Mehdi-Ldj/usb3-dock/docs/renders/board-3d-top.png

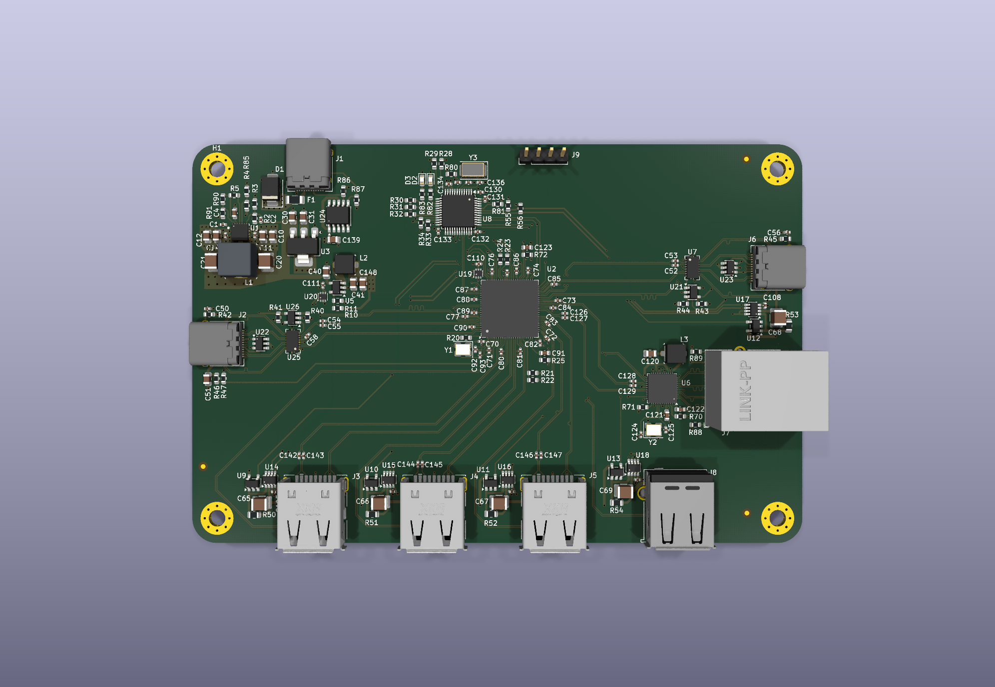
docs/renders/board-3d-top.png
