Mehdi-Ldj/usb3-dock/hardware/rev-a/usb3-dock-jlcpcb-bom.csv

Comment | Designator | Footprint | JLCPCB Part # | MPN
100n | C1,C50,C52,C53,C54,C55,C56,C58,C70,C71,C72,C73,C74,C75,C76,C77,C80,C81,C82,C83,C84,C85,C86,C87,C88,C89,C90,C105,C106,C107,C108,C109,C110,C111,C126,C127,C128,C129,C130,C131,C132,C133,C134,C138,C142,C143,C144,C145,C146,C147 | Capacitor_SMD:C_0402_1005Metric | C1525 | CL05B104KO5NNNC
100p | C2 | Capacitor_SMD:C_0402_1005Metric | C1546 | 0402CG101J500NT
4u7 | C4 | Capacitor_SMD:C_0603_1608Metric | C326580 | CC0603KRX5R8BB475
10u | C10,C11,C12,C30,C31,C40,C41,C51,C120,C141,C148 | Capacitor_SMD:C_0805_2012Metric | C380332 | TCC0805X5R106K160FT
100n | C13,C140 | Capacitor_SMD:C_0402_1005Metric | C307331 | CL05B104KB54PNC
100u | C20,C21,C65,C66,C67,C68,C69 | Capacitor_SMD:C_1210_3225Metric | C6120014 | CGA1210X5R107M160RT
1u | C91,C121,C122,C123 | Capacitor_SMD:C_0603_1608Metric | C696901 | TCC0603X5R105K160CT
18p | C92,C93,C124,C125,C136,C137 | Capacitor_SMD:C_0402_1005Metric | C1549 | 0402CG180J500NT
1u | C139 | Capacitor_SMD:C_0805_2012Metric | C89190 | 0805B105K250NT
SMBJ15A | D1 | Diode_SMD:D_SMB | C113988 | SMBJ15A
LED | D2,D3 | LED_SMD:LED_0603_1608Metric | C2286 | KT-0603R
3A | F1 | Fuse:Fuse_1206_3216Metric | C41342 | 0468003.NRHF
USB_C | J1,J2,J6 | Connector_USB:USB_C_Receptacle_Amphenol_12401610E4-2A | C5119948 | 12401610E4#2A
USB3_A | J3,J4,J5 | dock:USB_A_Receptacle_XKB_U231-091N-4BLRA00-S | C2880618 | U231-091N-4BLRA00-S
RJ45 MagJack | J7 | dock:RJ45_Hanrun_HR911130A | C54408 | HR911130A
USB_A | J8 | Connector_USB:USB_A_Molex_67643_Horizontal | C564920 | 67643-2910
SWD | J9 | Connector_PinHeader_2.54mm:PinHeader_1x04_P2.54mm_Vertical | C2691448 | PZ254V-11-04P
4u7 | L1 | dock:L_7.1x6.6mm_CMLO0650H | C439009 | CMLO0650H4R7MTT
2u2 | L2 | dock:L_4x4mm_PNR4020 | C54620130 | PNR4020-2R2M
3u3 | L3 | dock:L_4x4mm_FNR4030 | C167870 | FNR4030S3R3MT
73k2 | R2 | Resistor_SMD:R_0603_1608Metric | C14890 | 0603WAF7322T5E
56k | R4,R43,R44 | Resistor_SMD:R_0603_1608Metric | C23206 | 0603WAF5602T5E
100k | R10,R11,R28,R29,R30,R31,R32,R46,R47 | Resistor_SMD:R_0603_1608Metric | C25803 | 0603WAF1003T5E
12k | R20,R71 | Resistor_SMD:R_0603_1608Metric | C22790 | 0603WAF1202T5E
200k | R21,R23,R24,R90 | Resistor_SMD:R_0603_1608Metric | C25811 | 0603WAF2003T5E
10k | R3,R5,R25,R33,R34,R72,R80,R81,R85,R91 | Resistor_SMD:R_0603_1608Metric | C25804 | 0603WAF1002T5E
5k1 | R40,R41,R86,R87 | Resistor_SMD:R_0603_1608Metric | C23186 | 0603WAF5101T5E
330 | R42,R45,R88,R89 | Resistor_SMD:R_0603_1608Metric | C23138 | 0603WAF3300T5E
0R1 | R50,R51,R52,R53,R54 | Resistor_SMD:R_0805_2012Metric | C160917 | RL10FTNR100
4k7 | R55,R56 | Resistor_SMD:R_0603_1608Metric | C23162 | 0603WAF4701T5E
2k | R70 | Resistor_SMD:R_0603_1608Metric | C22975 | 0603WAF2001T5E
1k | R82,R83 | Resistor_SMD:R_0603_1608Metric | C21190 | 0603WAF1001T5E
TPS56C215 | U1 | dock:Texas_RNN0018A_TPS56C215 | C473372 | TPS56C215RNNR
USB5807C | U2 | dock:VQFN-100-1EP_12x12mm_P0.4mm_EP8x8mm | C628616 | USB5807CT/KD
TLV76133 | U3 | Package_TO_SOT_SMD:SOT-223-3_TabPin2 | C7527500 | TLV76133DCYR
TLV62569 | U5 | Package_TO_SOT_SMD:SOT-23-5 | C141836 | TLV62569DBVR
LAN7800 | U6 | dock:QFN-48-1EP_6x6mm_P0.4mm_EP4.3x4.3mm | C625080 | LAN7800T-I/VSX
STM32F072C8 | U8 | Package_QFP:LQFP-48_7x7mm_P0.5mm | C80488 | STM32F072C8T6
TPS2065 | U9,U10,U11,U12,U13 | Package_TO_SOT_SMD:SOT-23-5 | C133792 | TPS2065DBVR
INA219 | U14,U15,U16,U17,U18 | Package_TO_SOT_SMD:SOT-23-8 | C87469 | INA219AIDCNR
TMP112 | U19,U20 | Package_TO_SOT_SMD:SOT-563 | C3019123 | TMP112BIDRLR
TLV7031 | U21,U26 | Package_TO_SOT_SMD:SOT-23-5 | C2869832 | TLV7031DBVR
SRV05-4 | U22,U23 | Package_TO_SOT_SMD:SOT-23-6 | C13612 | SRV05-4.TCT
CH224A | U24 | Package_SO:SSOP-10-1EP_3.9x4.9mm_P1mm_EP2.1x3.3mm | C42459160 | CH224A
HD3SS3212 | U7,U25 | dock:DHVQFN-20-1EP_2.5x4.5mm_P0.5mm_EP1x3mm_TI | C544517 | HD3SS3212IRKSR
25 MHz | Y1,Y2 | Crystal:Crystal_SMD_3225-4Pin_3.2x2.5mm | C70582 | X322525MMB4SI
8 MHz | Y3 | Crystal:Crystal_SMD_5032-2Pin_5.0x3.2mm | C115962 | X50328MSB2GI
