Mehdi-Ldj/usb3-dock/hardware/rev-a/3dmodels/lpjg0806fbnl.stp

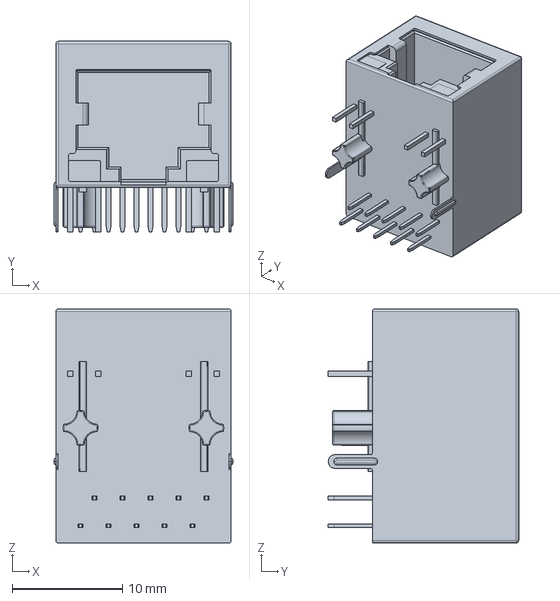
[picture p8: CAD file, 2026-11-11]
hardware/rev-a/3dmodels/lpjg0806fbnl.stp
16.2 x 17.3 x 21.2 mm
LPJGXXXXFBNL-490
1X1-TAB-DOWN-213MM-PCB10-P490-L
