Mehdi-Ldj/usb3-dock/hardware/rev-a/3dmodels/U7_HD3SS3212_RKS0020A.stp

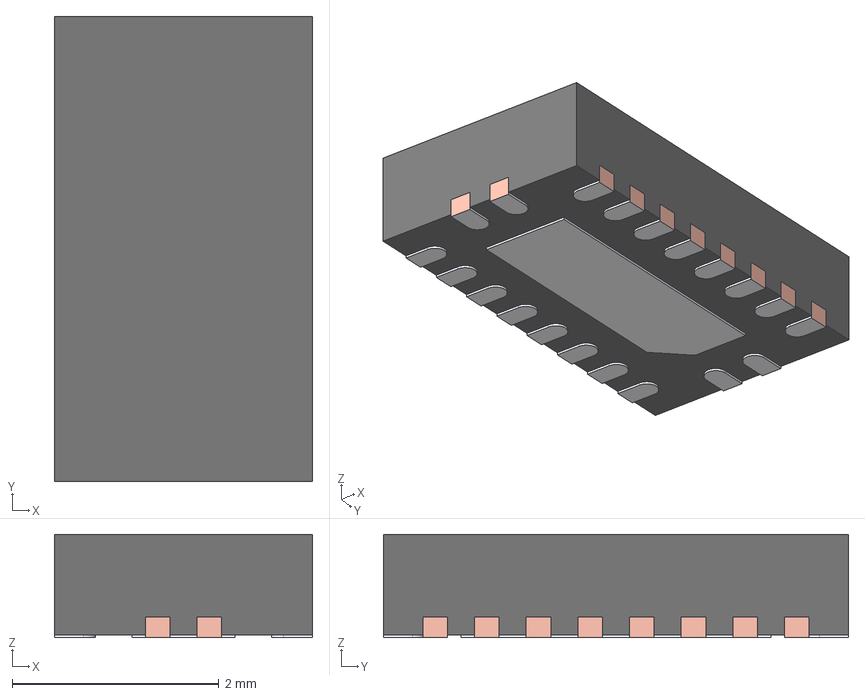
[picture p9: CAD file, 2026-11-11]
hardware/rev-a/3dmodels/U7_HD3SS3212_RKS0020A.stp
2.50 x 4.50 x 1.00 mm
BODY-QFN
FRAME-RKS0020A
PIN1-ID
