Mehdi-Ldj/usb3-dock/hardware/rev-a/3dmodels/J3_XKB_U231-091N.stp

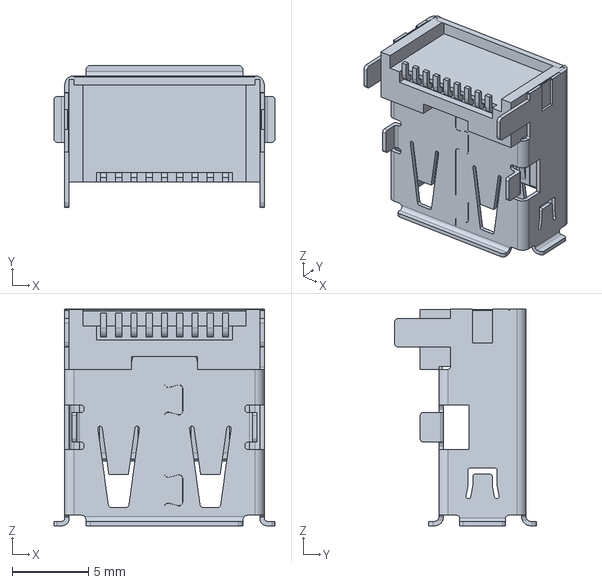
[picture p10: CAD file, 2026-11-11]
hardware/rev-a/3dmodels/J3_XKB_U231-091N.stp
14.5 x 9.34 x 14.2 mm
