Mehdi-Ldj/usb3-dock/hardware/rev-a/3dmodels/U1_TPS56C215_RNN0018A.stp

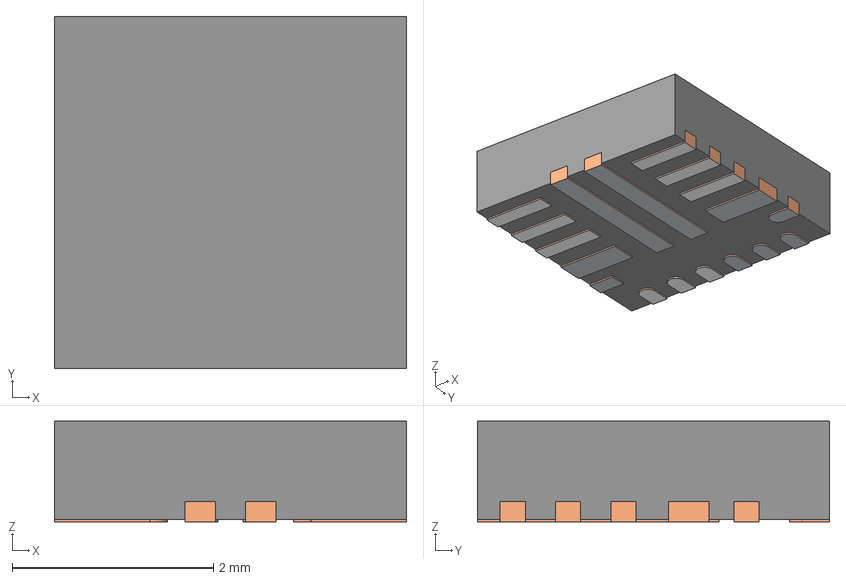
[picture p11: CAD file, 2026-11-11]
hardware/rev-a/3dmodels/U1_TPS56C215_RNN0018A.stp
3.50 x 3.50 x 1.00 mm
FRAME-RNN0018A
BODY-QFN
PIN1-ID
