Mehdi-Ldj/usb3-dock/hardware/rev-a/3dmodels/U2_USB5807C_VQFN100.step

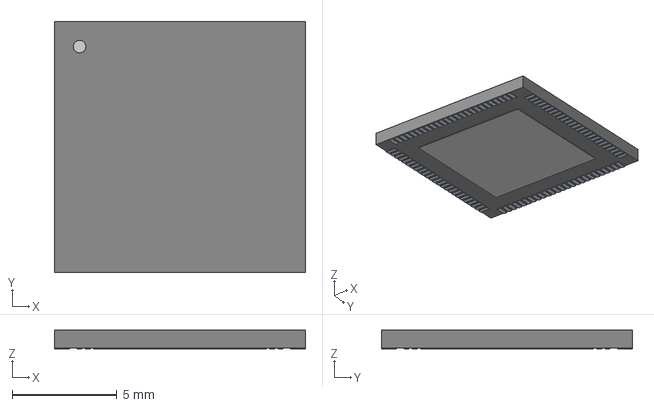
[picture p12: CAD file, 2026-11-11]
hardware/rev-a/3dmodels/U2_USB5807C_VQFN100.step
12.0 x 12.0 x 0.892 mm
