Mehdi-Ldj/usb3-dock/hardware/rev-a/3dmodels/U6_LAN7800_SQFN48.step

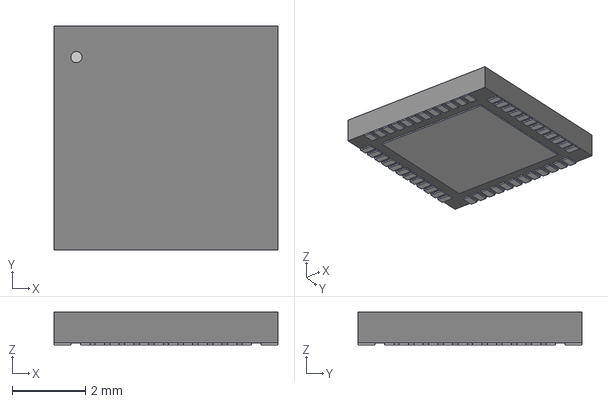
[picture p13: CAD file, 2026-11-11]
hardware/rev-a/3dmodels/U6_LAN7800_SQFN48.step
6.10 x 6.10 x 0.892 mm
