Mehdi-Ldj/usb3-dock/docs/renders/schematic-rev-a.pdf

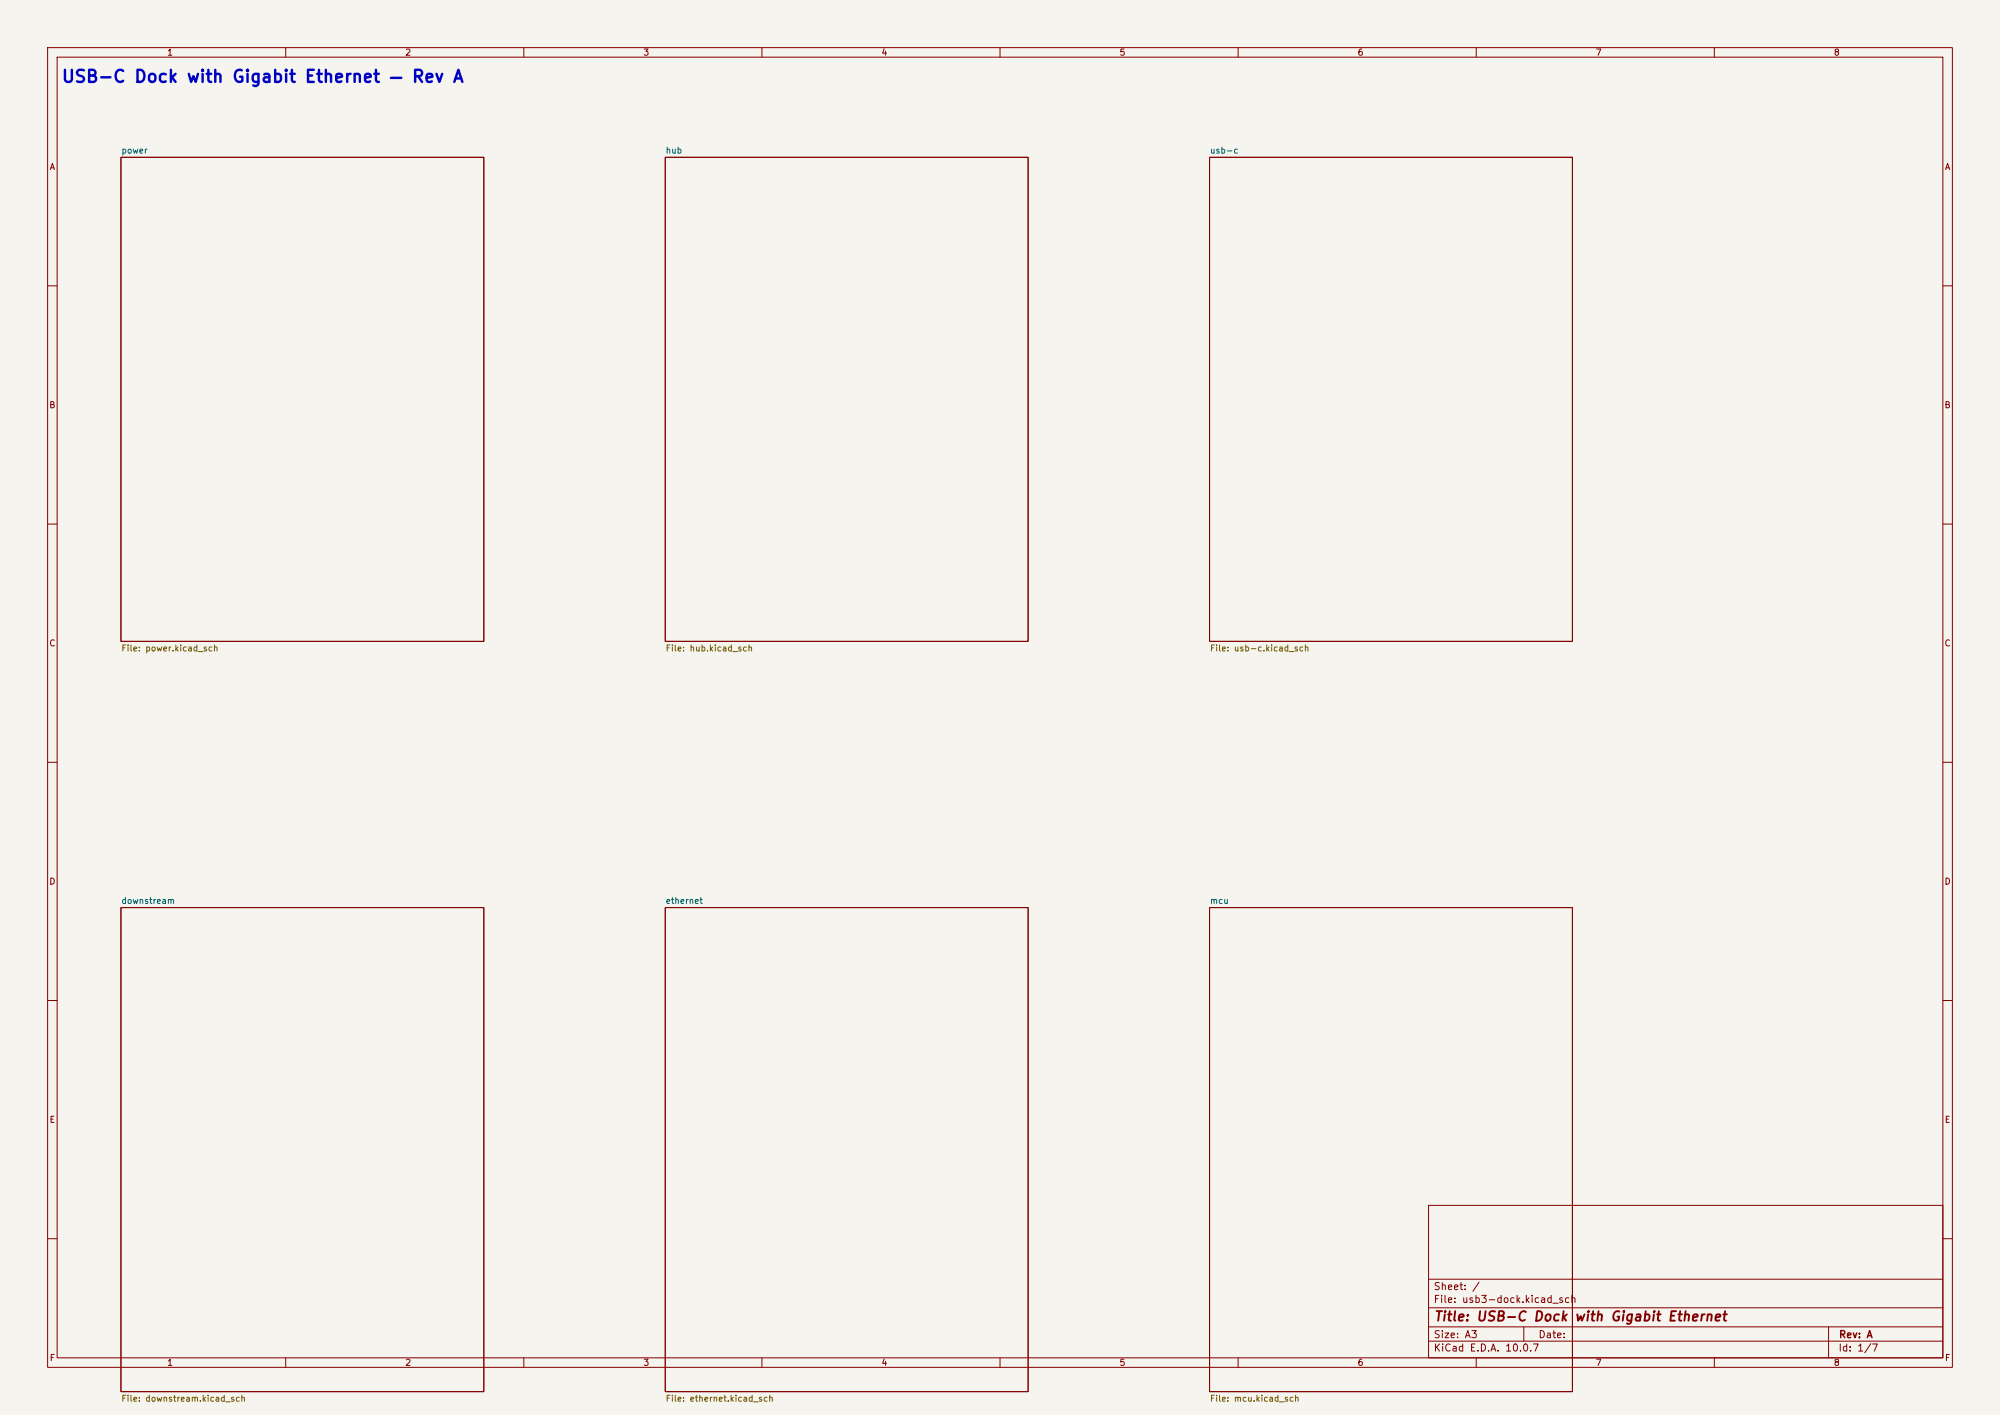
[picture p14: page 1]

USB-C Dock with Gigabit Ethernet — Rev A

Sheet: / File: usb3-dock.kicad_sch

Title: USB-C Dock with Gigabit Ethernet
Size: A3 | Rev: A | F Date:
KiCad E.D.A. 10.0.7 | Id: 1/7

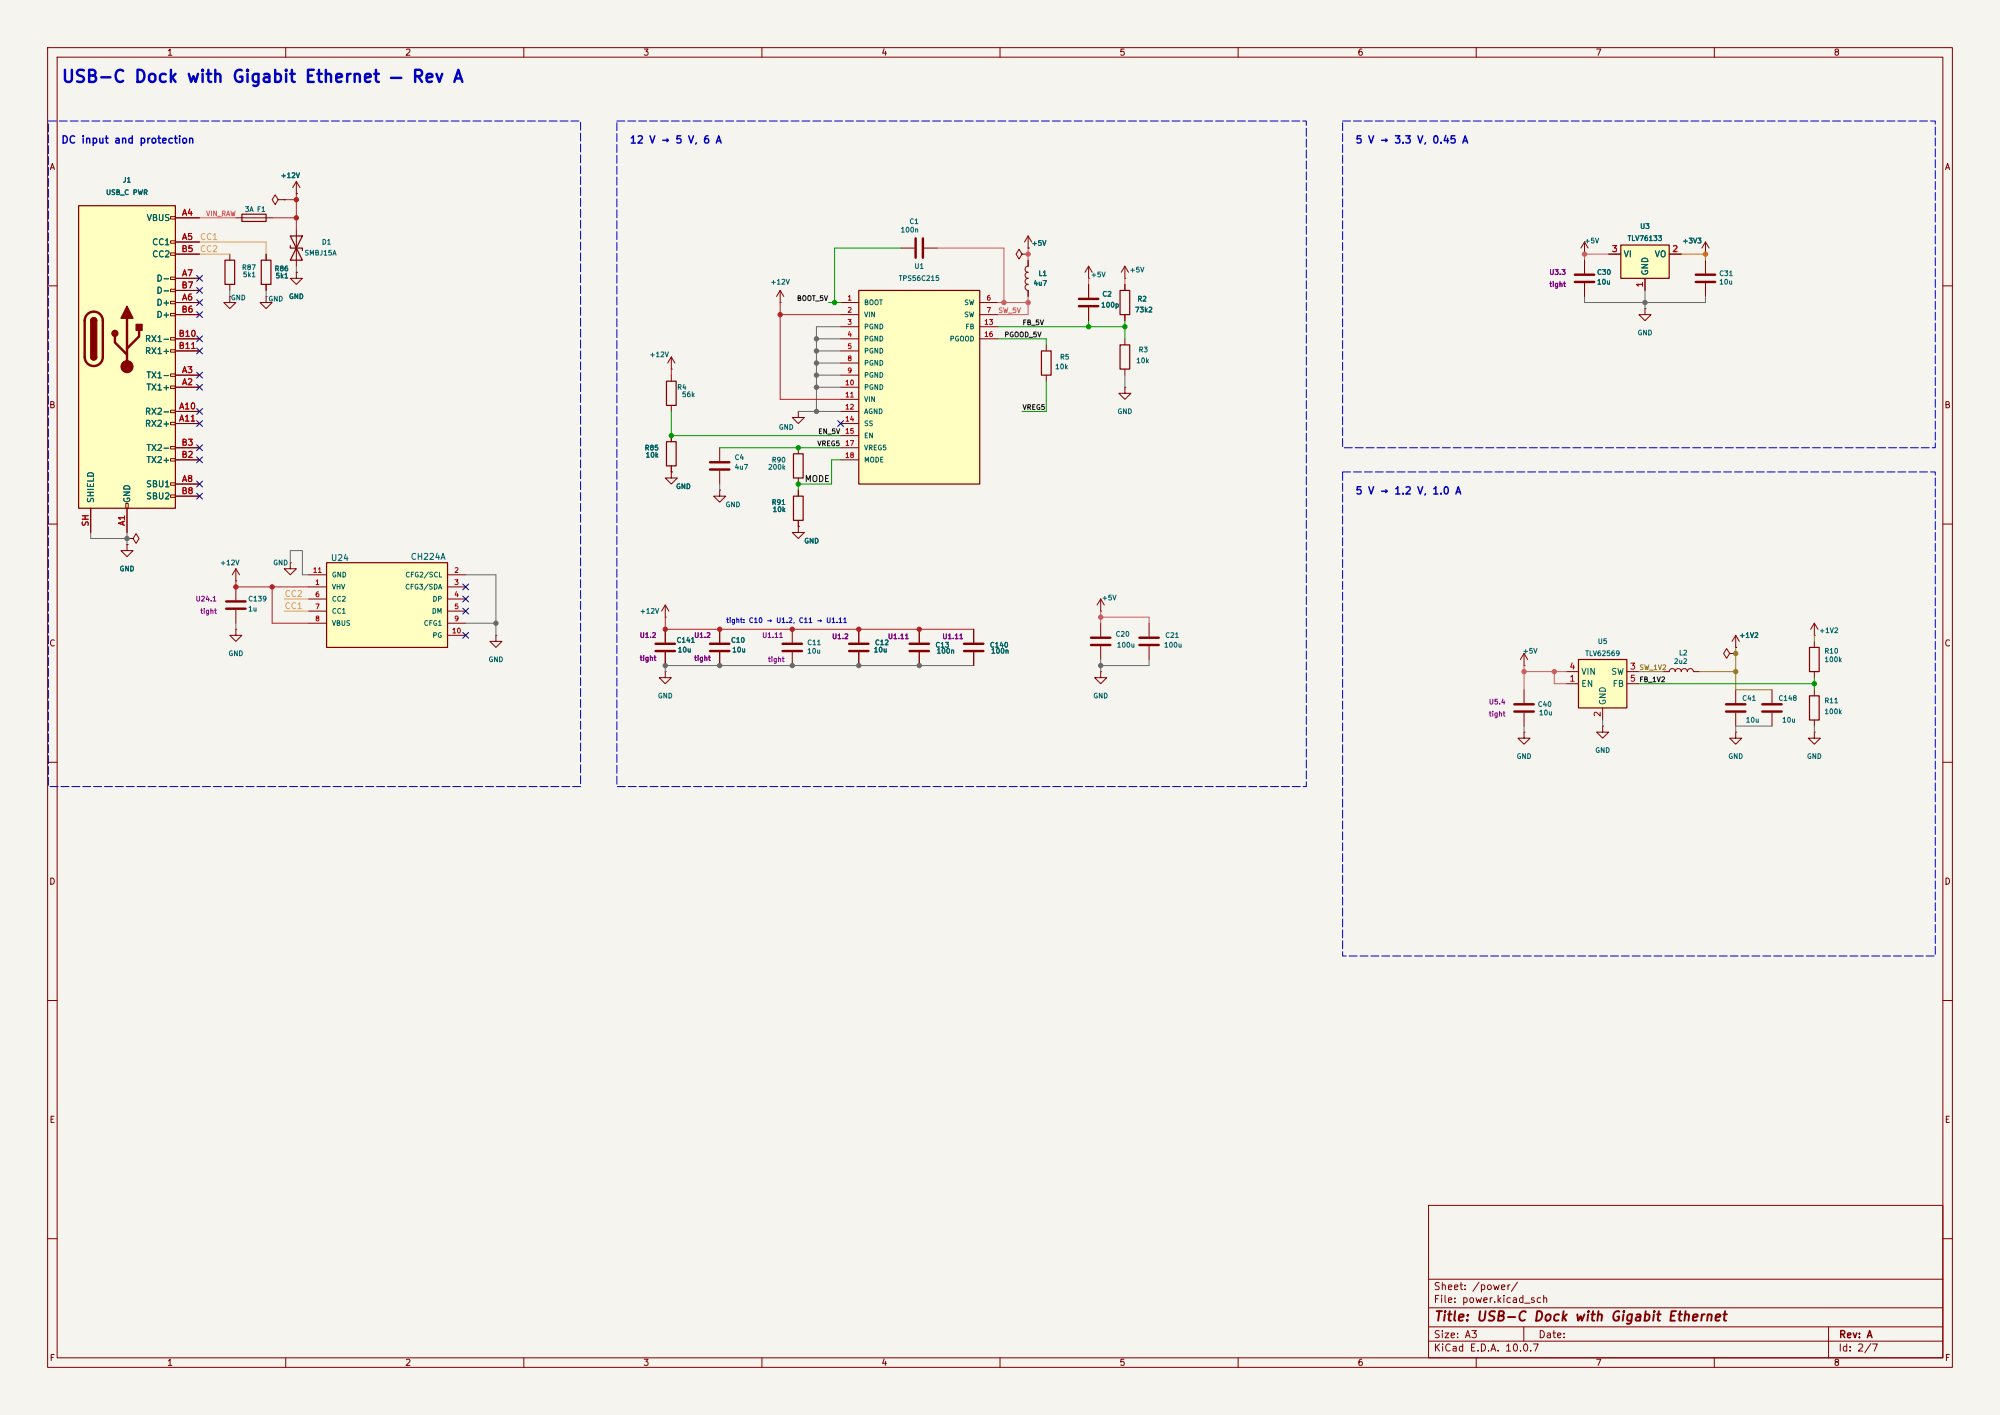
[picture p15: page 2]

tight: C10 → U1.2, C11 → U1.11 USB-C Dock with Gigabit Ethernet — Rev A

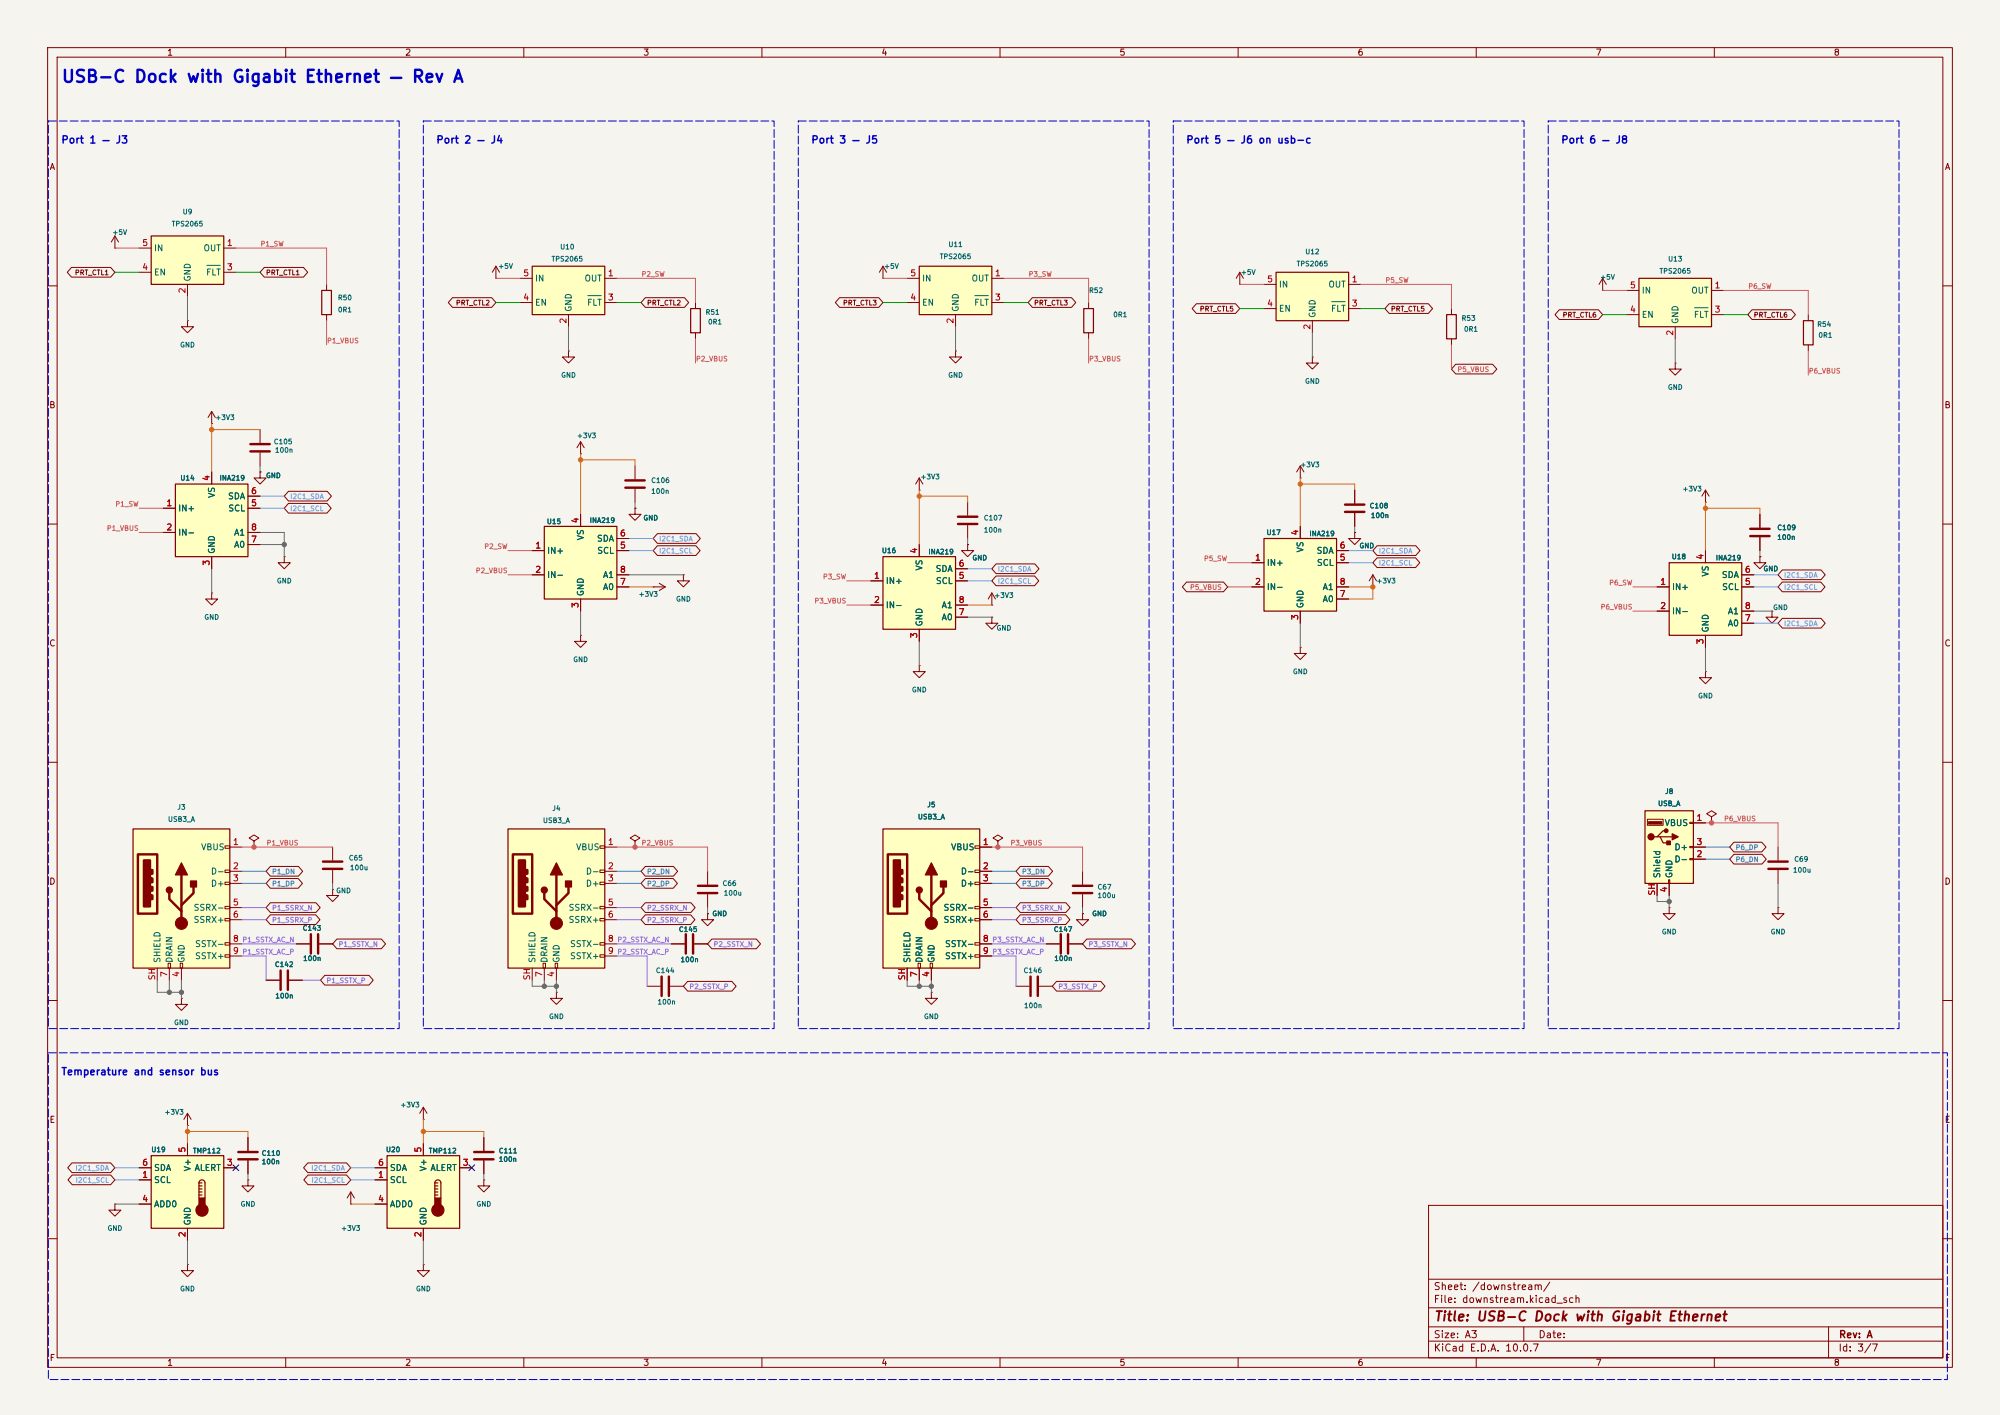
[picture p16: page 3]

P2_VBUS Temperature and sensor bus

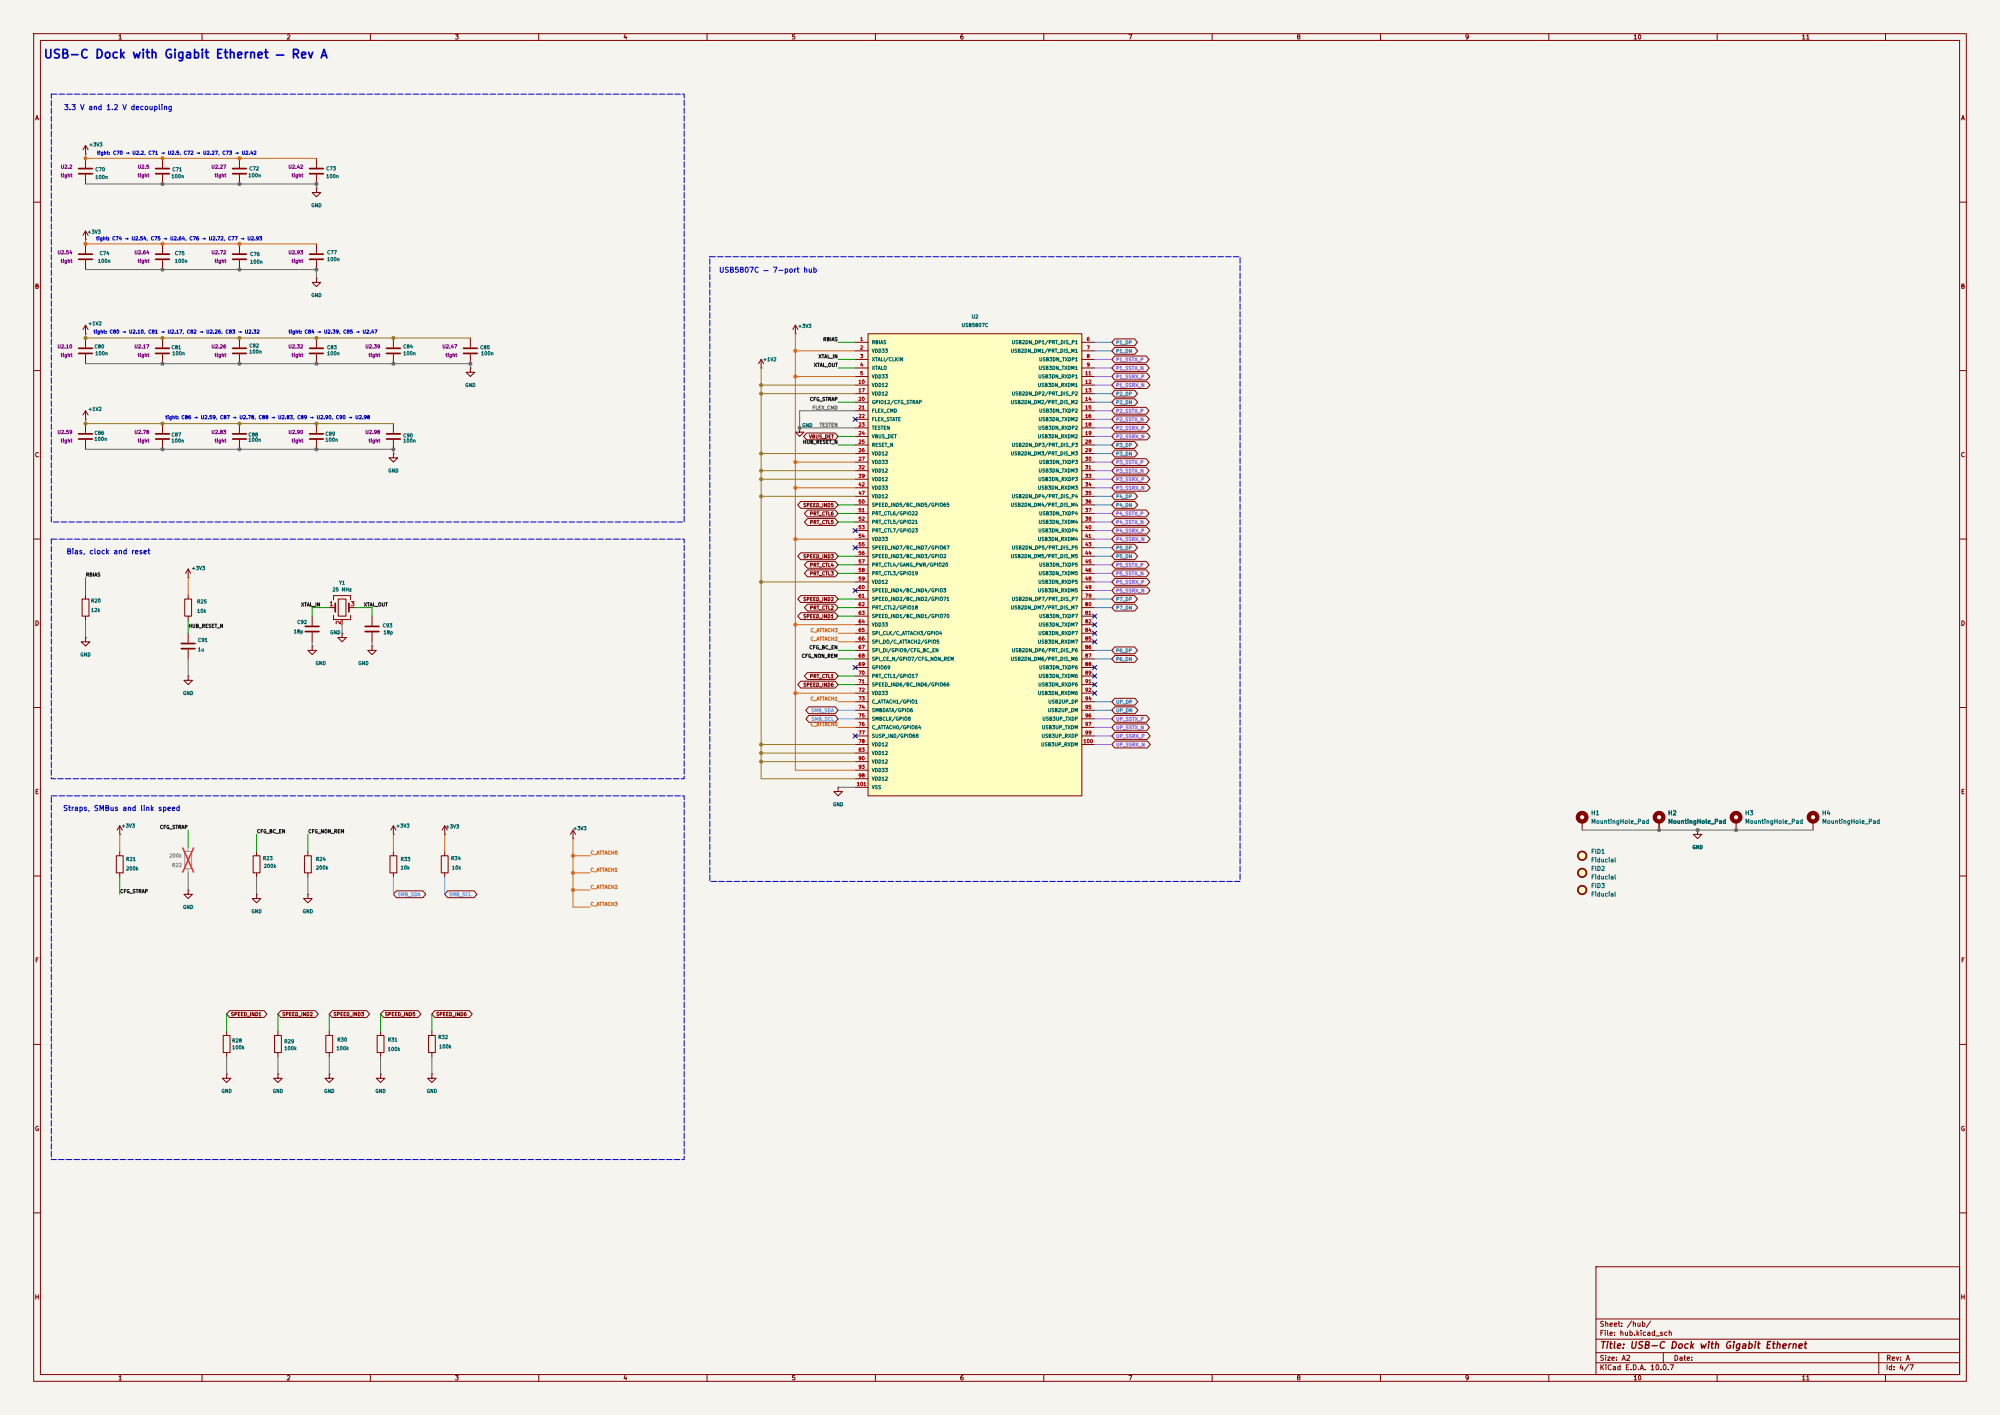
[picture p17: page 4]

tight: C74 → U2.54, C75 → U2.64, C76 → U2.72, C77 → U2.93 USB-C Dock with Gigabit Ethernet — Rev A

Bias, clock and reset

Straps, SMBus and link speed

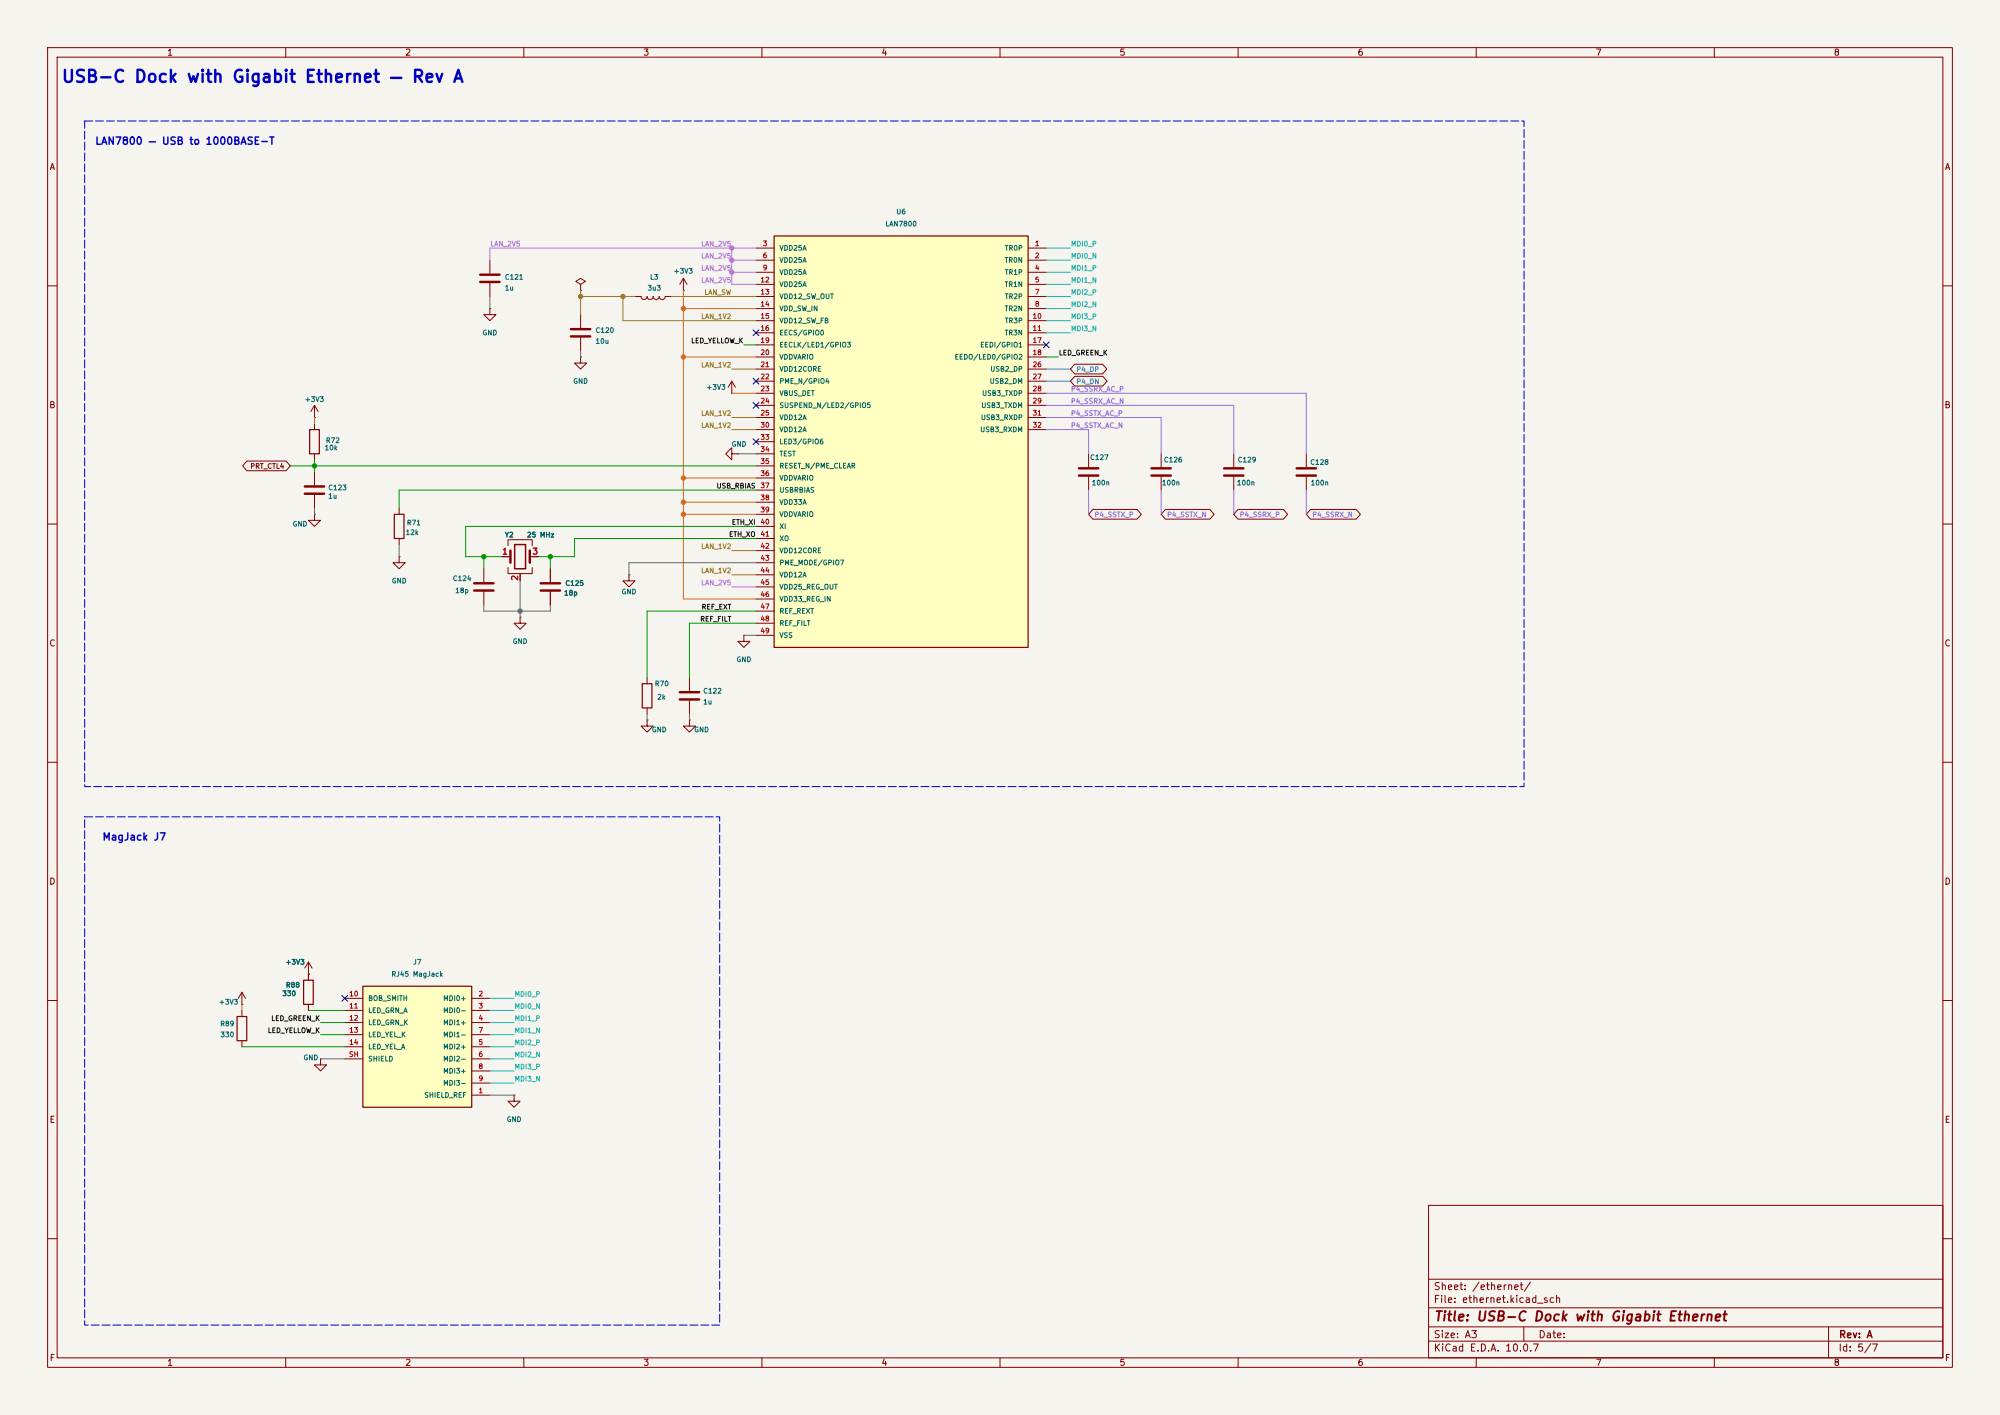
[picture p18: page 5]

ETH_XO | XO 41

LAN_1V2 | VDD12CORE 42 PME_MODE/GPIO7 43

LAN_1V2 | VDD12A 44

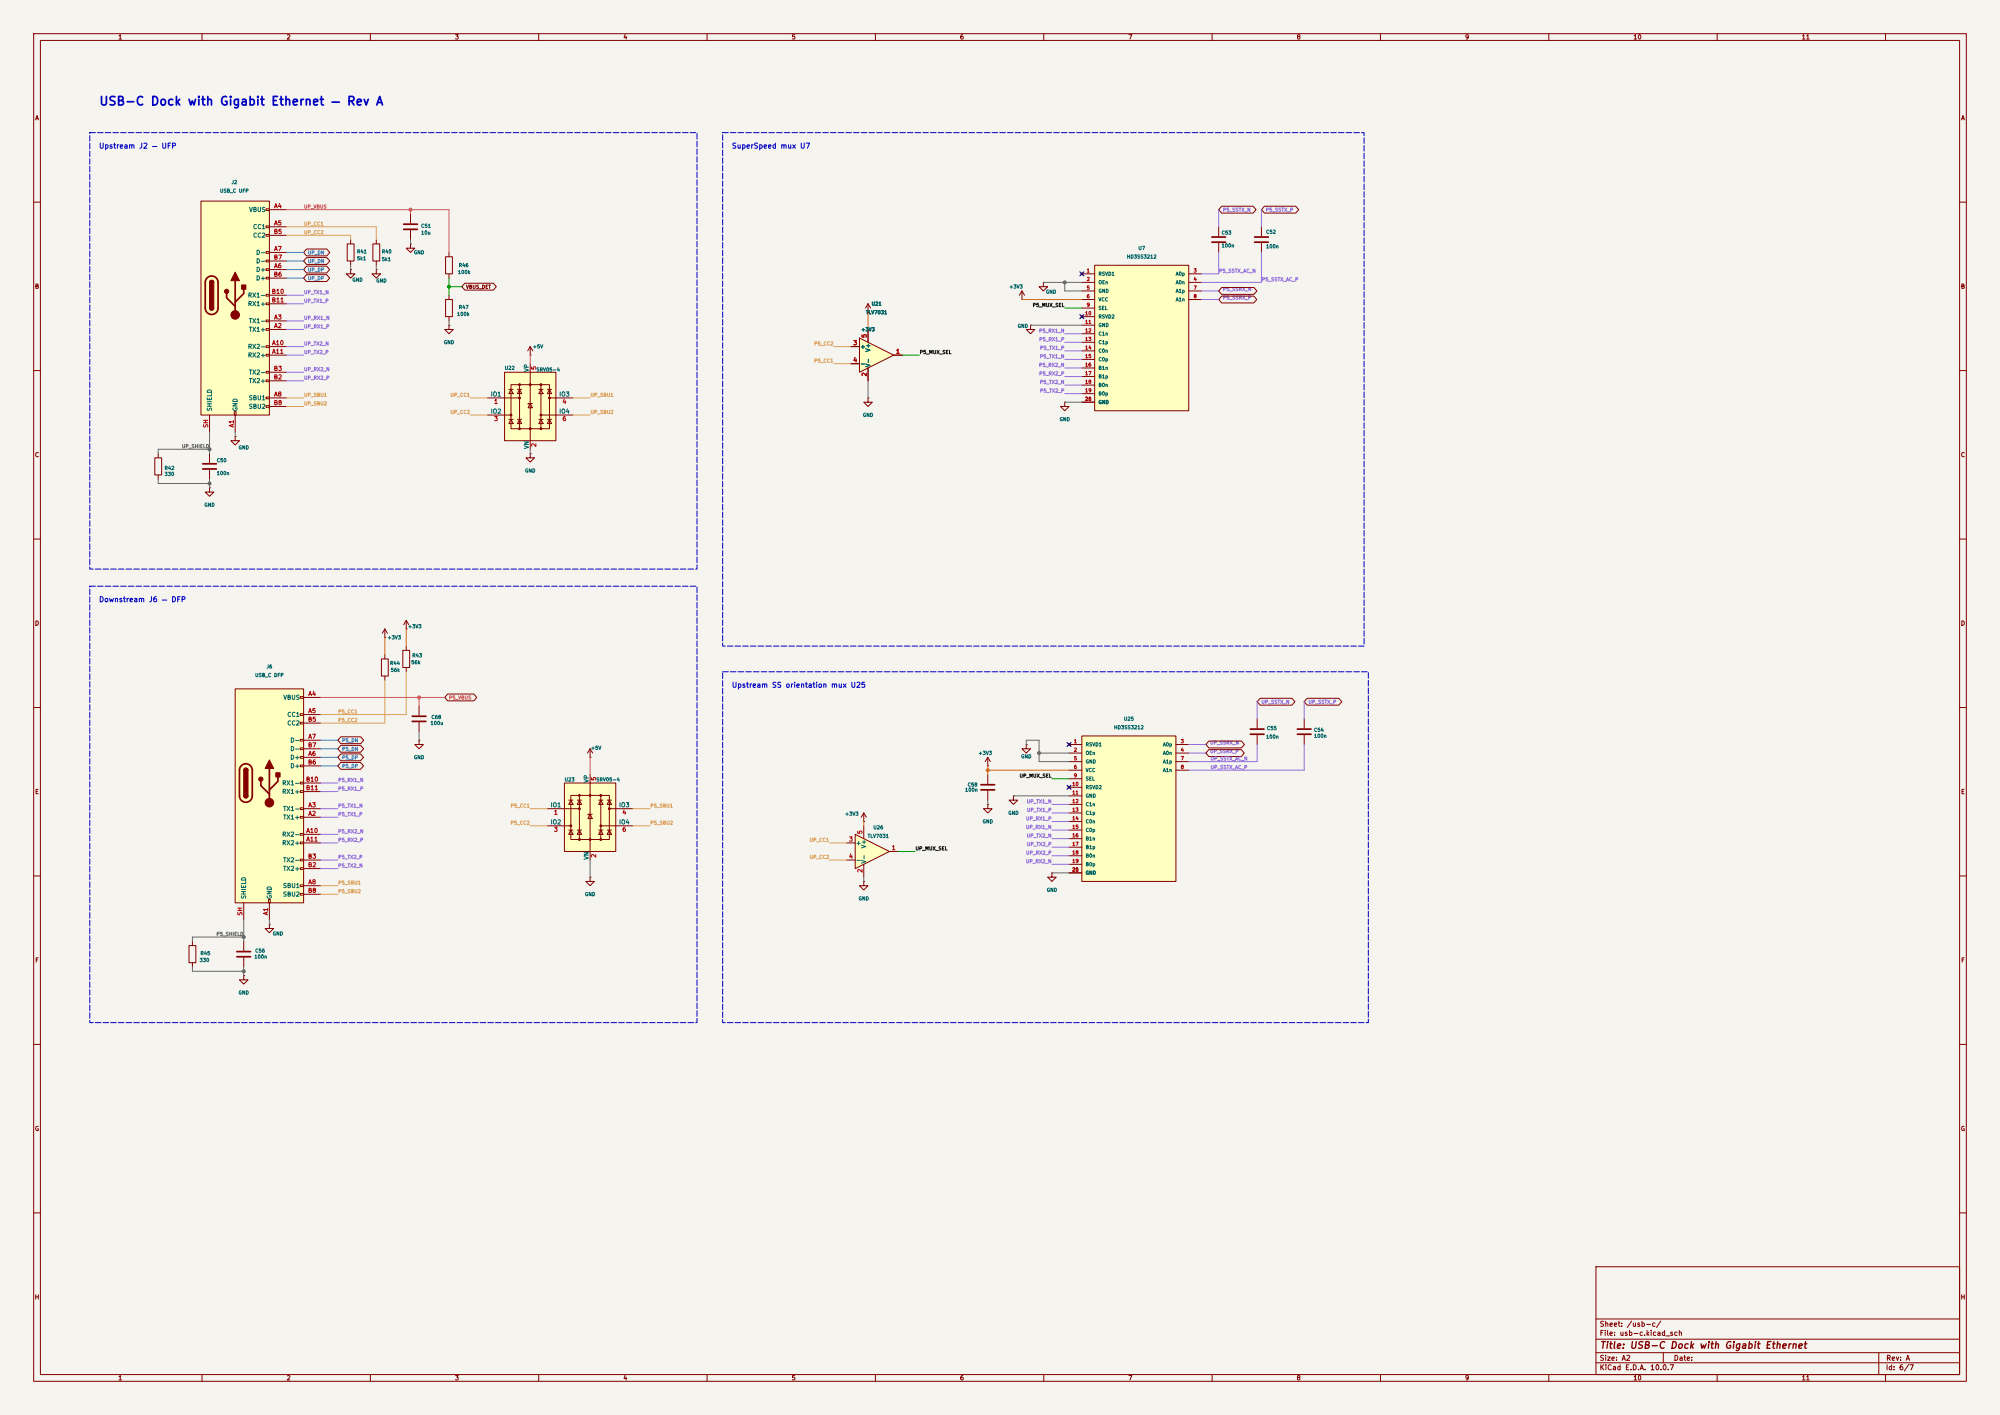
[picture p19: page 6]

Upstream SS orientation mux U25

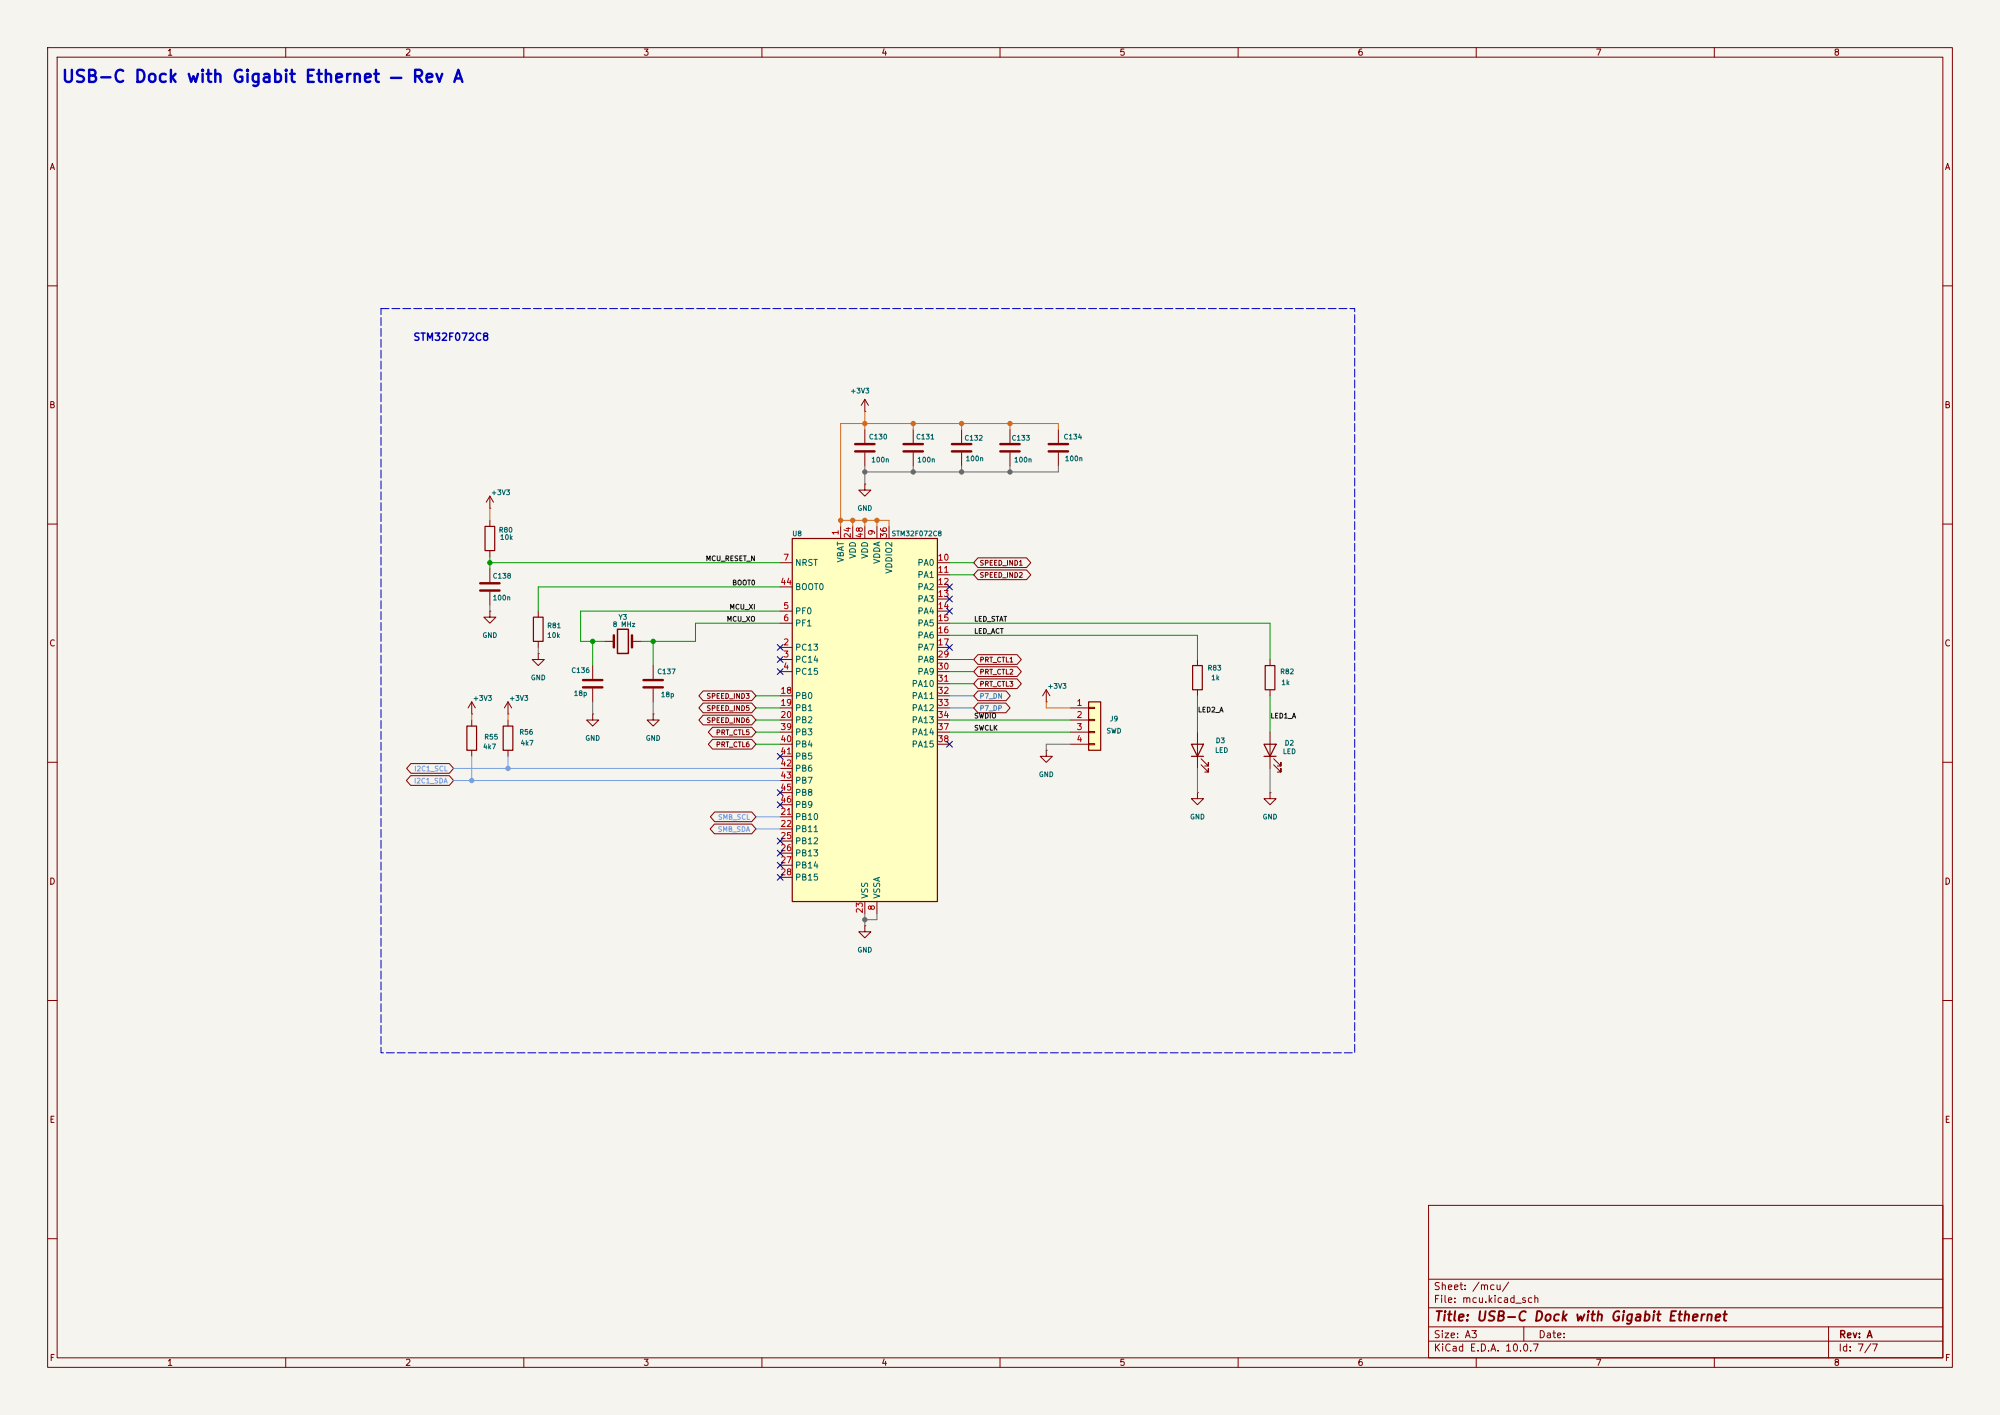
[picture p20: page 7]

LED_ACT USB-C Dock with Gigabit Ethernet — Rev A
