Mehdi-Ldj/usb3-dock/hardware/rev-a/usb3-dock.kicad_pcb

## KiCad design hardware/rev-a/usb3-dock.kicad_pcb (2026-11-11)

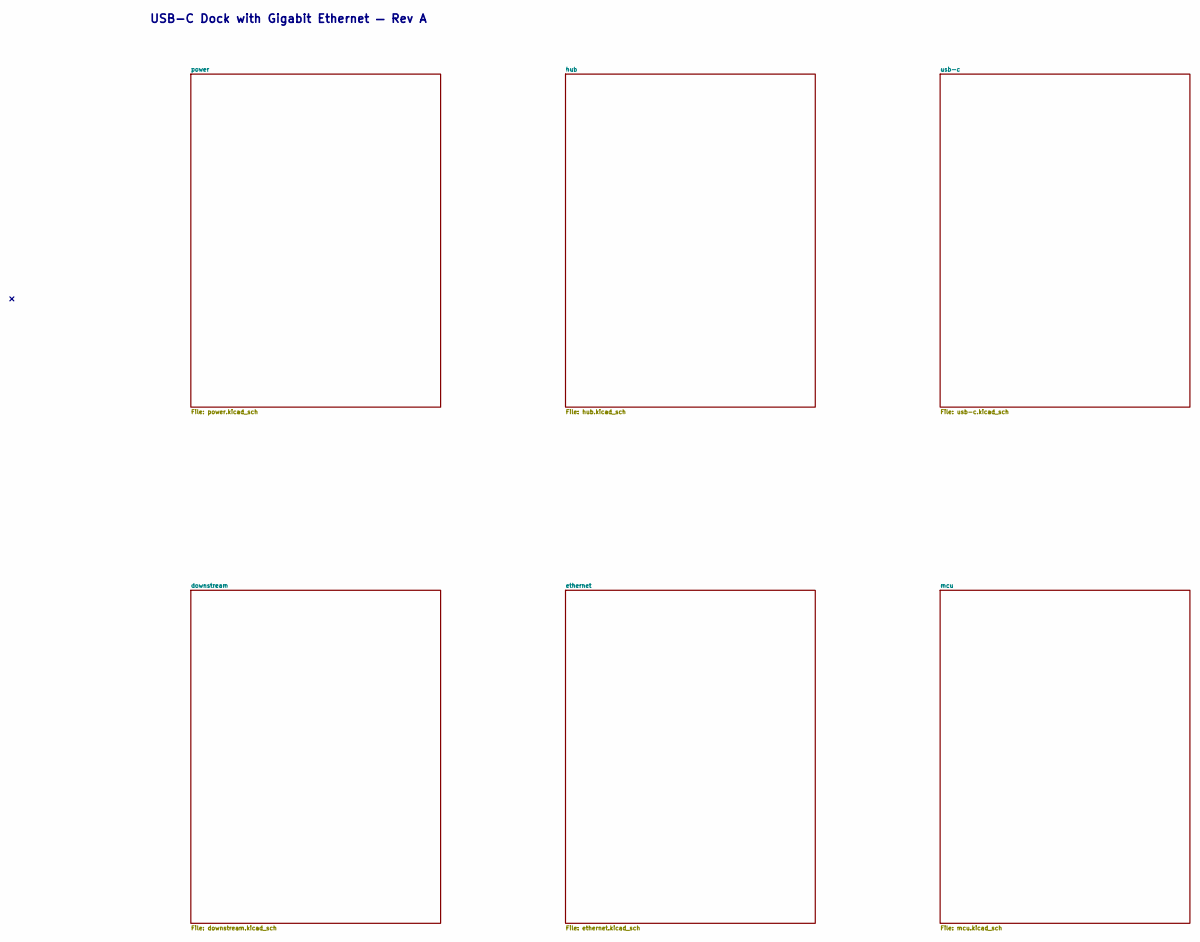
[picture p21: schematic usb3-dock.kicad_sch, USB-C Dock with Gigabit Ethernet]

Notes on the sheet:
USB-C Dock with Gigabit Ethernet — Rev A

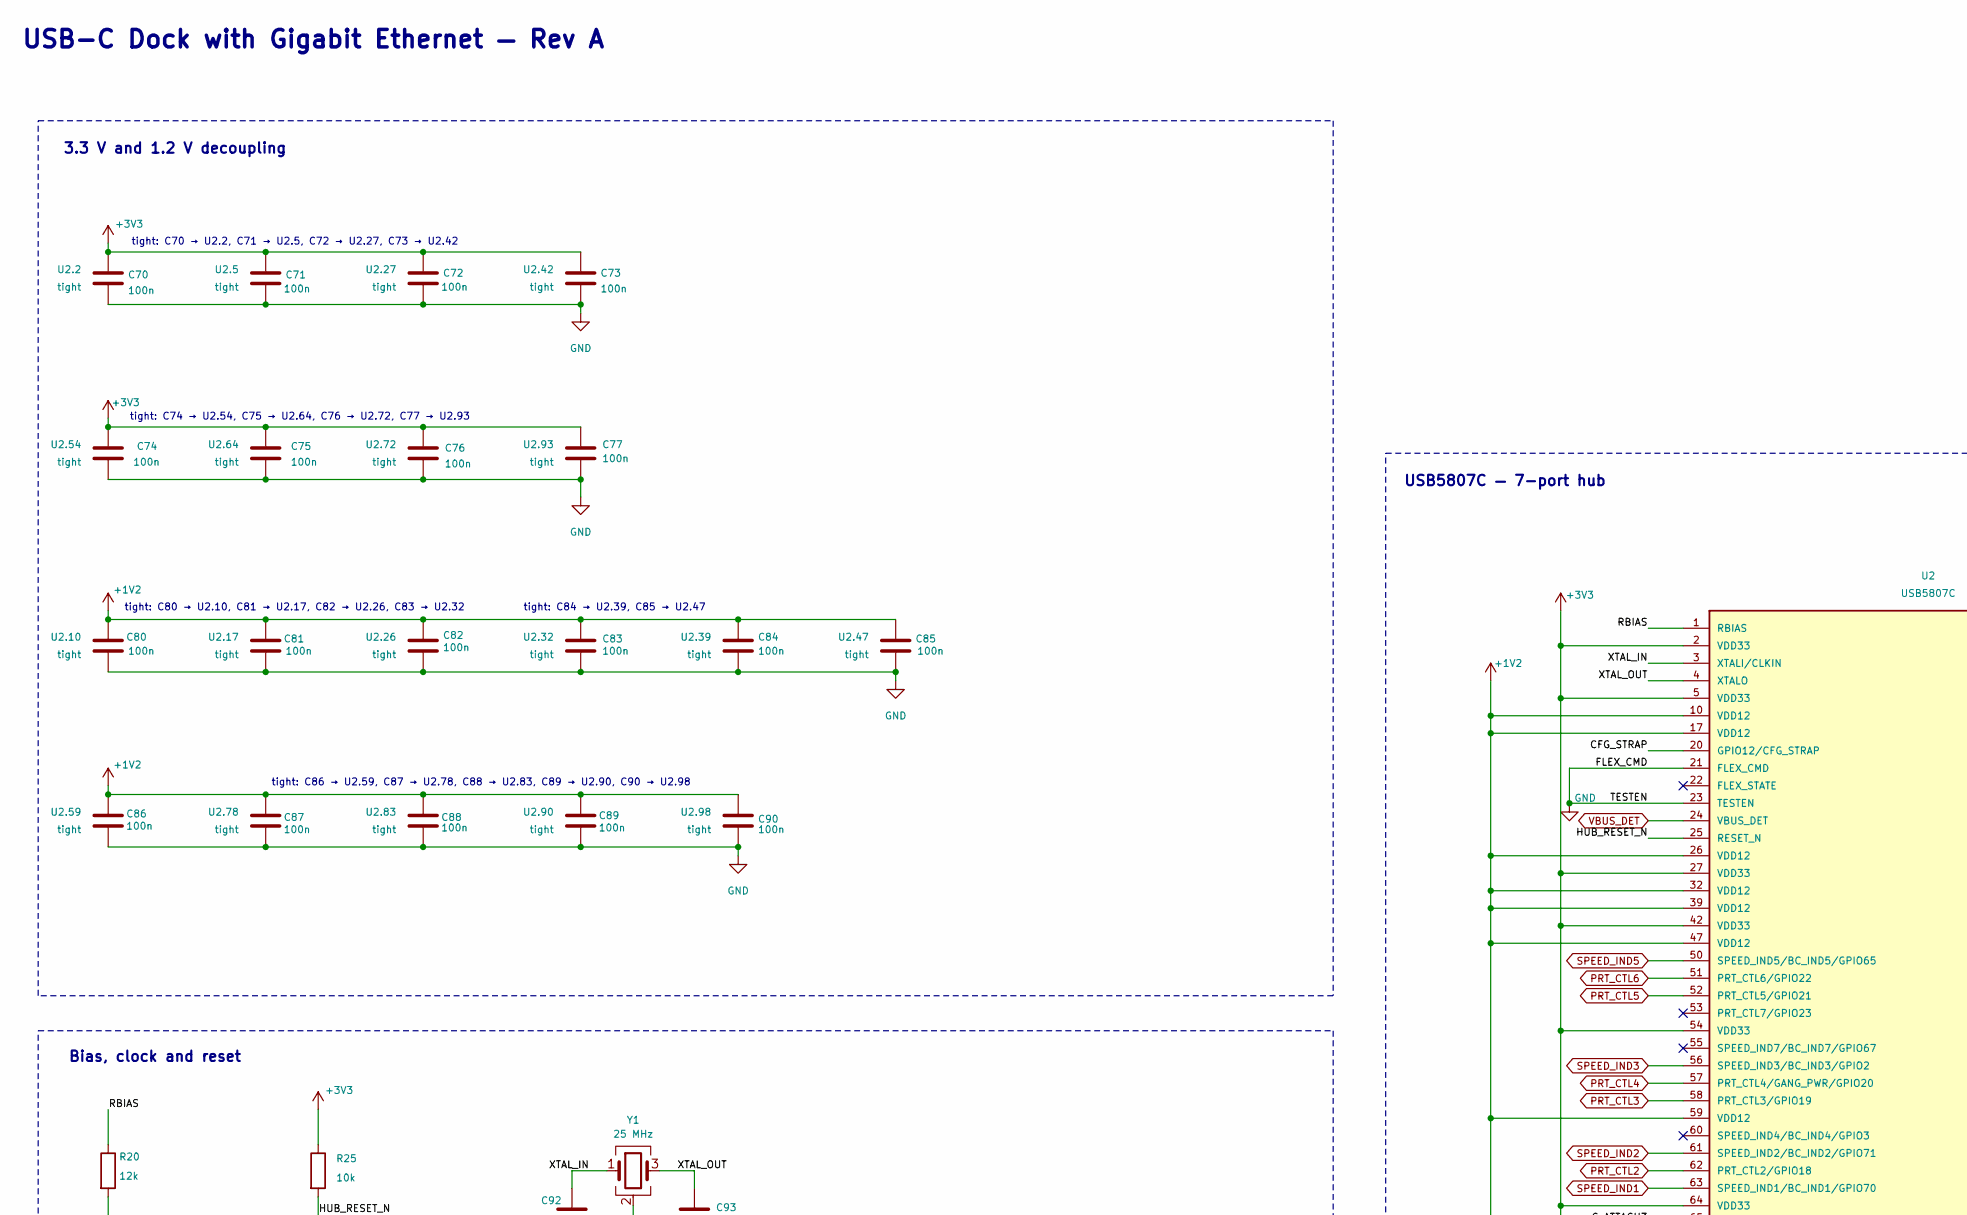
[picture p22: schematic hub.kicad_sch, USB-C Dock with Gigabit Ethernet, part in row 1, column 1]

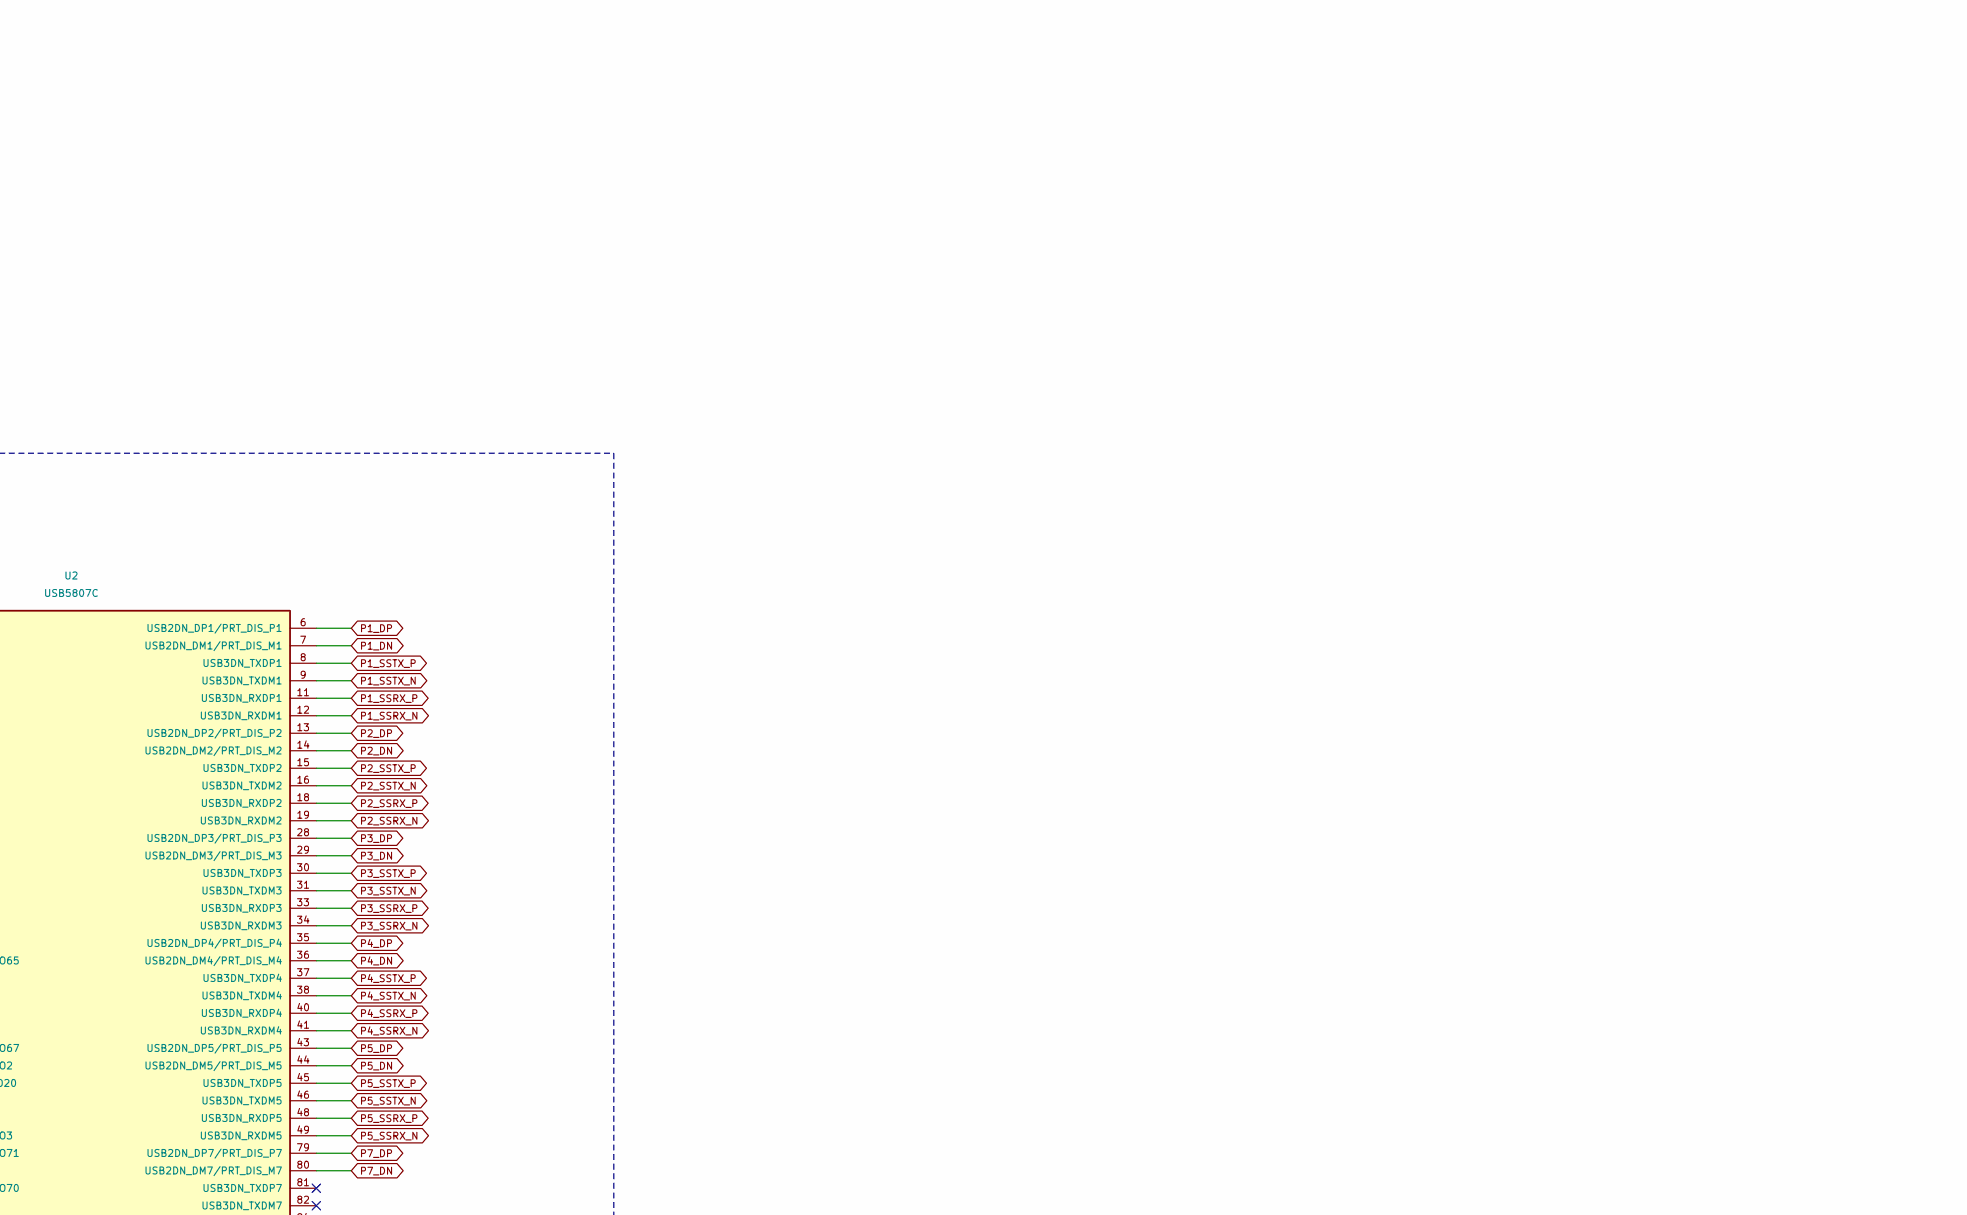
[picture p23: schematic hub.kicad_sch, USB-C Dock with Gigabit Ethernet, part in row 1, column 2]

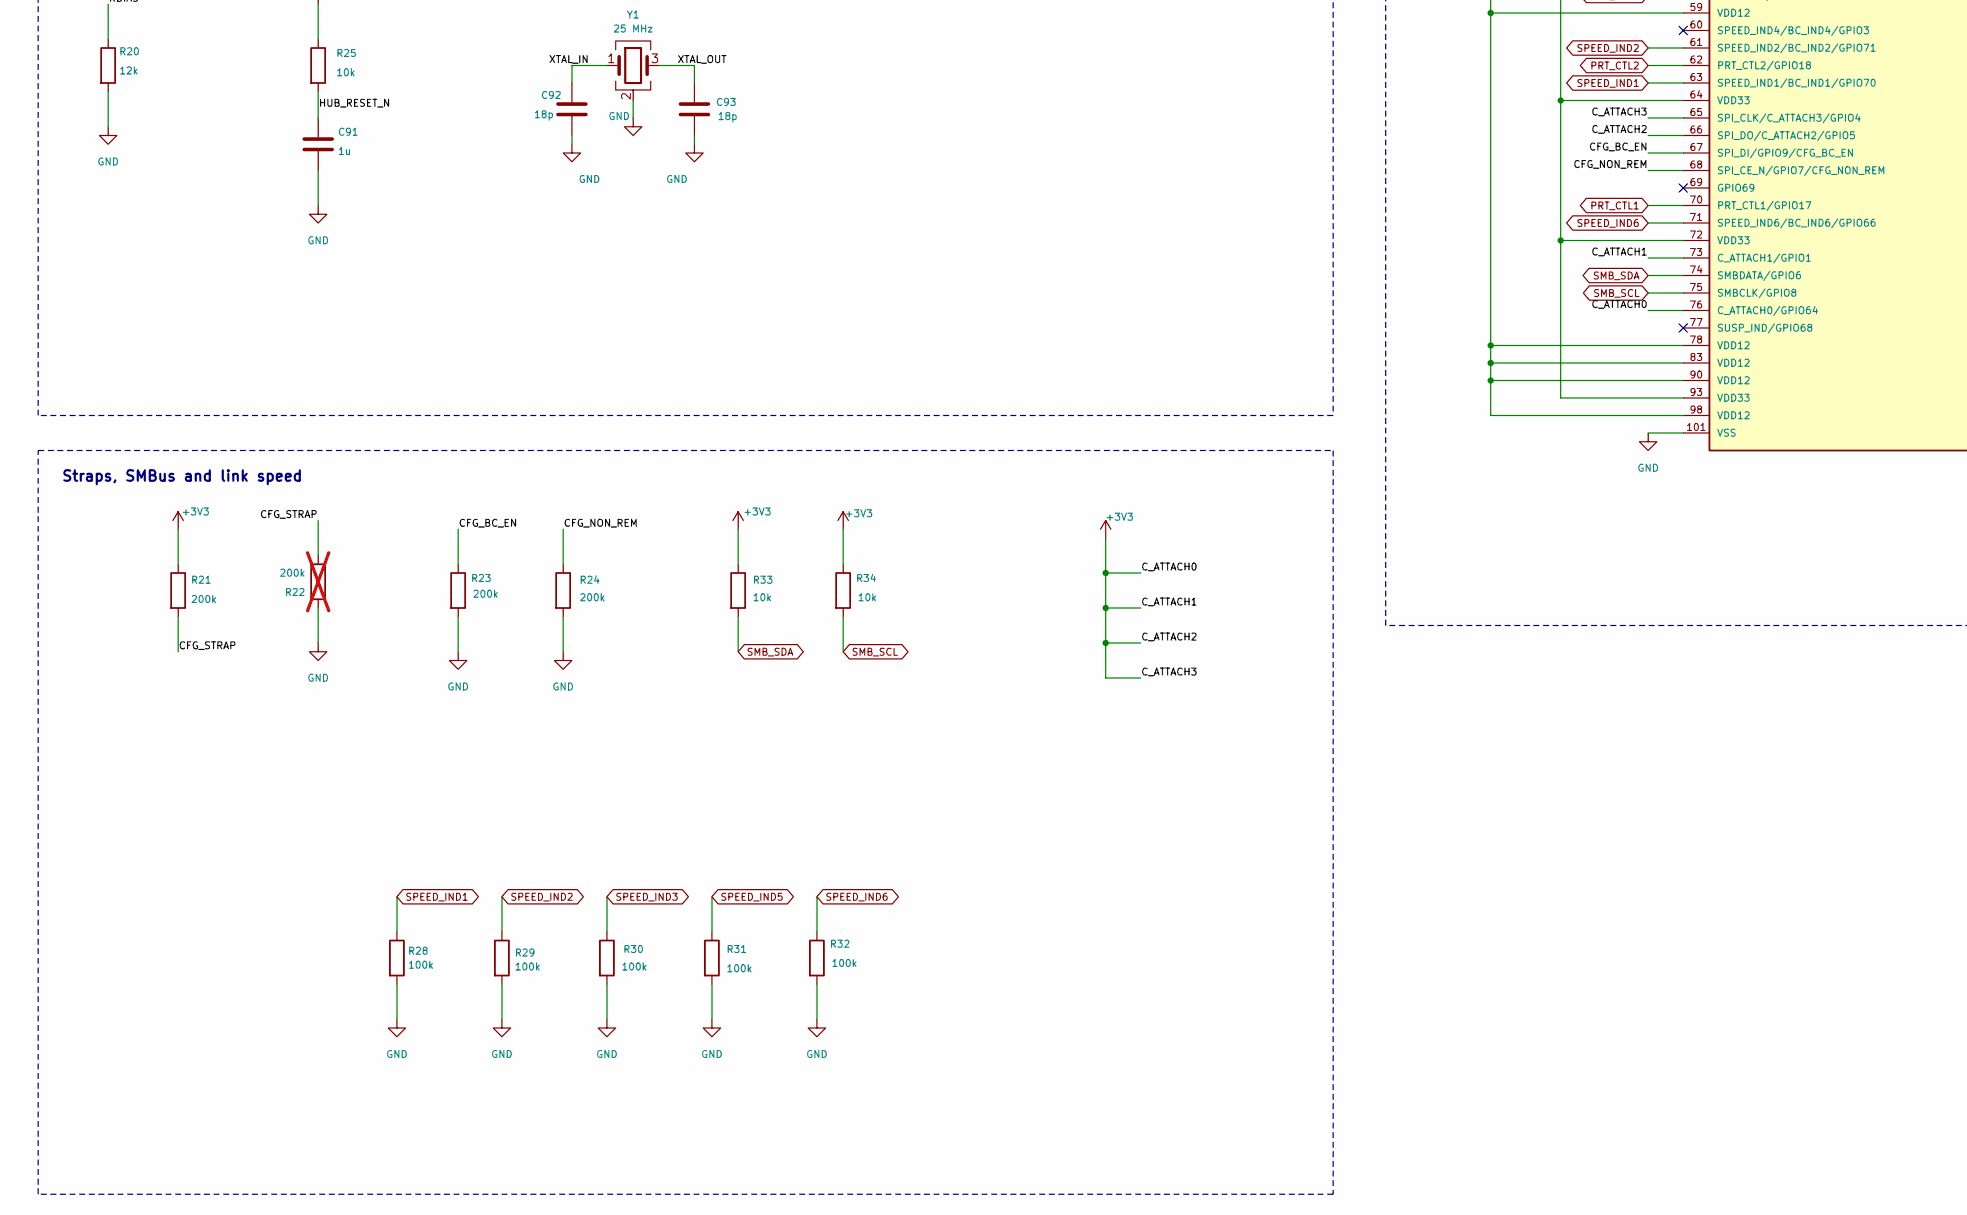
[picture p24: schematic hub.kicad_sch, USB-C Dock with Gigabit Ethernet, part in row 2, column 1]

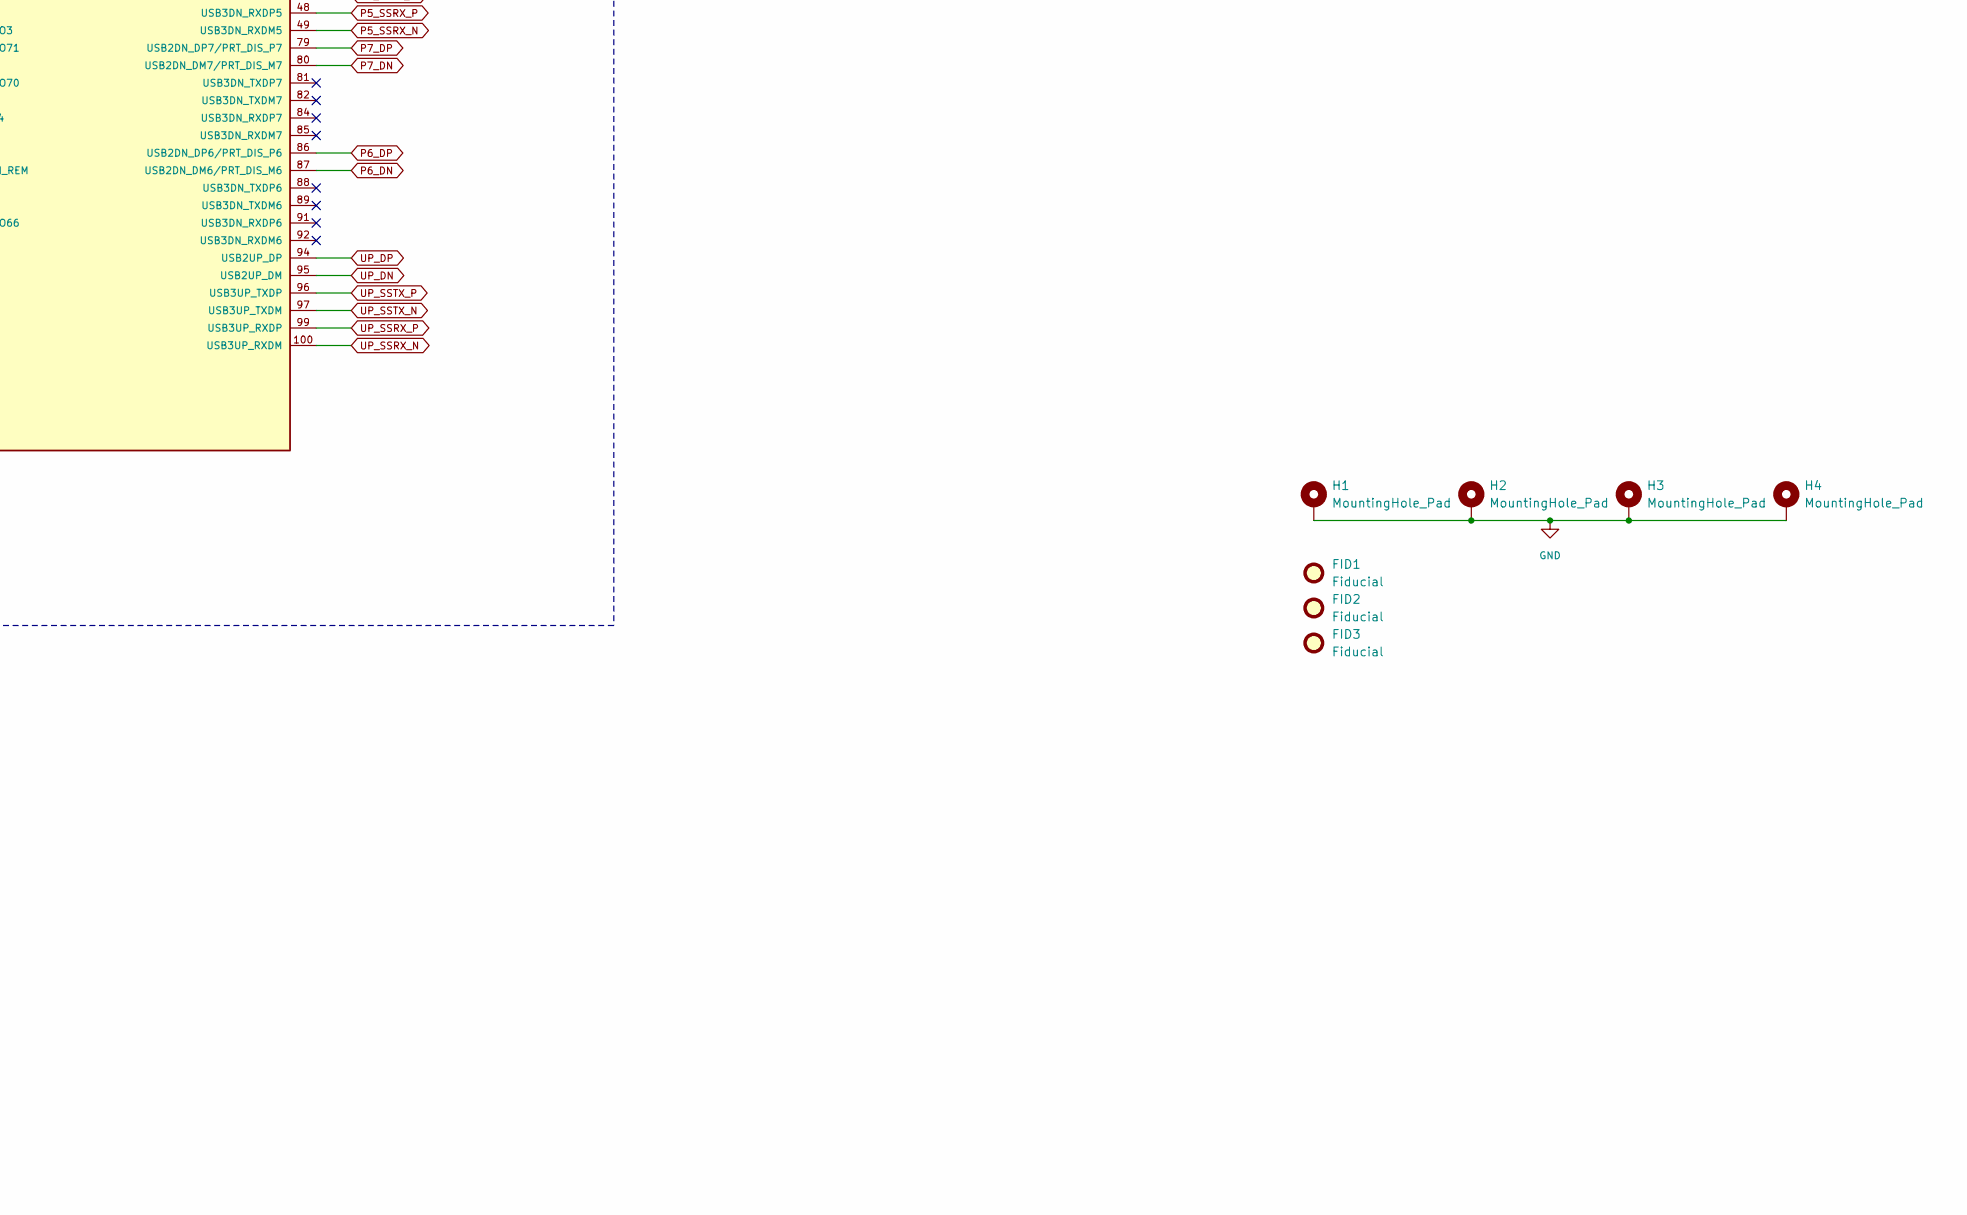
[picture p25: schematic hub.kicad_sch, USB-C Dock with Gigabit Ethernet, part in row 2, column 2]

Parts:
C70, C71, C72, C73, C74, C75, C76, C77, C80, C81, C82, C83, C84, C85, C86, C87, C88, C89, C90: 100n; C_0402_1005Metric
C91: 1u; C_0603_1608Metric
C92, C93: 18p; C_0402_1005Metric
FID1, FID2, FID3: Fiducial; Fiducial_1mm_Mask2mm
H1, H2, H3, H4: MountingHole_Pad; MountingHole_3.5mm_Pad_Via
R20: 12k; R_0603_1608Metric
R21, R23, R24: 200k; R_0603_1608Metric
R22: 200k; R_0603_1608Metric; not fitted
R25, R33, R34: 10k; R_0603_1608Metric
R28, R29, R30, R31, R32: 100k; R_0603_1608Metric
U2: USB5807C; VQFN-100-1EP_12x12mm_P0.4mm_EP8x8mm
Y1: 25 MHz; Crystal_SMD_3225-4Pin_3.2x2.5mm

Connections:
+1V2: C80.1, C81.1, C82.1, C83.1, C84.1, C85.1, C86.1, C87.1, C88.1, C89.1, C90.1, U2.10 (VDD12), U2.17 (VDD12), U2.26 (VDD12), U2.32 (VDD12), U2.39 (VDD12), U2.47 (VDD12), U2.59 (VDD12), U2.78 (VDD12), U2.83 (VDD12), U2.90 (VDD12), U2.98 (VDD12); also elsewhere on the board
+3V3: C70.1, C71.1, C72.1, C73.1, C74.1, C75.1, C76.1, C77.1, R21.1, R25.1, R33.1, R34.1, U2.2 (VDD33), U2.5 (VDD33), U2.27 (VDD33), U2.42 (VDD33), U2.54 (VDD33), U2.64 (VDD33), U2.65 (SPI_CLK/C_ATTACH3/GPIO4), U2.66 (SPI_DO/C_ATTACH2/GPIO5), U2.72 (VDD33), U2.73 (C_ATTACH1/GPIO1), U2.76 (C_ATTACH0/GPIO64), U2.93 (VDD33); also elsewhere on the board
/hub/CFG_BC_EN: R23.1, U2.67 (SPI_DI/GPIO9/CFG_BC_EN)
/hub/CFG_NON_REM: R24.1, U2.68 (SPI_CE_N/GPIO7/CFG_NON_REM)
/hub/CFG_STRAP: R21.2, R22.2, U2.20 (GPIO12/CFG_STRAP)
/hub/HUB_RESET_N: C91.1, R25.2, U2.25 (RESET_N)
/hub/RBIAS: R20.1, U2.1 (RBIAS)
/hub/XTAL_IN: C92.1, U2.3 (XTALI/CLKIN), Y1.1
/hub/XTAL_OUT: C93.1, U2.4 (XTALO), Y1.3
GND: C70.2, C71.2, C72.2, C73.2, C74.2, C75.2, C76.2, C77.2, C80.2, C81.2, C82.2, C83.2, C84.2, C85.2, C86.2, C87.2, C88.2, C89.2, C90.2, C91.2, C92.2, C93.2, H1.1 (1_1), H2.1 (1_1), H3.1 (1_1), H4.1 (1_1), R20.2, R22.1, R23.2, R24.2, R28.2, R29.2, R30.2, R31.2, R32.2, U2.21 (FLEX_CMD), U2.23 (TESTEN), U2.101 (VSS), Y1.2 (G), Y1.4 (G); also elsewhere on the board
P1_DN: U2.7 (USB2DN_DM1/PRT_DIS_M1); also elsewhere on the board
P1_DP: U2.6 (USB2DN_DP1/PRT_DIS_P1); also elsewhere on the board
P1_SSRX_N: U2.12 (USB3DN_RXDM1); also elsewhere on the board
P1_SSRX_P: U2.11 (USB3DN_RXDP1); also elsewhere on the board
P1_SSTX_N: U2.9 (USB3DN_TXDM1); also elsewhere on the board
P1_SSTX_P: U2.8 (USB3DN_TXDP1); also elsewhere on the board
P2_DN: U2.14 (USB2DN_DM2/PRT_DIS_M2); also elsewhere on the board
P2_DP: U2.13 (USB2DN_DP2/PRT_DIS_P2); also elsewhere on the board
P2_SSRX_N: U2.19 (USB3DN_RXDM2); also elsewhere on the board
P2_SSRX_P: U2.18 (USB3DN_RXDP2); also elsewhere on the board
P2_SSTX_N: U2.16 (USB3DN_TXDM2); also elsewhere on the board
P2_SSTX_P: U2.15 (USB3DN_TXDP2); also elsewhere on the board
P3_DN: U2.29 (USB2DN_DM3/PRT_DIS_M3); also elsewhere on the board
P3_DP: U2.28 (USB2DN_DP3/PRT_DIS_P3); also elsewhere on the board
P3_SSRX_N: U2.34 (USB3DN_RXDM3); also elsewhere on the board
P3_SSRX_P: U2.33 (USB3DN_RXDP3); also elsewhere on the board
P3_SSTX_N: U2.31 (USB3DN_TXDM3); also elsewhere on the board
P3_SSTX_P: U2.30 (USB3DN_TXDP3); also elsewhere on the board
P4_DN: U2.36 (USB2DN_DM4/PRT_DIS_M4); also elsewhere on the board
P4_DP: U2.35 (USB2DN_DP4/PRT_DIS_P4); also elsewhere on the board
P4_SSRX_N: U2.41 (USB3DN_RXDM4); also elsewhere on the board
P4_SSRX_P: U2.40 (USB3DN_RXDP4); also elsewhere on the board
P4_SSTX_N: U2.38 (USB3DN_TXDM4); also elsewhere on the board
P4_SSTX_P: U2.37 (USB3DN_TXDP4); also elsewhere on the board
P5_DN: U2.44 (USB2DN_DM5/PRT_DIS_M5); also elsewhere on the board
P5_DP: U2.43 (USB2DN_DP5/PRT_DIS_P5); also elsewhere on the board
P5_SSRX_N: U2.49 (USB3DN_RXDM5); also elsewhere on the board
P5_SSRX_P: U2.48 (USB3DN_RXDP5); also elsewhere on the board
P5_SSTX_N: U2.46 (USB3DN_TXDM5); also elsewhere on the board
P5_SSTX_P: U2.45 (USB3DN_TXDP5); also elsewhere on the board
P6_DN: U2.87 (USB2DN_DM6/PRT_DIS_M6); also elsewhere on the board
P6_DP: U2.86 (USB2DN_DP6/PRT_DIS_P6); also elsewhere on the board
P7_DN: U2.80 (USB2DN_DM7/PRT_DIS_M7); also elsewhere on the board
P7_DP: U2.79 (USB2DN_DP7/PRT_DIS_P7); also elsewhere on the board
PRT_CTL1: U2.70 (PRT_CTL1/GPIO17); also elsewhere on the board
PRT_CTL2: U2.62 (PRT_CTL2/GPIO18); also elsewhere on the board
PRT_CTL3: U2.58 (PRT_CTL3/GPIO19); also elsewhere on the board
PRT_CTL4: U2.57 (PRT_CTL4/GANG_PWR/GPIO20); also elsewhere on the board
PRT_CTL5: U2.52 (PRT_CTL5/GPIO21); also elsewhere on the board
PRT_CTL6: U2.51 (PRT_CTL6/GPIO22); also elsewhere on the board
SMB_SCL: R34.2, U2.75 (SMBCLK/GPIO8); also elsewhere on the board
SMB_SDA: R33.2, U2.74 (SMBDATA/GPIO6); also elsewhere on the board
SPEED_IND1: R28.1, U2.63 (SPEED_IND1/BC_IND1/GPIO70); also elsewhere on the board
SPEED_IND2: R29.1, U2.61 (SPEED_IND2/BC_IND2/GPIO71); also elsewhere on the board
SPEED_IND3: R30.1, U2.56 (SPEED_IND3/BC_IND3/GPIO2); also elsewhere on the board
SPEED_IND5: R31.1, U2.50 (SPEED_IND5/BC_IND5/GPIO65); also elsewhere on the board
SPEED_IND6: R32.1, U2.71 (SPEED_IND6/BC_IND6/GPIO66); also elsewhere on the board
UP_DN: U2.95 (USB2UP_DM); also elsewhere on the board
UP_DP: U2.94 (USB2UP_DP); also elsewhere on the board
UP_SSRX_N: U2.100 (USB3UP_RXDM); also elsewhere on the board
UP_SSRX_P: U2.99 (USB3UP_RXDP); also elsewhere on the board
UP_SSTX_N: U2.97 (USB3UP_TXDM); also elsewhere on the board
UP_SSTX_P: U2.96 (USB3UP_TXDP); also elsewhere on the board
VBUS_DET: U2.24 (VBUS_DET); also elsewhere on the board

Notes on the sheet:
tight: C80 → U2.10, C81 → U2.17, C82 → U2.26, C83 → U2.32
Straps, SMBus and link speed
USB-C Dock with Gigabit Ethernet — Rev A
Bias, clock and reset
tight: C70 → U2.2, C71 → U2.5, C72 → U2.27, C73 → U2.42
tight: C84 → U2.39, C85 → U2.47
tight: C86 → U2.59, C87 → U2.78, C88 → U2.83, C89 → U2.90, C90 → U2.98
USB5807C — 7-port hub
3.3 V and 1.2 V decoupling
tight: C74 → U2.54, C75 → U2.64, C76 → U2.72, C77 → U2.93

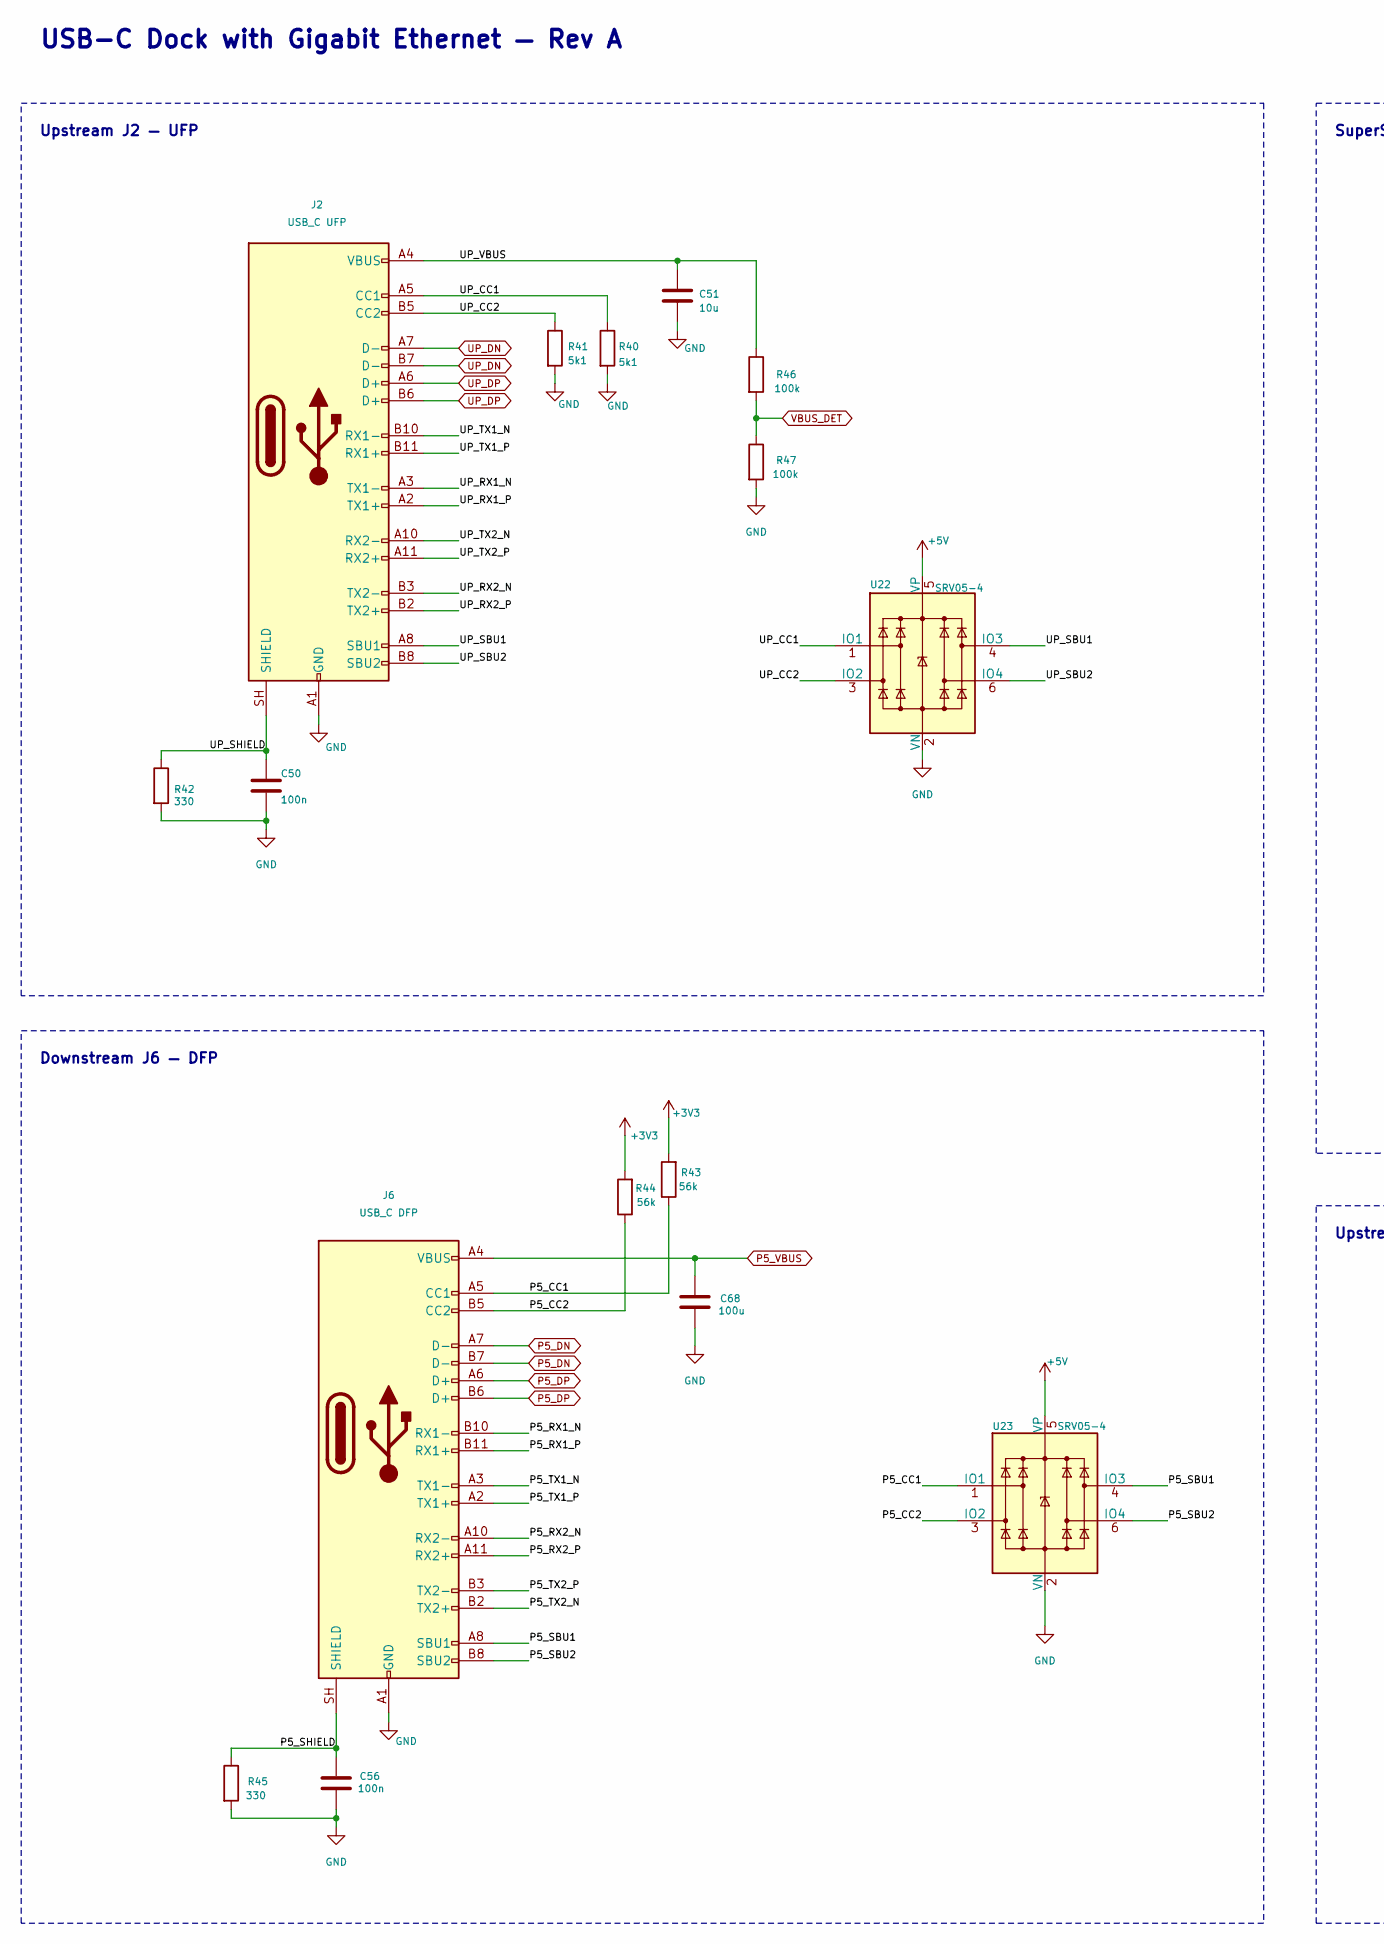
[picture p26: schematic usb-c.kicad_sch, USB-C Dock with Gigabit Ethernet, part in row 1, column 1]

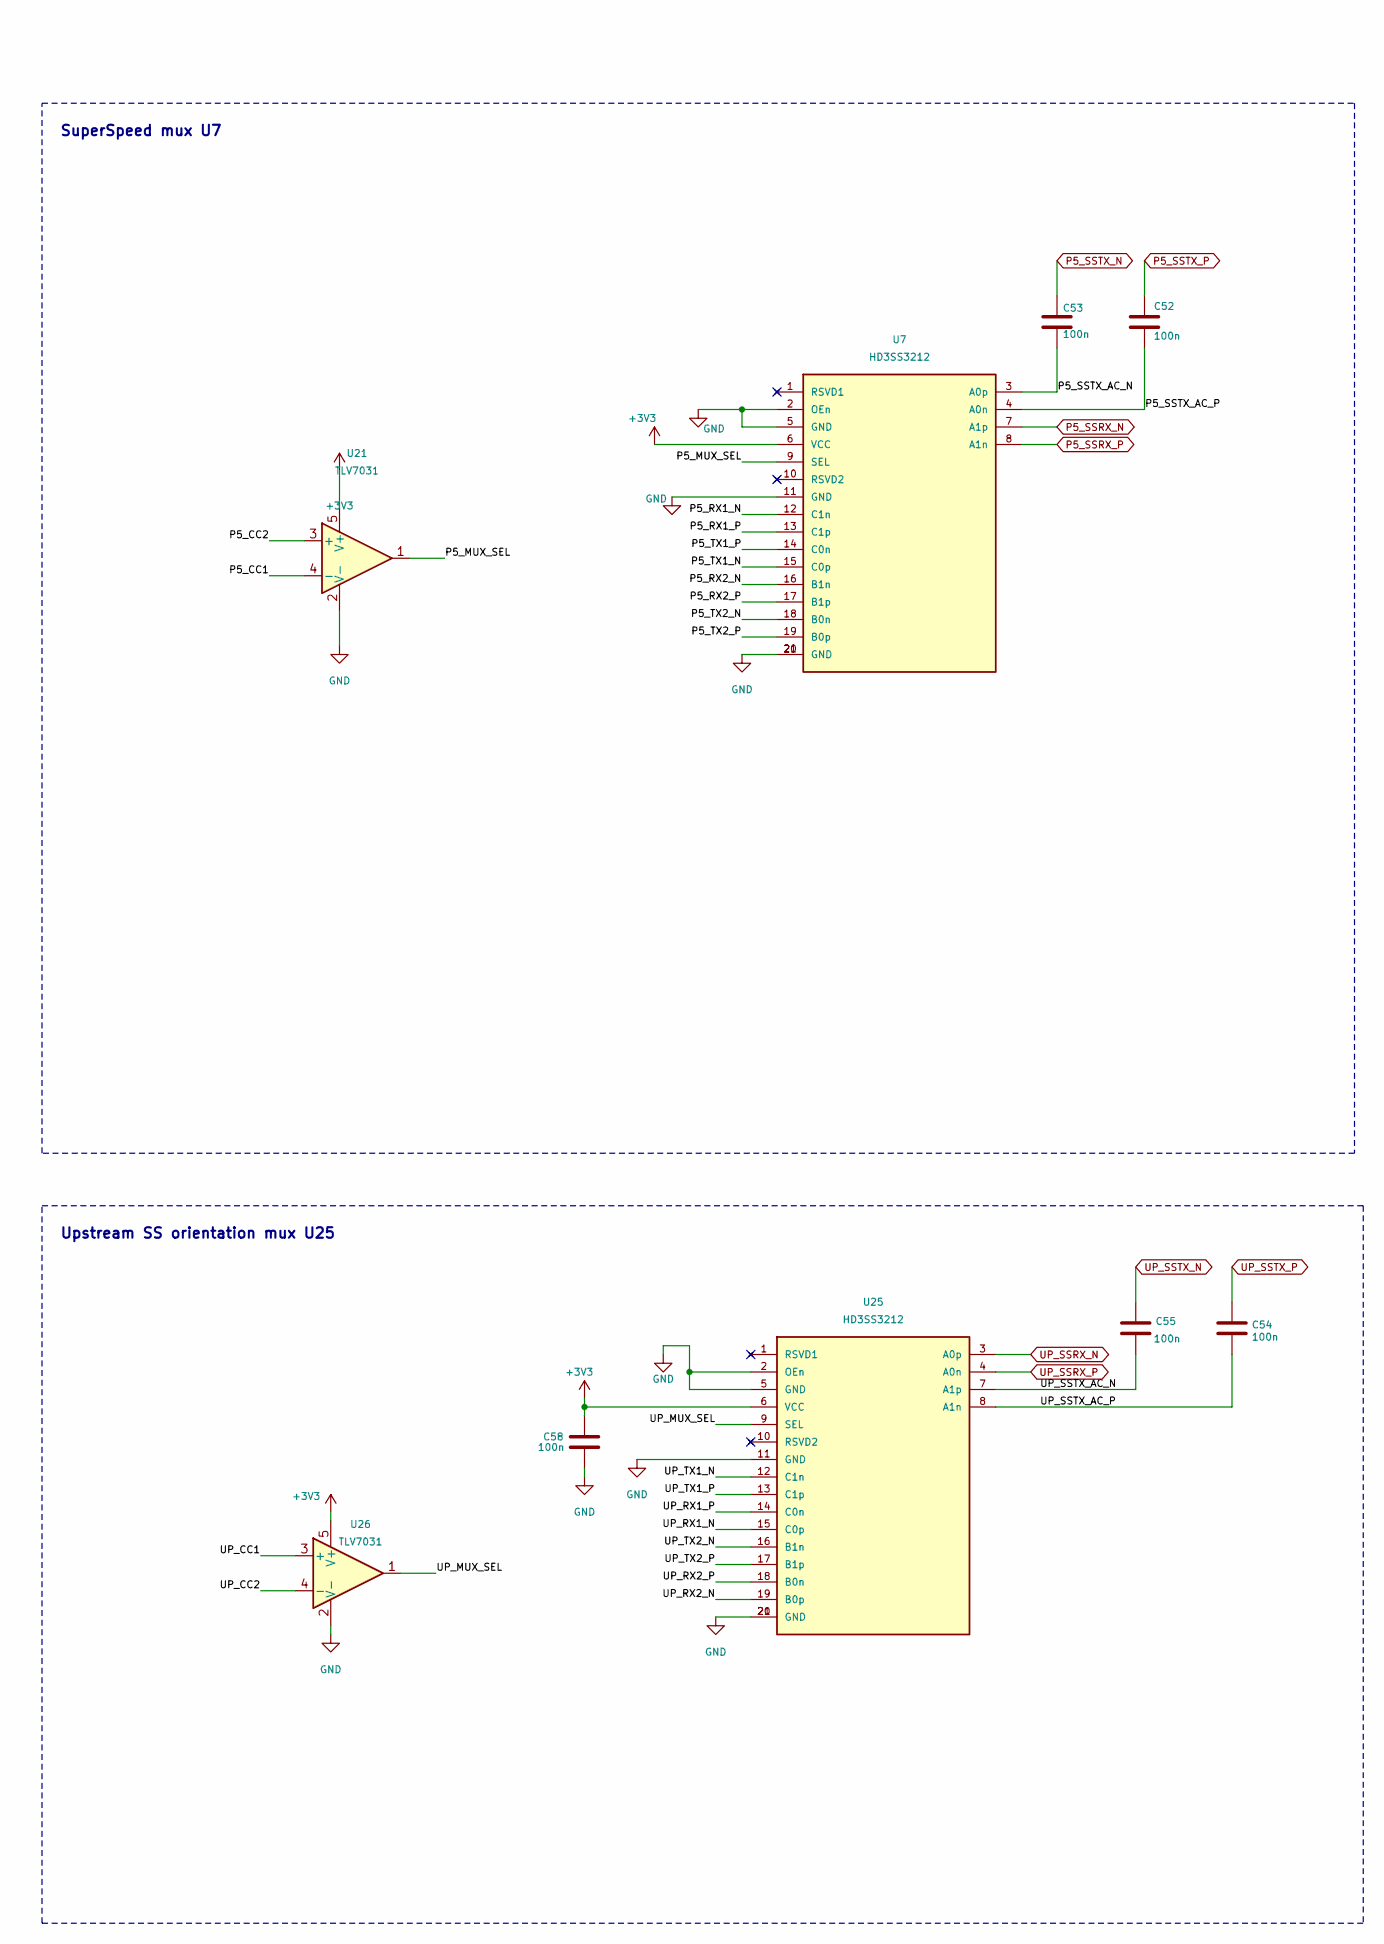
[picture p27: schematic usb-c.kicad_sch, USB-C Dock with Gigabit Ethernet, part in row 1, column 2]

Parts:
C50, C52, C53, C54, C55, C56, C58: 100n; C_0402_1005Metric
C51: 10u; C_0805_2012Metric
C68: 100u; C_1210_3225Metric
J2: USB_C UFP; USB_C_Receptacle_Amphenol_12401610E4-2A
J6: USB_C DFP; USB_C_Receptacle_Amphenol_12401610E4-2A
R40, R41: 5k1; R_0603_1608Metric
R42, R45: 330; R_0603_1608Metric
R43, R44: 56k; R_0603_1608Metric
R46, R47: 100k; R_0603_1608Metric
U7, U25: HD3SS3212; DHVQFN-20-1EP_2.5x4.5mm_P0.5mm_EP1x3mm_TI
U21, U26: TLV7031; SOT-23-5
U22, U23: SRV05-4; SOT-23-6

Connections:
+3V3: C58.1, R43.2, R44.2, U7.6 (VCC), U21.5 (V+), U25.6 (VCC), U26.5 (V+); also elsewhere on the board
+5V: U22.5 (VP), U23.5 (VP); also elsewhere on the board
/usb-c/P5_CC1: J6.A5 (CC1), R43.1, U21.4 (-), U23.1 (IO1)
/usb-c/P5_CC2: J6.B5 (CC2), R44.1, U21.3 (+), U23.3 (IO2)
/usb-c/P5_MUX_SEL: U7.9 (SEL), U21.1
/usb-c/P5_RX1_N: J6.B10 (RX1-), U7.12 (C1n)
/usb-c/P5_RX1_P: J6.B11 (RX1+), U7.13 (C1p)
/usb-c/P5_RX2_N: J6.A10 (RX2-), U7.16 (B1n)
/usb-c/P5_RX2_P: J6.A11 (RX2+), U7.17 (B1p)
/usb-c/P5_SBU1: J6.A8 (SBU1), U23.4 (IO3)
/usb-c/P5_SBU2: J6.B8 (SBU2), U23.6 (IO4)
/usb-c/P5_SHIELD: C56.1, J6.SH (SHIELD), R45.1
/usb-c/P5_SSTX_AC_N: C53.2, U7.3 (A0p)
/usb-c/P5_SSTX_AC_P: C52.2, U7.4 (A0n)
/usb-c/P5_TX1_N: J6.A3 (TX1-), U7.15 (C0p)
/usb-c/P5_TX1_P: J6.A2 (TX1+), U7.14 (C0n)
/usb-c/P5_TX2_N: J6.B2 (TX2+), U7.18 (B0n)
/usb-c/P5_TX2_P: J6.B3 (TX2-), U7.19 (B0p)
/usb-c/UP_CC1: J2.A5 (CC1), R40.1, U22.1 (IO1), U26.3 (+)
/usb-c/UP_CC2: J2.B5 (CC2), R41.1, U22.3 (IO2), U26.4 (-)
/usb-c/UP_MUX_SEL: U25.9 (SEL), U26.1
/usb-c/UP_RX1_N: J2.A3 (TX1-), U25.15 (C0p)
/usb-c/UP_RX1_P: J2.A2 (TX1+), U25.14 (C0n)
/usb-c/UP_RX2_N: J2.B3 (TX2-), U25.19 (B0p)
/usb-c/UP_RX2_P: J2.B2 (TX2+), U25.18 (B0n)
/usb-c/UP_SBU1: J2.A8 (SBU1), U22.4 (IO3)
/usb-c/UP_SBU2: J2.B8 (SBU2), U22.6 (IO4)
/usb-c/UP_SHIELD: C50.1, J2.SH (SHIELD), R42.1
/usb-c/UP_SSTX_AC_N: C55.2, U25.7 (A1p)
/usb-c/UP_SSTX_AC_P: C54.2, U25.8 (A1n)
/usb-c/UP_TX1_N: J2.B10 (RX1-), U25.12 (C1n)
/usb-c/UP_TX1_P: J2.B11 (RX1+), U25.13 (C1p)
/usb-c/UP_TX2_N: J2.A10 (RX2-), U25.16 (B1n)
/usb-c/UP_TX2_P: J2.A11 (RX2+), U25.17 (B1p)
/usb-c/UP_VBUS: C51.1, J2.A4 (VBUS), J2.A9 (VBUS), J2.B4 (VBUS), J2.B9 (VBUS), R46.1
GND: C50.2, C51.2, C56.2, C58.2, C68.2, J2.A1 (GND), J2.A12 (GND), J2.B1 (GND), J2.B12 (GND), J6.A1 (GND), J6.A12 (GND), J6.B1 (GND), J6.B12 (GND), R40.2, R41.2, R42.2, R45.2, R47.2, U7.2 (OEn), U7.5 (GND), U7.11 (GND), U7.20 (GND), U7.21 (GND), U21.2 (V-), U22.2 (VN), U23.2 (VN), U25.2 (OEn), U25.5 (GND), U25.11 (GND), U25.20 (GND), U25.21 (GND), U26.2 (V-); also elsewhere on the board
P5_DN: J6.A7 (D-), J6.B7 (D-); also elsewhere on the board
P5_DP: J6.A6 (D+), J6.B6 (D+); also elsewhere on the board
P5_SSRX_N: U7.7 (A1p); also elsewhere on the board
P5_SSRX_P: U7.8 (A1n); also elsewhere on the board
P5_SSTX_N: C53.1; also elsewhere on the board
P5_SSTX_P: C52.1; also elsewhere on the board
P5_VBUS: C68.1, J6.A4 (VBUS), J6.A9 (VBUS), J6.B4 (VBUS), J6.B9 (VBUS); also elsewhere on the board
UP_DN: J2.A7 (D-), J2.B7 (D-); also elsewhere on the board
UP_DP: J2.A6 (D+), J2.B6 (D+); also elsewhere on the board
UP_SSRX_N: U25.3 (A0p); also elsewhere on the board
UP_SSRX_P: U25.4 (A0n); also elsewhere on the board
UP_SSTX_N: C55.1; also elsewhere on the board
UP_SSTX_P: C54.1; also elsewhere on the board
VBUS_DET: R46.2, R47.1; also elsewhere on the board

Notes on the sheet:
Downstream J6 — DFP
Upstream J2 — UFP
USB-C Dock with Gigabit Ethernet — Rev A
SuperSpeed mux U7
Upstream SS orientation mux U25
