Mehdi-Ldj/usb3-dock/hardware/rev-a/usb3-dock.kicad_pcb

## KiCad design hardware/rev-a/usb3-dock.kicad_pcb (continued)

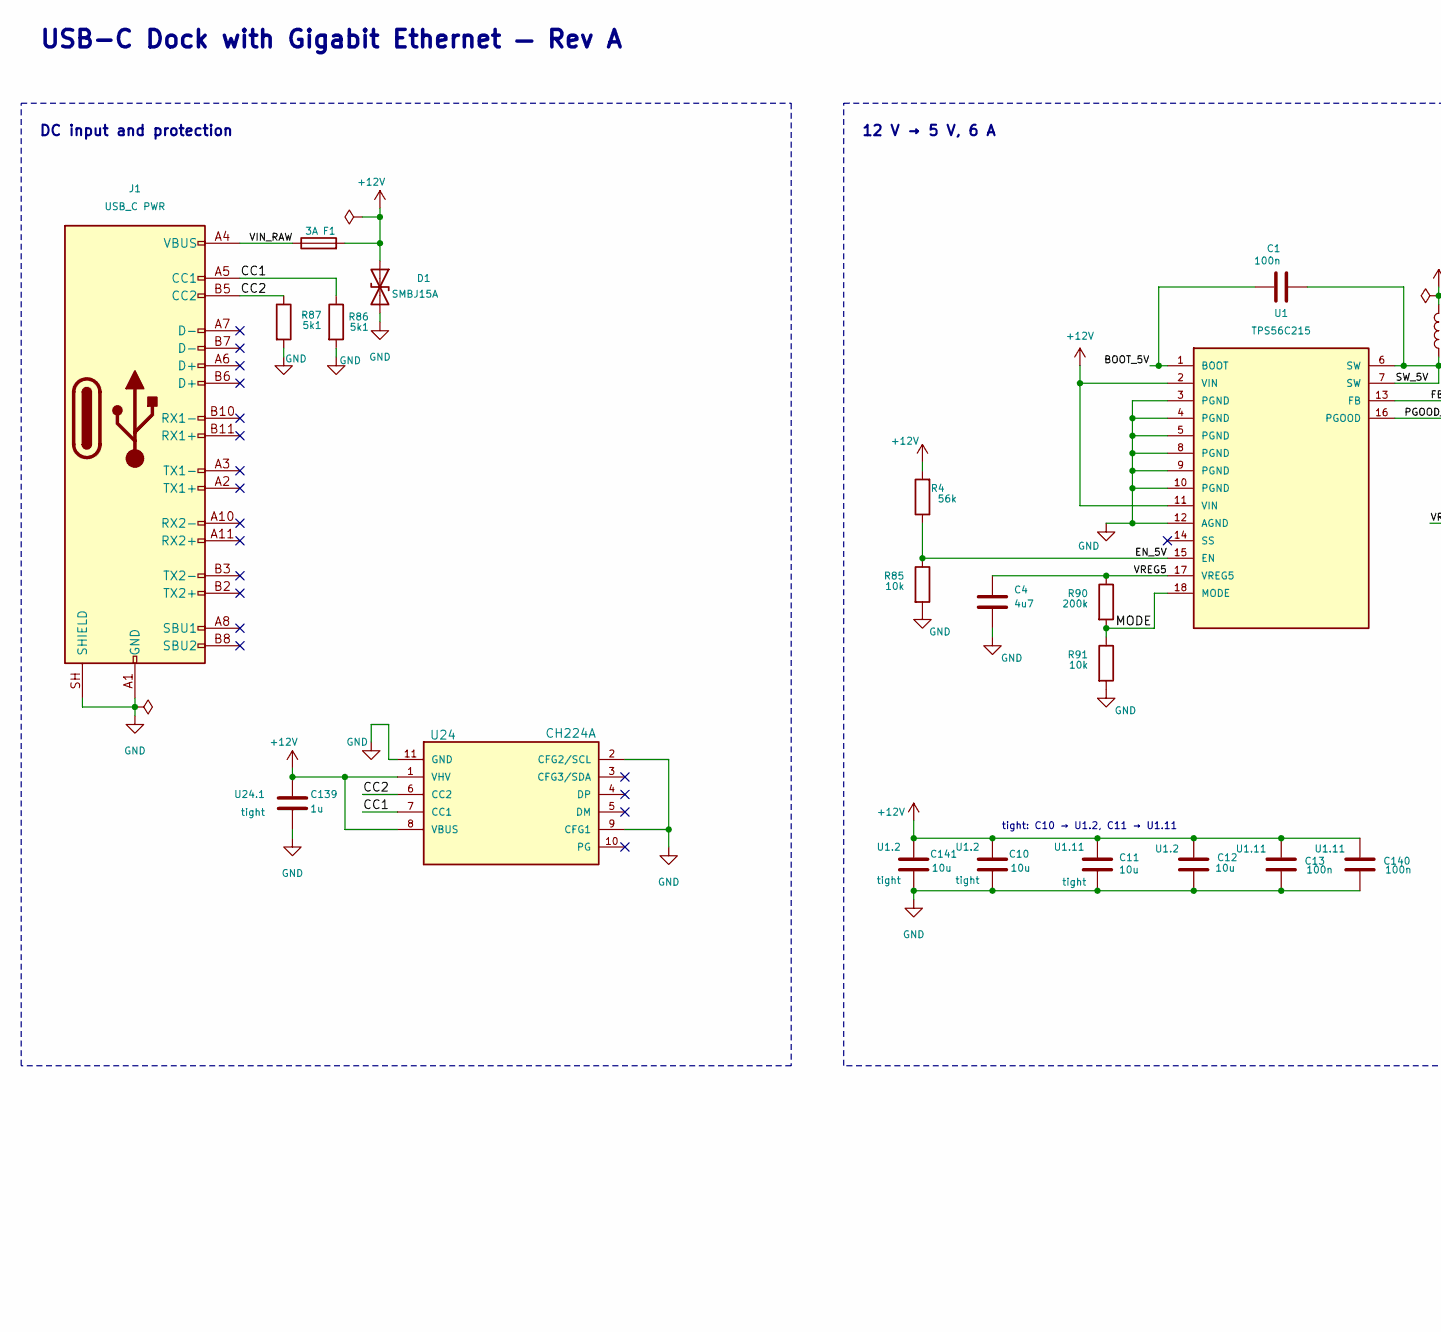
[picture p28: schematic power.kicad_sch, USB-C Dock with Gigabit Ethernet, part in row 1, column 1]

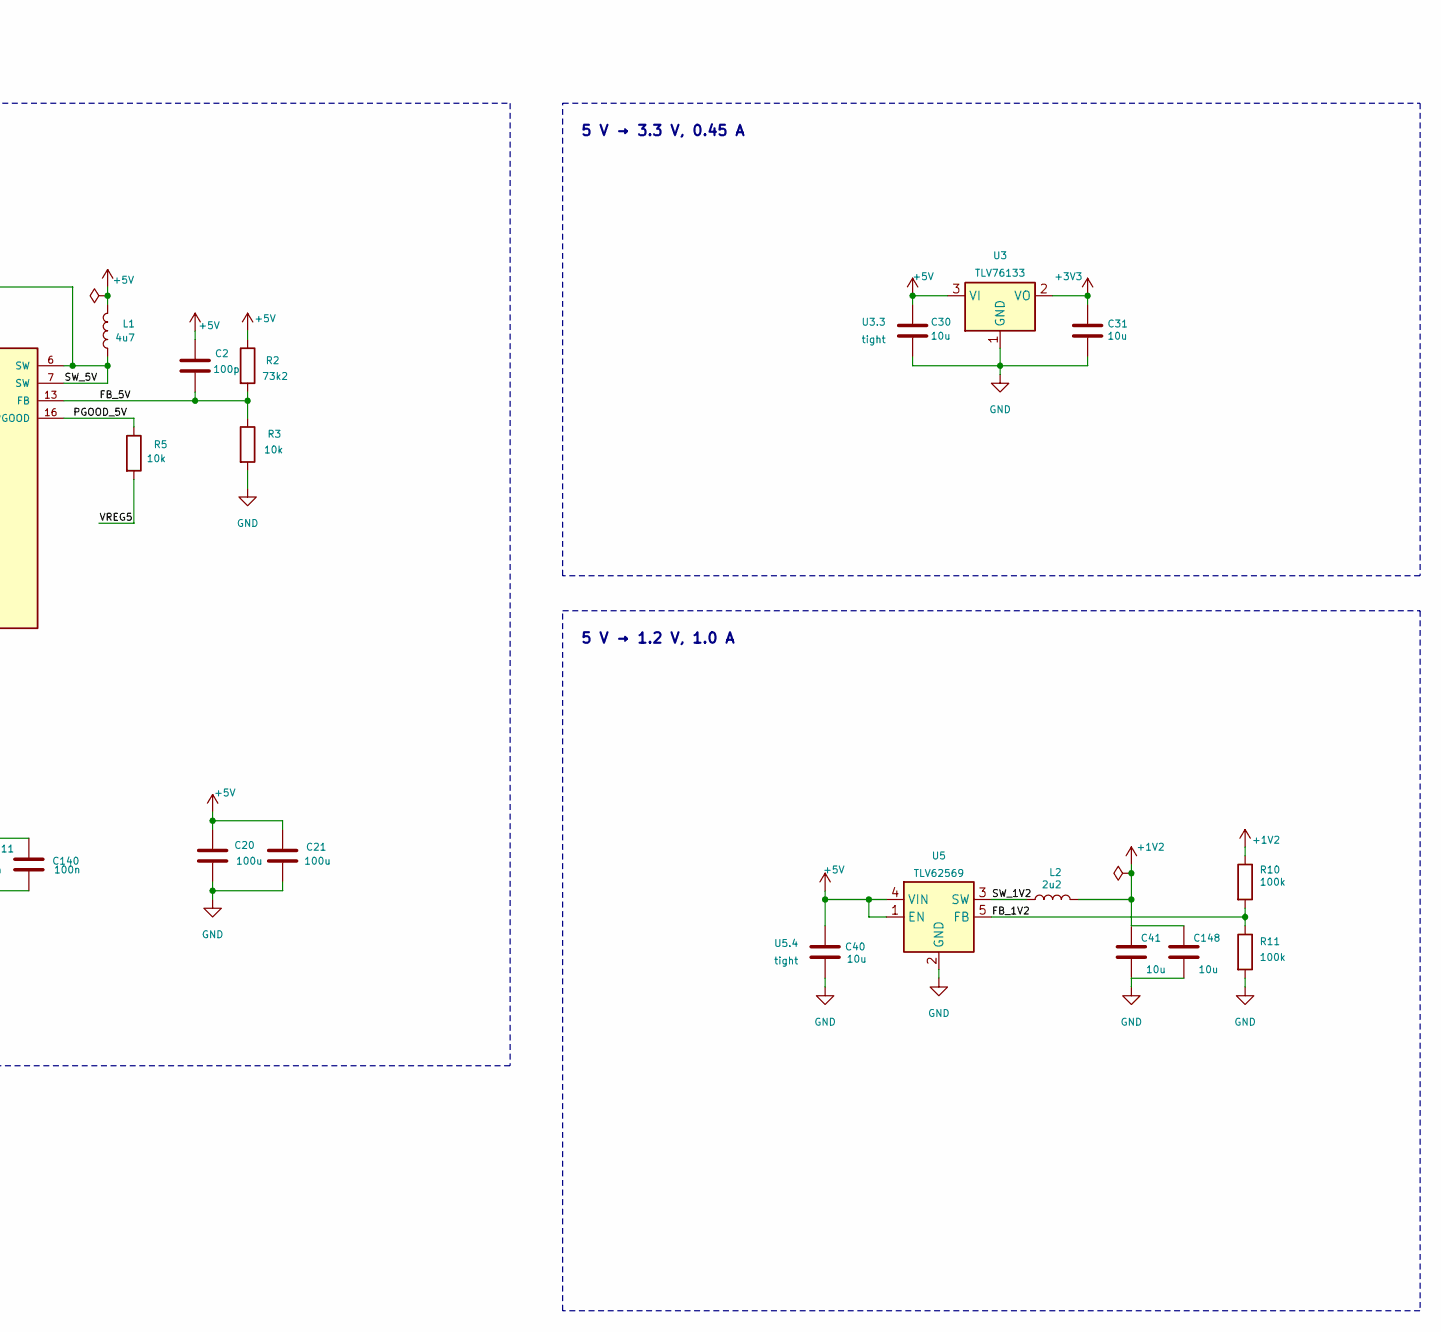
[picture p29: schematic power.kicad_sch, USB-C Dock with Gigabit Ethernet, part in row 1, column 2]

Parts:
C1, C13, C140: 100n; C_0402_1005Metric
C2: 100p; C_0402_1005Metric
C4: 4u7; C_0603_1608Metric
C10, C11, C12, C30, C31, C40, C41, C141, C148: 10u; C_0805_2012Metric
C20, C21: 100u; C_1210_3225Metric
C139: 1u; C_0805_2012Metric
D1: SMBJ15A; D_SMB
F1: 3A; Fuse_1206_3216Metric
J1: USB_C PWR; USB_C_Receptacle_Amphenol_12401610E4-2A
L1: 4u7; L_7.1x6.6mm_CMLO0650H
L2: 2u2; L_4x4mm_PNR4020
R2: 73k2; R_0603_1608Metric
R3, R5, R85, R91: 10k; R_0603_1608Metric
R4: 56k; R_0603_1608Metric
R10, R11: 100k; R_0603_1608Metric
R86, R87: 5k1; R_0603_1608Metric
R90: 200k; R_0603_1608Metric
U1: TPS56C215; Texas_RNN0018A_TPS56C215
U3: TLV76133; SOT-223-3_TabPin2
U5: TLV62569; SOT-23-5
U24: CH224A; SSOP-10-1EP_3.9x4.9mm_P1mm_EP2.1x3.3mm

Connections:
+1V2: C41.1, C148.1, L2.2, R10.1; also elsewhere on the board
+3V3: C31.1, U3.2 (VO); also elsewhere on the board
+5V: C2.1, C20.1, C21.1, C30.1, C40.1, L1.2, R2.1, U3.3 (VI), U5.1 (EN), U5.4 (VIN); also elsewhere on the board
+12V: C10.1, C11.1, C12.1, C13.1, C139.1, C140.1, C141.1, D1.1 (A1), F1.2, R4.2, U1.2 (VIN), U1.11 (VIN), U24.1 (VHV), U24.8 (VBUS)
/power/BOOT_5V: C1.1, U1.1 (BOOT)
/power/CC1: J1.A5 (CC1), R86.1, U24.7 (CC1)
/power/CC2: J1.B5 (CC2), R87.1, U24.6 (CC2)
/power/EN_5V: R4.1, R85.1, U1.15 (EN)
/power/FB_1V2: R10.2, R11.1, U5.5 (FB)
/power/FB_5V: C2.2, R2.2, R3.1, U1.13 (FB)
/power/MODE: R90.2, R91.1, U1.18 (MODE)
/power/PGOOD_5V: R5.1, U1.16 (PGOOD)
/power/SW_1V2: L2.1, U5.3 (SW)
/power/SW_5V: C1.2, L1.1, U1.6 (SW), U1.7 (SW)
/power/VIN_RAW: F1.1, J1.A4 (VBUS), J1.A9 (VBUS), J1.B4 (VBUS), J1.B9 (VBUS)
/power/VREG5: C4.1, R5.2, R90.1, U1.17 (VREG5)
GND: C4.2, C10.2, C11.2, C12.2, C13.2, C20.2, C21.2, C30.2, C31.2, C40.2, C41.2, C139.2, C140.2, C141.2, C148.2, D1.2 (A2), J1.A1 (GND), J1.A12 (GND), J1.B1 (GND), J1.B12 (GND), J1.SH (SHIELD), R3.2, R11.2, R85.2, R86.2, R87.2, R91.2, U1.3 (PGND), U1.4 (PGND), U1.5 (PGND), U1.8 (PGND), U1.9 (PGND), U1.10 (PGND), U1.12 (AGND), U3.1 (GND), U5.2 (GND), U24.2 (CFG2/SCL), U24.9 (CFG1), U24.11 (GND); also elsewhere on the board

Notes on the sheet:
USB-C Dock with Gigabit Ethernet — Rev A
12 V → 5 V, 6 A
tight: C10 → U1.2, C11 → U1.11
5 V → 3.3 V, 0.45 A
5 V → 1.2 V, 1.0 A
DC input and protection

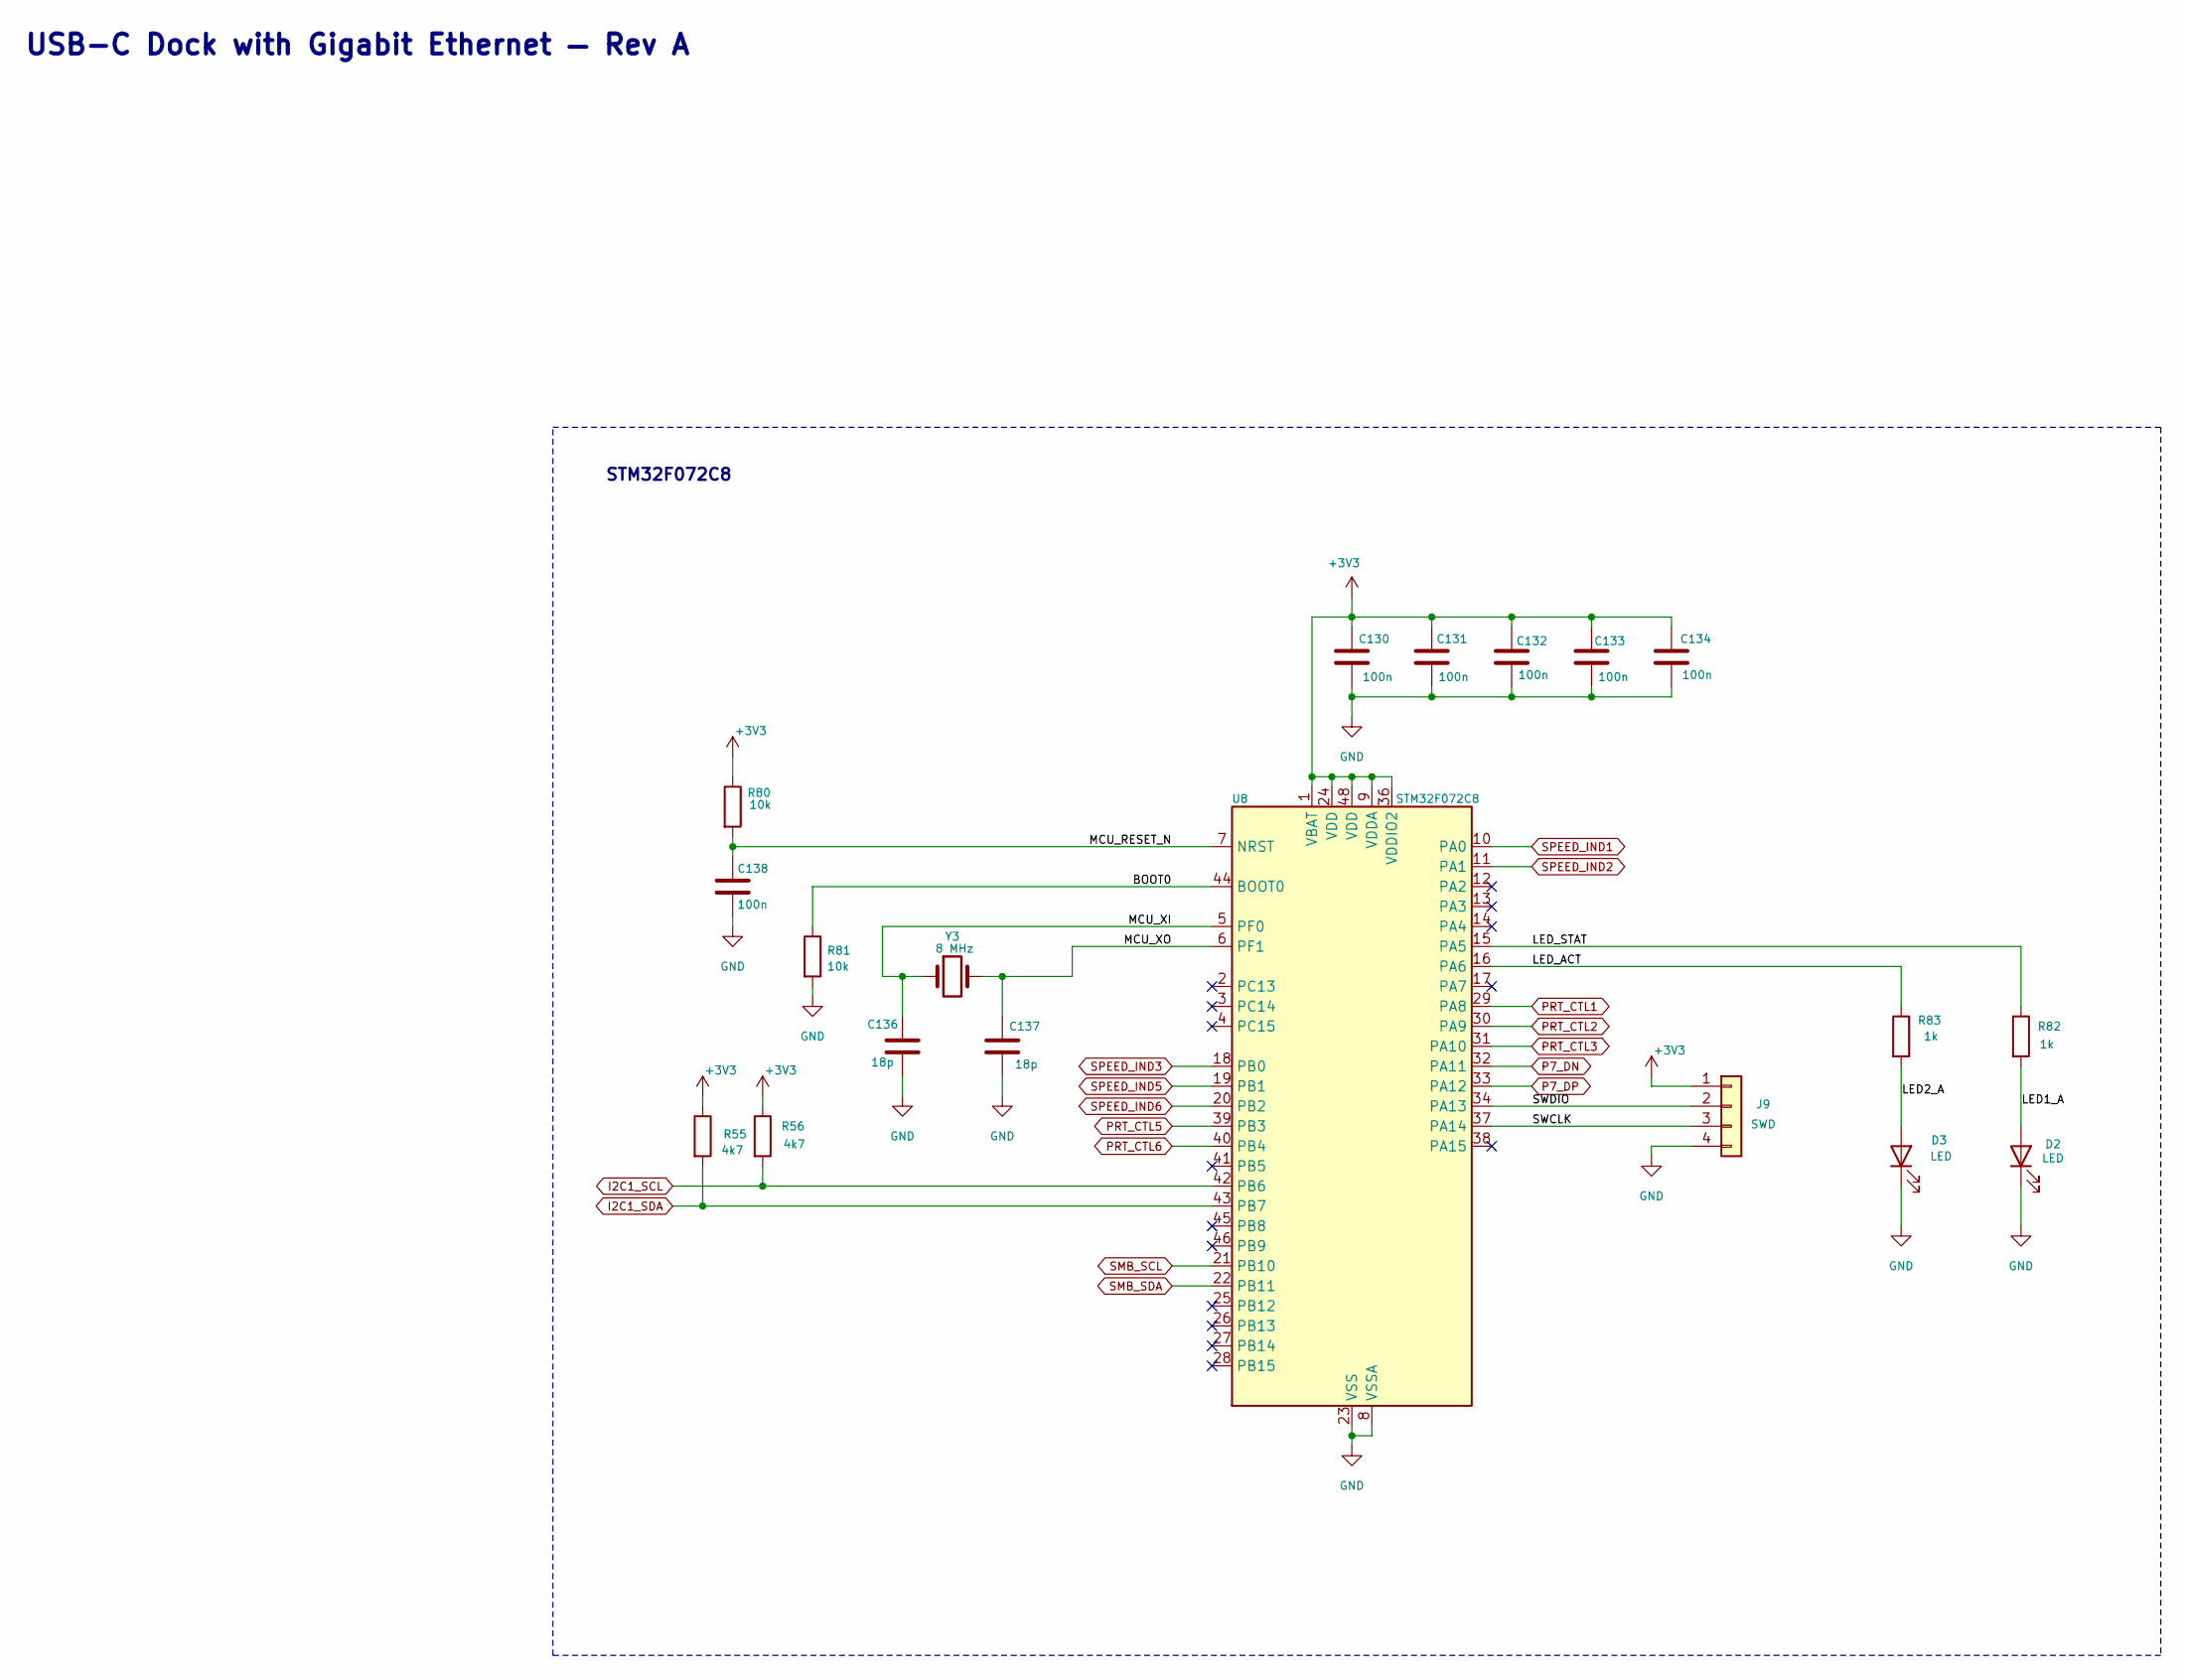
[picture p30: schematic mcu.kicad_sch, USB-C Dock with Gigabit Ethernet]

Parts:
C130, C131, C132, C133, C134, C138: 100n; C_0402_1005Metric
C136, C137: 18p; C_0402_1005Metric
D2, D3: LED; LED_0603_1608Metric
J9: SWD; PinHeader_1x04_P2.54mm_Vertical
R55, R56: 4k7; R_0603_1608Metric
R80, R81: 10k; R_0603_1608Metric
R82, R83: 1k; R_0603_1608Metric
U8: STM32F072C8; LQFP-48_7x7mm_P0.5mm
Y3: 8 MHz; Crystal_SMD_5032-2Pin_5.0x3.2mm

Connections:
+3V3: C130.1, C131.1, C132.1, C133.1, C134.1, J9.1, R55.1, R56.1, R80.1, U8.1 (VBAT), U8.9 (VDDA), U8.24 (VDD), U8.36 (VDDIO2), U8.48 (VDD); also elsewhere on the board
/mcu/BOOT0: R81.1, U8.44 (BOOT0)
/mcu/LED1_A: D2.2 (A), R82.2
/mcu/LED2_A: D3.2 (A), R83.2
/mcu/LED_ACT: R83.1, U8.16 (PA6)
/mcu/LED_STAT: R82.1, U8.15 (PA5)
/mcu/MCU_RESET_N: C138.1, R80.2, U8.7 (NRST)
/mcu/MCU_XI: C136.1, U8.5 (PF0), Y3.1
/mcu/MCU_XO: C137.1, U8.6 (PF1), Y3.2
/mcu/SWCLK: J9.3, U8.37 (PA14)
/mcu/SWDIO: J9.2, U8.34 (PA13)
GND: C130.2, C131.2, C132.2, C133.2, C134.2, C136.2, C137.2, C138.2, D2.1 (K), D3.1 (K), J9.4, R81.2, U8.8 (VSSA), U8.23 (VSS), U8.35 (VSS), U8.47 (VSS); also elsewhere on the board
I2C1_SCL: R56.2, U8.42 (PB6); also elsewhere on the board
I2C1_SDA: R55.2, U8.43 (PB7); also elsewhere on the board
P7_DN: U8.32 (PA11); also elsewhere on the board
P7_DP: U8.33 (PA12); also elsewhere on the board
PRT_CTL1: U8.29 (PA8); also elsewhere on the board
PRT_CTL2: U8.30 (PA9); also elsewhere on the board
PRT_CTL3: U8.31 (PA10); also elsewhere on the board
PRT_CTL5: U8.39 (PB3); also elsewhere on the board
PRT_CTL6: U8.40 (PB4); also elsewhere on the board
SMB_SCL: U8.21 (PB10); also elsewhere on the board
SMB_SDA: U8.22 (PB11); also elsewhere on the board
SPEED_IND1: U8.10 (PA0); also elsewhere on the board
SPEED_IND2: U8.11 (PA1); also elsewhere on the board
SPEED_IND3: U8.18 (PB0); also elsewhere on the board
SPEED_IND5: U8.19 (PB1); also elsewhere on the board
SPEED_IND6: U8.20 (PB2); also elsewhere on the board

Notes on the sheet:
USB-C Dock with Gigabit Ethernet — Rev A
STM32F072C8

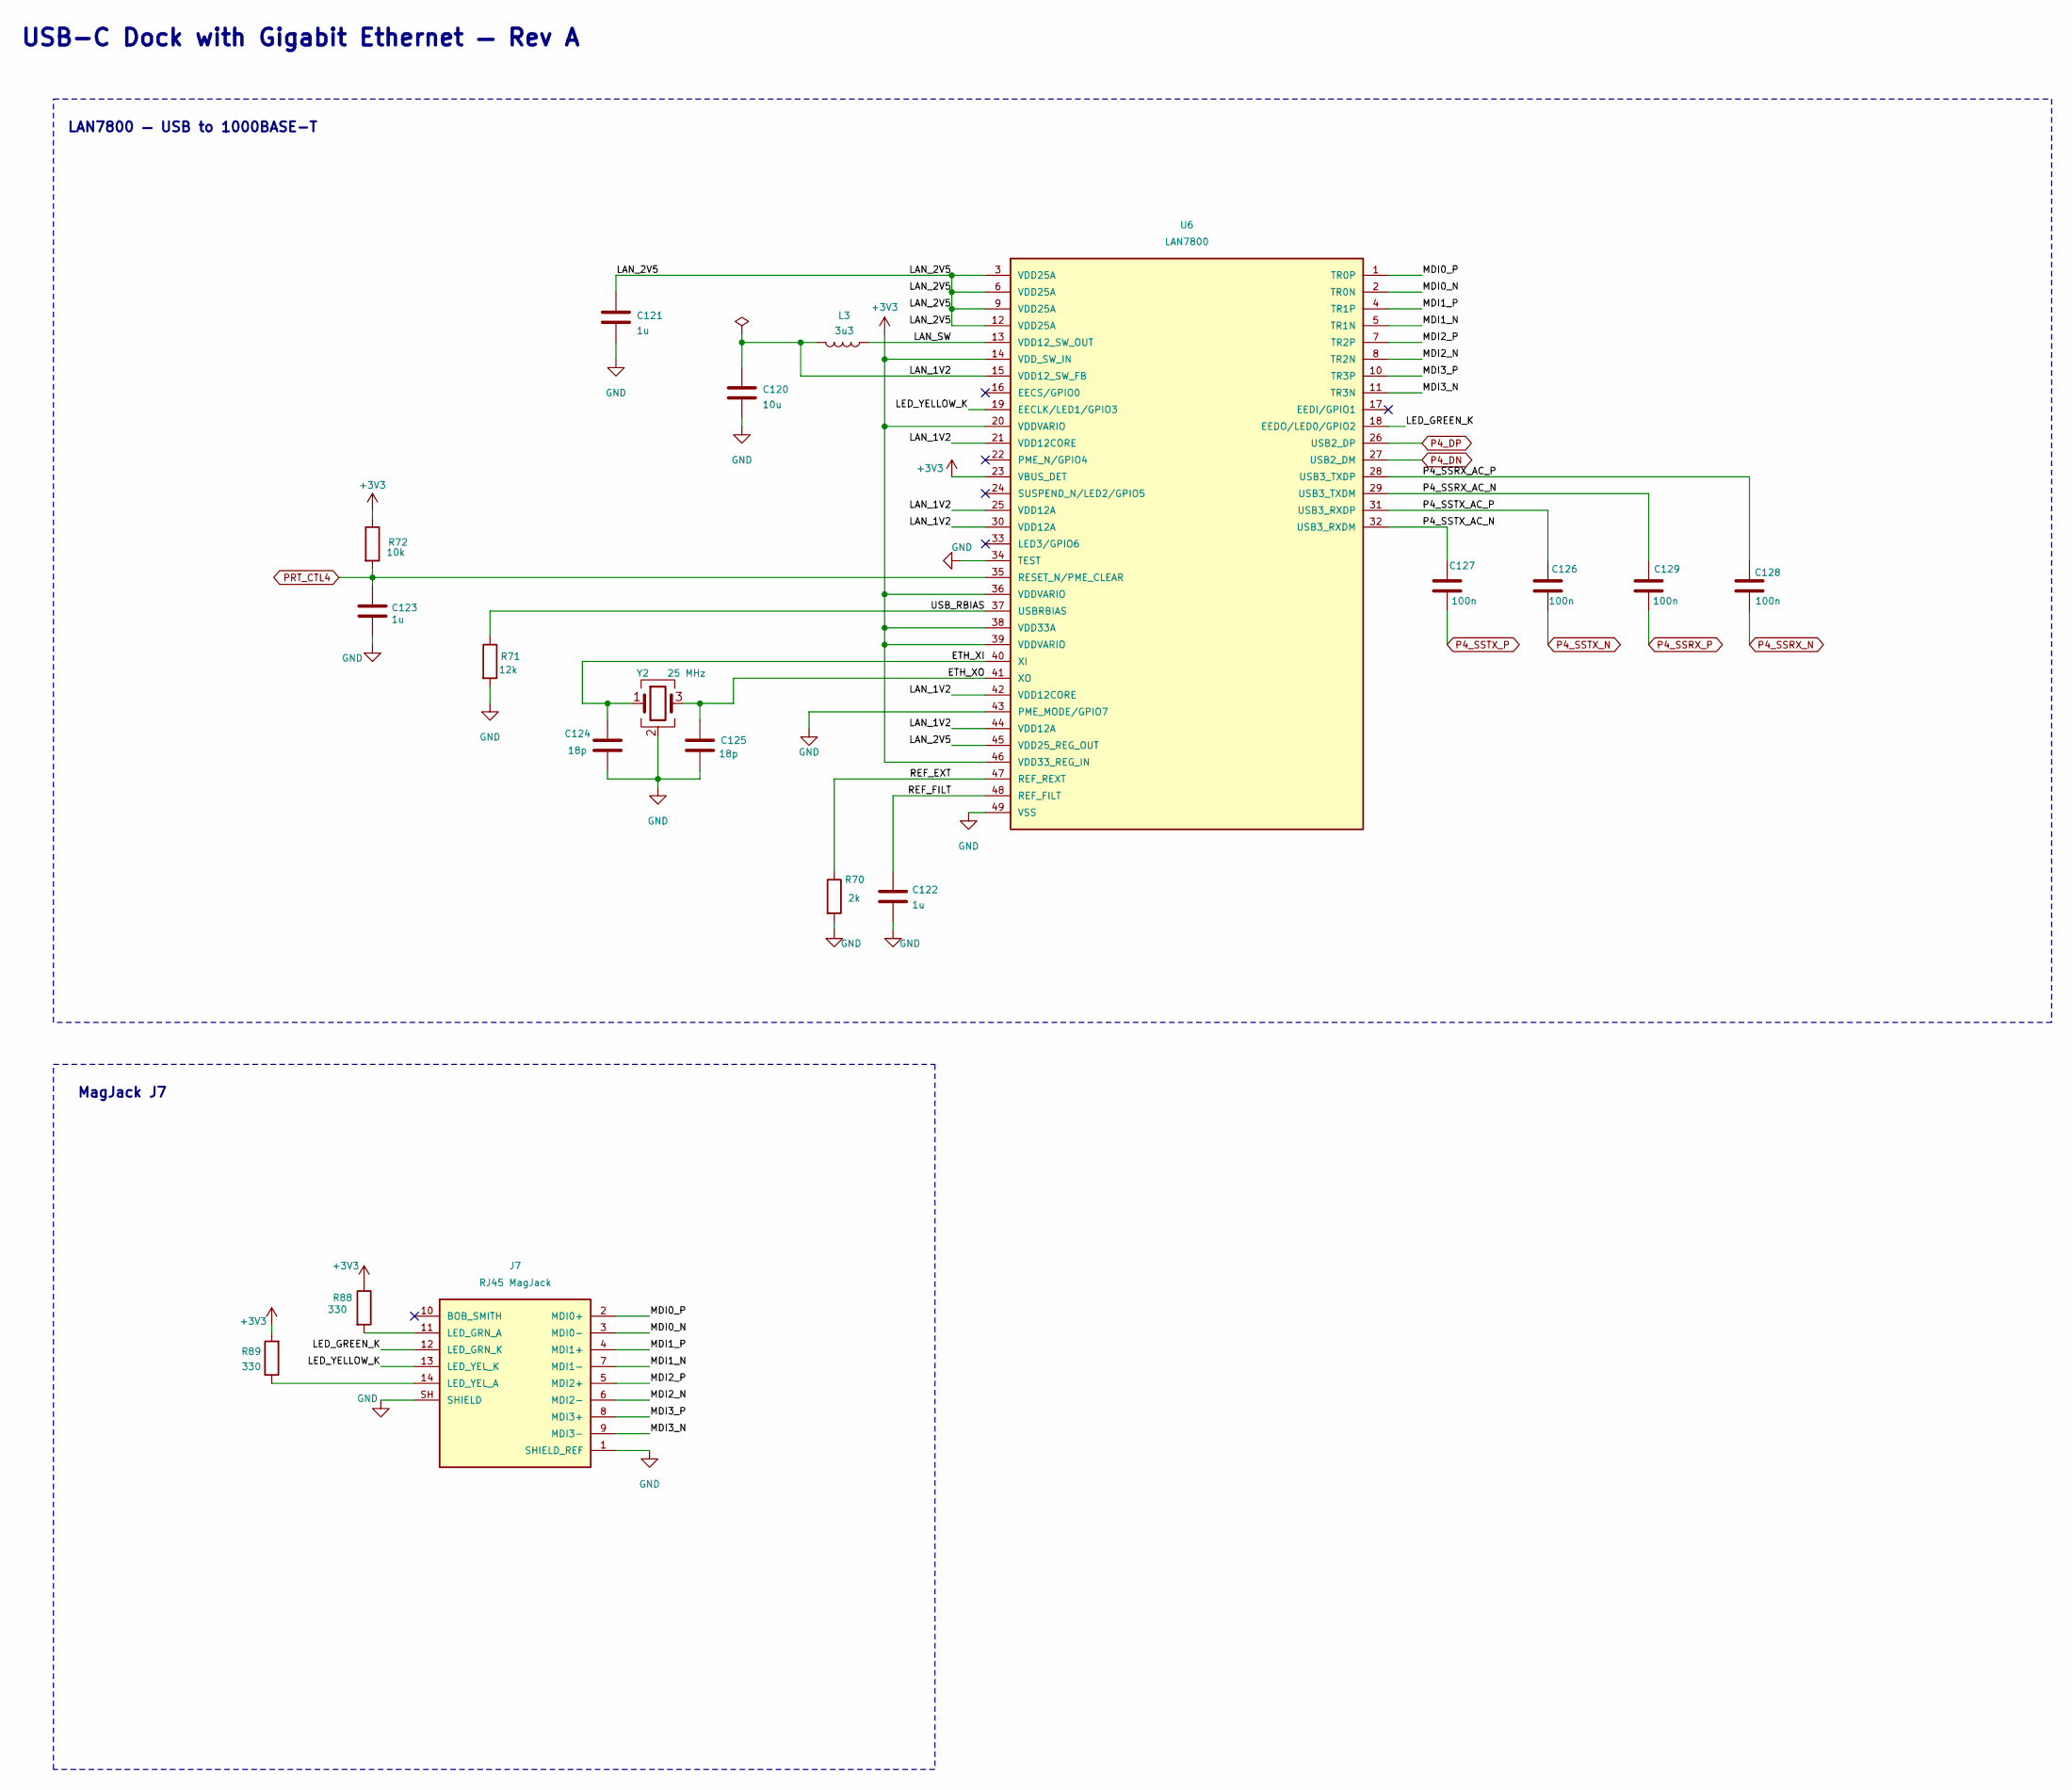
[picture p31: schematic ethernet.kicad_sch, USB-C Dock with Gigabit Ethernet]

Parts:
C120: 10u; C_0805_2012Metric
C121, C122, C123: 1u; C_0603_1608Metric
C124, C125: 18p; C_0402_1005Metric
C126, C127, C128, C129: 100n; C_0402_1005Metric
J7: RJ45 MagJack; RJ45_Hanrun_HR911130A
L3: 3u3; L_4x4mm_FNR4030
R70: 2k; R_0603_1608Metric
R71: 12k; R_0603_1608Metric
R72: 10k; R_0603_1608Metric
R88, R89: 330; R_0603_1608Metric
U6: LAN7800; QFN-48-1EP_6x6mm_P0.4mm_EP4.3x4.3mm
Y2: 25 MHz; Crystal_SMD_3225-4Pin_3.2x2.5mm

Connections:
+3V3: R72.1, R88.1, R89.2, U6.14 (VDD_SW_IN), U6.20 (VDDVARIO), U6.23 (VBUS_DET), U6.36 (VDDVARIO), U6.38 (VDD33A), U6.39 (VDDVARIO), U6.46 (VDD33_REG_IN); also elsewhere on the board
/ethernet/ETH_XI: C124.1, U6.40 (XI), Y2.1
/ethernet/ETH_XO: C125.1, U6.41 (XO), Y2.3
/ethernet/LAN_1V2: C120.1, L3.2, U6.15 (VDD12_SW_FB), U6.21 (VDD12CORE), U6.25 (VDD12A), U6.30 (VDD12A), U6.42 (VDD12CORE), U6.44 (VDD12A)
/ethernet/LAN_2V5: C121.1, U6.3 (VDD25A), U6.6 (VDD25A), U6.9 (VDD25A), U6.12 (VDD25A), U6.45 (VDD25_REG_OUT)
/ethernet/LAN_SW: L3.1, U6.13 (VDD12_SW_OUT)
/ethernet/LED_GREEN_K: J7.12 (LED_GRN_K), U6.18 (EEDO/LED0/GPIO2)
/ethernet/LED_YELLOW_K: J7.13 (LED_YEL_K), U6.19 (EECLK/LED1/GPIO3)
/ethernet/MDI0_N: J7.3 (MDI0-), U6.2 (TR0N)
/ethernet/MDI0_P: J7.2 (MDI0+), U6.1 (TR0P)
/ethernet/MDI1_N: J7.7 (MDI1-), U6.5 (TR1N)
/ethernet/MDI1_P: J7.4 (MDI1+), U6.4 (TR1P)
/ethernet/MDI2_N: J7.6 (MDI2-), U6.8 (TR2N)
/ethernet/MDI2_P: J7.5 (MDI2+), U6.7 (TR2P)
/ethernet/MDI3_N: J7.9 (MDI3-), U6.11 (TR3N)
/ethernet/MDI3_P: J7.8 (MDI3+), U6.10 (TR3P)
/ethernet/P4_SSRX_AC_N: C129.2, U6.29 (USB3_TXDM)
/ethernet/P4_SSRX_AC_P: C128.2, U6.28 (USB3_TXDP)
/ethernet/P4_SSTX_AC_N: C127.2, U6.32 (USB3_RXDM)
/ethernet/P4_SSTX_AC_P: C126.2, U6.31 (USB3_RXDP)
/ethernet/REF_EXT: R70.1, U6.47 (REF_REXT)
/ethernet/REF_FILT: C122.1, U6.48 (REF_FILT)
/ethernet/USB_RBIAS: R71.1, U6.37 (USBRBIAS)
GND: C120.2, C121.2, C122.2, C123.2, C124.2, C125.2, J7.1 (SHIELD_REF), J7.SH (SHIELD), R70.2, R71.2, U6.34 (TEST), U6.43 (PME_MODE/GPIO7), U6.49 (VSS), Y2.2 (G), Y2.4 (G); also elsewhere on the board
unnamed: J7.11 (LED_GRN_A), R88.2
unnamed: J7.14 (LED_YEL_A), R89.1
P4_DN: U6.27 (USB2_DM); also elsewhere on the board
P4_DP: U6.26 (USB2_DP); also elsewhere on the board
P4_SSRX_N: C128.1; also elsewhere on the board
P4_SSRX_P: C129.1; also elsewhere on the board
P4_SSTX_N: C126.1; also elsewhere on the board
P4_SSTX_P: C127.1; also elsewhere on the board
PRT_CTL4: C123.1, R72.2, U6.35 (RESET_N/PME_CLEAR); also elsewhere on the board

Notes on the sheet:
MagJack J7
USB-C Dock with Gigabit Ethernet — Rev A
LAN7800 — USB to 1000BASE-T
