Mehdi-Ldj/usb3-dock/hardware/rev-a/usb3-dock.kicad_pcb

## KiCad design hardware/rev-a/usb3-dock.kicad_pcb (continued)

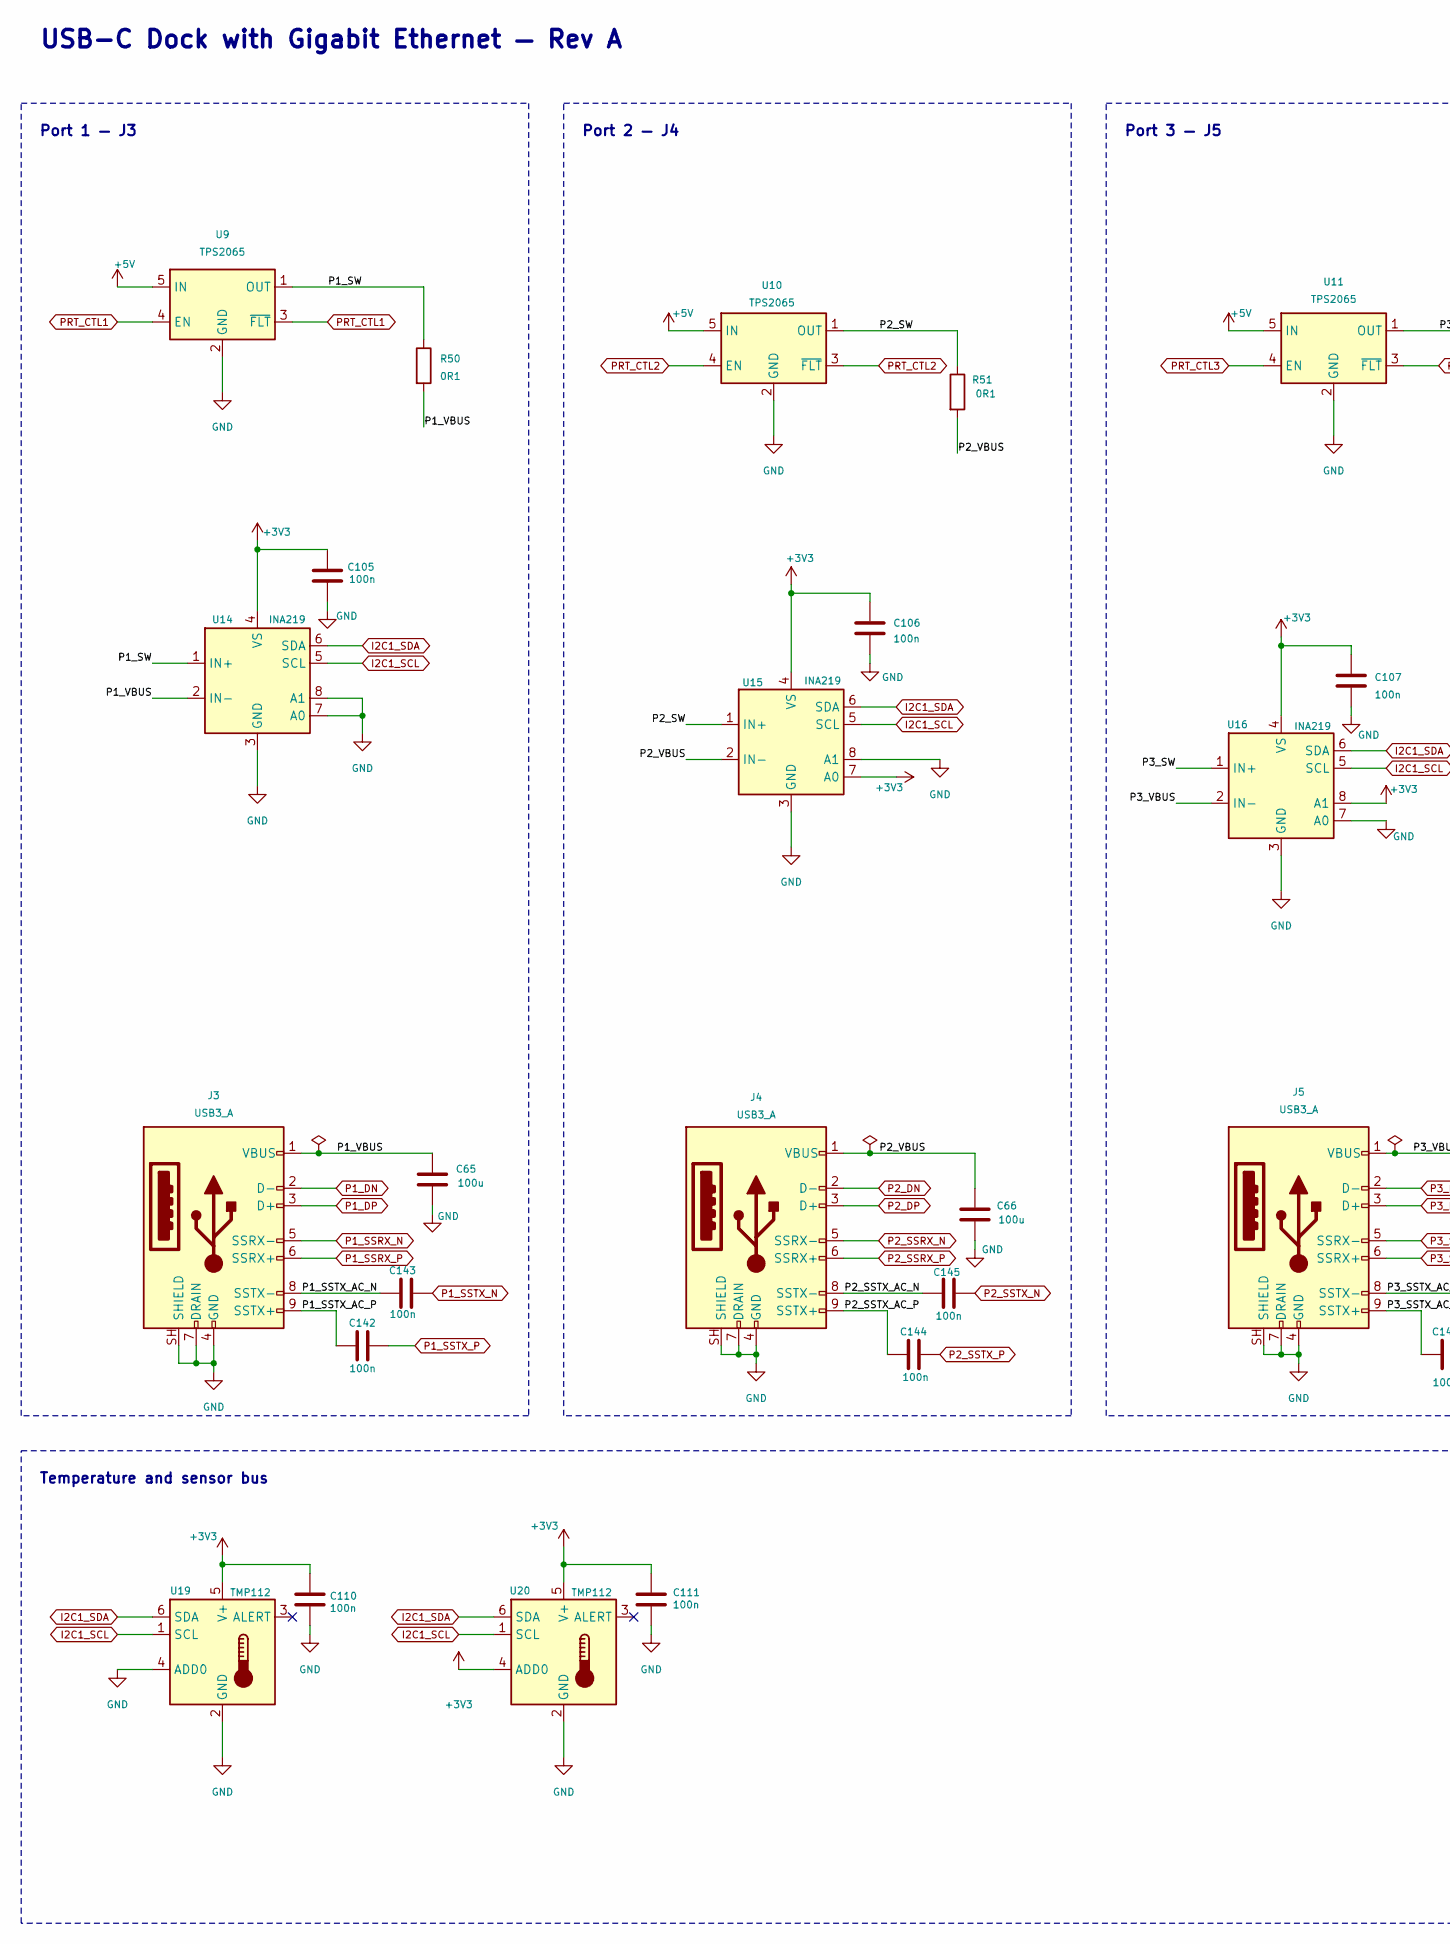
[picture p32: schematic downstream.kicad_sch, USB-C Dock with Gigabit Ethernet, part in row 1, column 1]

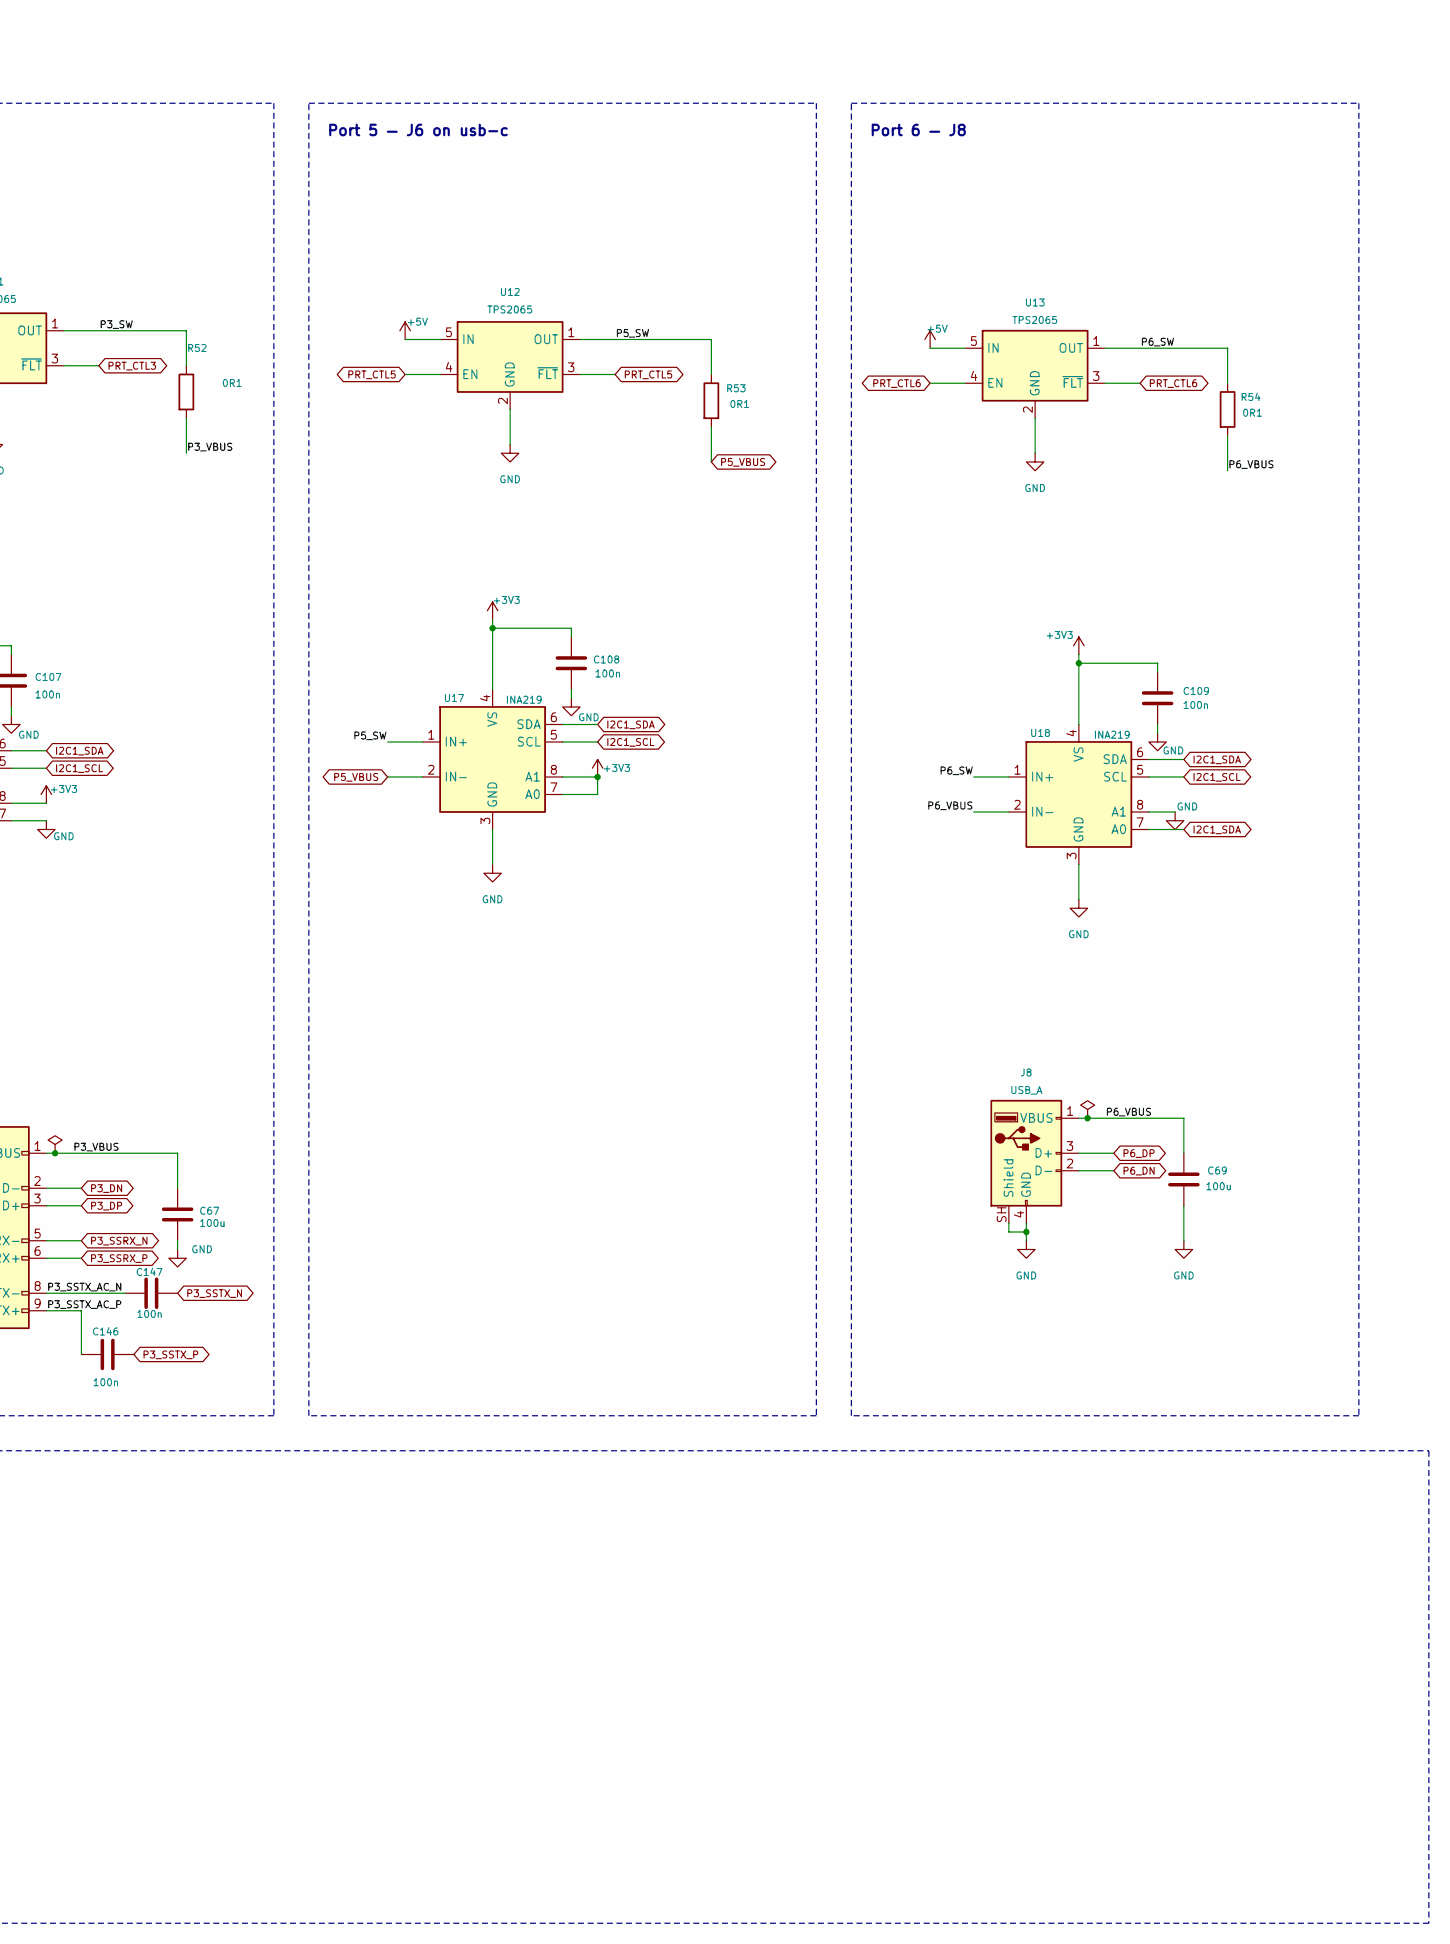
[picture p33: schematic downstream.kicad_sch, USB-C Dock with Gigabit Ethernet, part in row 1, column 2]

Parts:
C65, C66, C67, C69: 100u; C_1210_3225Metric
C105, C106, C107, C108, C109, C110, C111, C142, C143, C144, C145, C146, C147: 100n; C_0402_1005Metric
J3, J4, J5: USB3_A; USB_A_Receptacle_XKB_U231-091N-4BLRA00-S
J8: USB_A; USB_A_Molex_67643_Horizontal
R50, R51, R52, R53, R54: 0R1; R_0805_2012Metric
U9, U10, U11, U12, U13: TPS2065; SOT-23-5
U14, U15, U16, U17, U18: INA219; SOT-23-8
U19, U20: TMP112; SOT-563

Connections:
+3V3: C105.1, C106.1, C107.1, C108.1, C109.1, C110.1, C111.1, U14.4 (VS), U15.4 (VS), U15.7 (A0), U16.4 (VS), U16.8 (A1), U17.4 (VS), U17.7 (A0), U17.8 (A1), U18.4 (VS), U19.5 (V+), U20.4 (ADD0), U20.5 (V+); also elsewhere on the board
+5V: U9.5 (IN), U10.5 (IN), U11.5 (IN), U12.5 (IN), U13.5 (IN); also elsewhere on the board
/downstream/P1_SSTX_AC_N: C143.1, J3.8 (SSTX-)
/downstream/P1_SSTX_AC_P: C142.1, J3.9 (SSTX+)
/downstream/P1_SW: R50.1, U9.1 (OUT), U14.1 (IN+)
/downstream/P1_VBUS: C65.1, J3.1 (VBUS), R50.2, U14.2 (IN-)
/downstream/P2_SSTX_AC_N: C145.1, J4.8 (SSTX-)
/downstream/P2_SSTX_AC_P: C144.1, J4.9 (SSTX+)
/downstream/P2_SW: R51.1, U10.1 (OUT), U15.1 (IN+)
/downstream/P2_VBUS: C66.1, J4.1 (VBUS), R51.2, U15.2 (IN-)
/downstream/P3_SSTX_AC_N: C147.1, J5.8 (SSTX-)
/downstream/P3_SSTX_AC_P: C146.1, J5.9 (SSTX+)
/downstream/P3_SW: R52.1, U11.1 (OUT), U16.1 (IN+)
/downstream/P3_VBUS: C67.1, J5.1 (VBUS), R52.2, U16.2 (IN-)
/downstream/P5_SW: R53.1, U12.1 (OUT), U17.1 (IN+)
/downstream/P6_SW: R54.1, U13.1 (OUT), U18.1 (IN+)
/downstream/P6_VBUS: C69.1, J8.1 (VBUS), R54.2, U18.2 (IN-)
GND: C65.2, C66.2, C67.2, C69.2, C105.2, C106.2, C107.2, C108.2, C109.2, C110.2, C111.2, J3.4 (GND), J3.7 (DRAIN), J3.SH (SHIELD), J4.4 (GND), J4.7 (DRAIN), J4.SH (SHIELD), J5.4 (GND), J5.7 (DRAIN), J5.SH (SHIELD), J8.4 (GND), J8.SH (Shield), U9.2 (GND), U10.2 (GND), U11.2 (GND), U12.2 (GND), U13.2 (GND), U14.3 (GND), U14.7 (A0), U14.8 (A1), U15.3 (GND), U15.8 (A1), U16.3 (GND), U16.7 (A0), U17.3 (GND), U18.3 (GND), U18.8 (A1), U19.2 (GND), U19.4 (ADD0), U20.2 (GND); also elsewhere on the board
I2C1_SCL: U14.5 (SCL), U15.5 (SCL), U16.5 (SCL), U17.5 (SCL), U18.5 (SCL), U19.1 (SCL), U20.1 (SCL); also elsewhere on the board
I2C1_SDA: U14.6 (SDA), U15.6 (SDA), U16.6 (SDA), U17.6 (SDA), U18.6 (SDA), U18.7 (A0), U19.6 (SDA), U20.6 (SDA); also elsewhere on the board
P1_DN: J3.2 (D-); also elsewhere on the board
P1_DP: J3.3 (D+); also elsewhere on the board
P1_SSRX_N: J3.5 (SSRX-); also elsewhere on the board
P1_SSRX_P: J3.6 (SSRX+); also elsewhere on the board
P1_SSTX_N: C143.2; also elsewhere on the board
P1_SSTX_P: C142.2; also elsewhere on the board
P2_DN: J4.2 (D-); also elsewhere on the board
P2_DP: J4.3 (D+); also elsewhere on the board
P2_SSRX_N: J4.5 (SSRX-); also elsewhere on the board
P2_SSRX_P: J4.6 (SSRX+); also elsewhere on the board
P2_SSTX_N: C145.2; also elsewhere on the board
P2_SSTX_P: C144.2; also elsewhere on the board
P3_DN: J5.2 (D-); also elsewhere on the board
P3_DP: J5.3 (D+); also elsewhere on the board
P3_SSRX_N: J5.5 (SSRX-); also elsewhere on the board
P3_SSRX_P: J5.6 (SSRX+); also elsewhere on the board
P3_SSTX_N: C147.2; also elsewhere on the board
P3_SSTX_P: C146.2; also elsewhere on the board
P5_VBUS: R53.2, U17.2 (IN-); also elsewhere on the board
P6_DN: J8.2 (D-); also elsewhere on the board
P6_DP: J8.3 (D+); also elsewhere on the board
PRT_CTL1: U9.3 (~FLT), U9.4 (EN); also elsewhere on the board
PRT_CTL2: U10.3 (~FLT), U10.4 (EN); also elsewhere on the board
PRT_CTL3: U11.3 (~FLT), U11.4 (EN); also elsewhere on the board
PRT_CTL5: U12.3 (~FLT), U12.4 (EN); also elsewhere on the board
PRT_CTL6: U13.3 (~FLT), U13.4 (EN); also elsewhere on the board

Notes on the sheet:
Port 2 — J4
Port 3 — J5
Port 6 — J8
Port 1 — J3
Temperature and sensor bus
USB-C Dock with Gigabit Ethernet — Rev A
Port 5 — J6 on usb-c

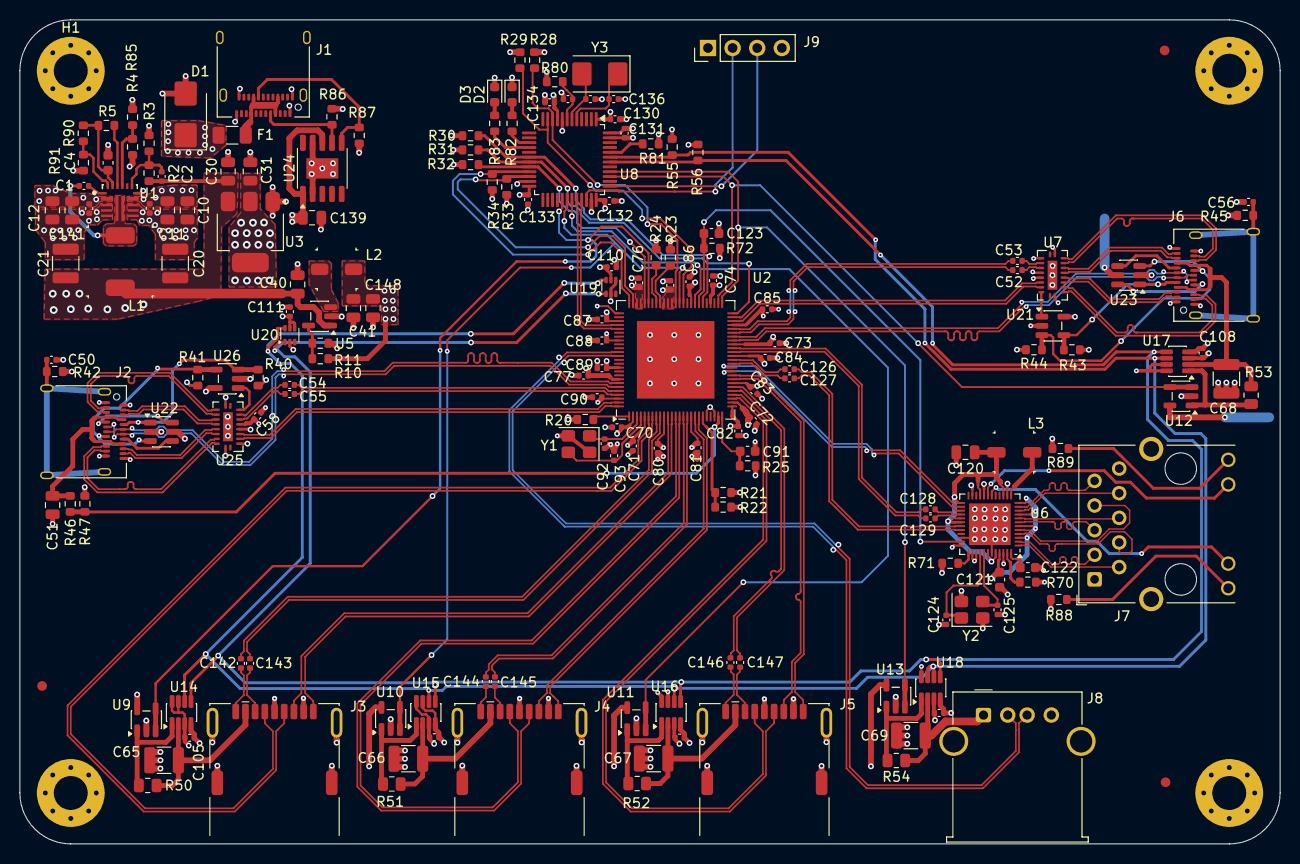
[picture p34: board usb3-dock.kicad_pcb from above]

Board: 4 copper layers, 130.0 x 85.0 mm, 182 parts (0 on the bottom side), 163 nets.
