Mehdi-Ldj/usb3-dock/(commit log)

2026-11-11 Rev A: USB-C dock with Gigabit Ethernet
    7-port USB 3.2 Gen 1 hub, Gigabit Ethernet, five measured and protected
    external ports. 130 x 85 mm, four layers on JLC04161H-3313, impedance
    controlled on 26 differential pairs. Routed and clean; not fabricated.
    [J3_XKB_U231-091N.stp, U1_TPS56C215_RNN0018A.stp, U2_USB5807C_VQFN100.step, U6_LAN7800_SQFN48.step, U7_HD3SS3212_RKS0020A.stp, downstream.kicad_sch, ethernet.kicad_sch, hub.kicad_sch]
2026-11-11 Drop the unused user layers
    Adhesive, drawings, comments, Eco1/Eco2 and the four user layers were enabled
    but empty, so they only cluttered the layer panel. In1/In2 carry the ground
    pours, so they are typed power rather than signal.
    Nothing on a plotted layer changed: the gerbers, drill file and job file are
    byte-identical to those in the v1.0 package.
    [usb3-dock.kicad_pcb]
2026-11-12 BOM: drop the C3 line from the departures
    C3 is on neither the power sheet nor the board — it did not survive into
    rev A — so the paragraph described a part nobody can order or place.
